luistorrerodri/EcoPlant-Platform/structure/concepto_visual.jpg

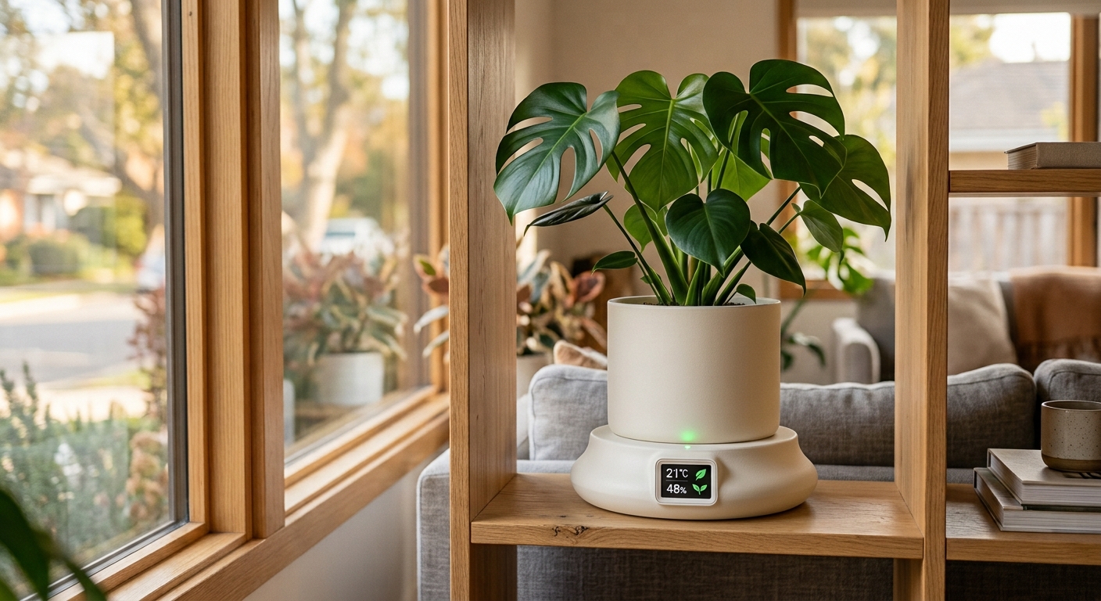
structure/concepto_visual.jpg
