luistorrerodri/EcoPlant-Platform/structure/preview/00_conjunto_dorso.png

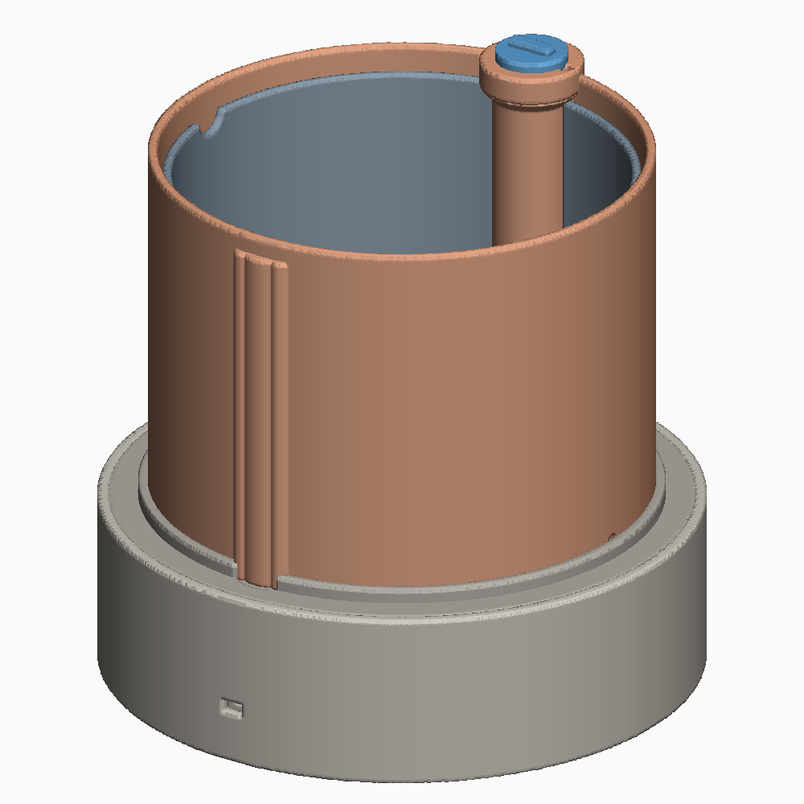
structure/preview/00_conjunto_dorso.png
