luistorrerodri/EcoPlant-Platform/README.md

# EcoPlant Platform 🌱

Plataforma IoT de riego inteligente para maceteros, construida de cero: desde el sensor hasta el dashboard, con la lógica de decisión centralizada en el servidor en lugar del microcontrolador.

Proyecto personal desarrollado como portfolio técnico durante un Máster en IoT, con el objetivo de cubrir el stack completo de un sistema IoT real: hardware, firmware, mensajería, persistencia de datos, visualización y control remoto.

## Qué hace

- Mide humedad de suelo y temperatura en tiempo real; el sensor de ambiente varía por dispositivo (presión atmosférica o humedad del aire, según el sensor que lleve cada uno — ver [`firmware/README.md`](firmware/README.md))
- Decide automáticamente cuándo regar según un umbral y una franja horaria configurables, **sin que la lógica viva en el microcontrolador**
- Verifica que cada orden de riego se ha ejecutado realmente, en lugar de asumirlo
- Detecta cuándo un dispositivo se desconecta de forma inesperada
- Comunicación cifrada con autenticación y autorización por dispositivo
- Permite riego manual bajo demanda desde la app móvil
- Guarda histórico de todas las lecturas para análisis posterior
- Pensado desde el diseño para escalar a múltiples dispositivos
- API multiusuario propia (registro, ubicaciones, dispositivos), consumida por una app móvil real (Android, misma base para iOS)
- Notificaciones push cuando un macetero se desconecta o termina de regar, a todos los móviles que comparten la cuenta, más un aviso semanal por macetero (domingo 11:00) con el último resumen de salud y un recordatorio de foto
- Estado conectado / sin conexión de cada macetero y historial de riegos (con etiqueta manual / automático) en la app
- Protección contra fuerza bruta en login y registro (bloqueo temporal por email e IP) y copia de seguridad cifrada de toda la plataforma hacia el PC
- Umbrales de riego y de estado personalizables por tipo de planta (catálogo de 43 tipos en 6 categorías: plantas, árboles, palmeras, hoja grande, colgantes y crasas), no un valor fijo para todas
- Consulta el pronóstico de lluvia antes de regar en exterior (Open-Meteo)
- Resumen periódico de salud de la planta (tiempo bajo el mínimo, saturación, ritmo de secado) a partir del histórico
- Calibración del sensor de humedad desde la app, sin reflashear el dispositivo
- Diagnóstico único de salud: combina el histórico de sensores con la última foto analizada por IA en un solo veredicto — si no hay foto, o la IA falla, cae automáticamente al diagnóstico por sensores sin perder nada
- Duración del riego también personalizable por tipo de planta, no solo los umbrales de humedad
- Pausa temporal del sensor (con lectura en vivo en la app) para poder moverlo o trasplantar la planta sin que un riego automático se dispare por error
- Ajuste automático (acotado y notificado) de la duración de riego de un dispositivo si el suelo sigue necesitando riego varios días seguidos pese al riego automático

## Arquitectura

```
     App móvil                              Grafana
(control, configuración,                  (histórico)
    diagnóstico)                               ▲
       │ HTTPS                                 │
       ▼                                   InfluxDB
Backend API (FastAPI + PostgreSQL)              ▲
       │          ▲                            │
       │ comando  │ config (polling 60s)        │
       ▼          │                            │
   Mosquitto (broker MQTT, mTLS) ────────► Node-RED
       ▲                              (decide riego automático,
       │ sensores / estado             formatea datos para InfluxDB)
       │
  ESP32 (sensores + bomba)
```

Todo corre sobre una Raspberry Pi en red local. El ESP32 **solo mide y ejecuta comandos** — nunca decide. La decisión de regar automático (umbral de humedad, franja horaria, tiempo desde el último riego) se evalúa en Node-RED a partir de la configuración que el backend le sirve (sondeada cada 60s desde Postgres), y publica un comando MQTT cuando corresponde; el riego manual y toda la configuración pasan por la app, no por Node-RED. Esta separación es la decisión de arquitectura central del proyecto: permite cambiar la lógica de riego, añadir machine learning más adelante, o gestionar decenas de dispositivos, sin volver a flashear ni un solo ESP32. Node-RED no tiene interfaz propia — es pura orquestación entre MQTT, InfluxDB y el backend (ver [`docs/architecture.md`](docs/architecture.md)).

Ver [`docs/architecture.md`](docs/architecture.md) para el detalle de cada decisión de diseño.

## Stack

| Capa | Tecnología |
|---|---|
| Sensores | sonda capacitiva de humedad de suelo + RTC DS1307 en todos los dispositivos; sensor de ambiente varía por dispositivo (BMP280 en `macetero01`, DHT22 en `macetero02` — ver [`firmware/README.md`](firmware/README.md)) |
| Microcontrolador | ESP32 DevKit (Arduino framework, PlatformIO) |
| Mensajería | MQTT (Mosquitto) |
| Orquestación / lógica | Node-RED |
| Persistencia | InfluxDB 2.x (series temporales) |
| Visualización | Grafana (histórico, escalable por dispositivo) |
| Servidor | Raspberry Pi (Debian Bookworm, ARM64) |
| Acceso remoto | Caddy (proxy, solo expone `/ui` y `/api/*`) + Cloudflare Tunnel |
| Backend API | Python + FastAPI, PostgreSQL |
| App móvil | React Native + Expo (TypeScript), notificaciones push vía Firebase/FCM |

## Estado actual

- [x] Hardware validado (sensores, RTC, OLED, bomba)
- [x] Firmware de producción: mide, publica por MQTT, obedece comandos
- [x] Pipeline completo de datos: ESP32 → MQTT → Node-RED → InfluxDB → Grafana
- [x] Control completo desde la app: riego manual, pausa de sensor, umbral y horario configurables en caliente (sin Node-RED Dashboard — retirado por redundante, ver `docs/architecture.md`)
- [x] Lógica de decisión de riego migrada completamente al servidor
- [x] Estructura de topics escalable para múltiples dispositivos (`device_id` dinámico)
- [x] Configuración persistente entre reinicios de la plataforma
- [x] Ciclo cerrado: el dispositivo confirma cada riego ejecutado
- [x] Detección de dispositivos desconectados (MQTT Last Will and Testament)
- [x] Firmware no bloqueante: el dispositivo sigue operativo durante el riego
- [x] Seguridad: autenticación por dispositivo, ACLs por topic y MQTT sobre TLS
- [x] Autenticación mutua (mTLS) con certificado por dispositivo
- [x] Acceso remoto seguro (reverse proxy con HTTPS): dashboard accesible desde fuera bajo demanda, sin abrir puertos en el router
- [x] Backend propio con modelo multi-usuario (usuario → ubicación → dispositivo)
- [x] App móvil: login, ubicaciones, dispositivos, histórico, riego manual y notificaciones push
- [x] Catálogo de tipos de planta: umbrales de riego y de estado relativos a cada tipo, no fijos
- [x] Integración meteorológica (Open-Meteo) para no regar en exterior si hay lluvia prevista
- [x] Resumen de salud de la planta (rules-based) y calibración del sensor de humedad desde la app
- [x] Diagnóstico visual con IA (foto + sensores), fusionado con el resumen por sensores en un único veredicto, con caída automática a sensores si no hay foto o la IA falla
- [x] Duración de riego y pausa temporal del sensor (con lectura en vivo), también personalizables por la app
- [x] Ajuste automático acotado de la duración de riego por dispositivo, a partir de su propio histórico de humedad, con notificación y tope configurable
- [x] Estado de conexión, historial de riegos manual/automático, varios móviles por cuenta y aviso semanal por macetero
- [x] Límite de intentos de login/registro y copia de seguridad cifrada (manual, hacia el PC)
- [ ] Ajuste de umbrales por tipo de planta a partir de histórico real agregado de todos los dispositivos (aprendizaje automático más amplio)

## Problemas reales resueltos

Una parte del valor de este proyecto está en los problemas de integración reales que surgieron y cómo se diagnosticaron — no solo en que "funcione". Detalle completo en [`docs/troubleshooting.md`](docs/troubleshooting.md), por ejemplo:

- **Sensor mal etiquetado**: un módulo vendido como BME280 resultó ser un BMP280 (sin sensor de humedad) tras leer su chip ID por I2C directamente — el fabricante había reutilizado la serigrafía.
- **Repositorio APT roto en Bookworm/ARM64**: fallo de verificación GPG persistente en el repositorio oficial de InfluxData para esa combinación de sistema, resuelto instalando desde el binario oficial con un servicio systemd propio en lugar de depender de `apt`.
- **Riegos en ráfaga**: al condicionar el riego a la confirmación del dispositivo, las órdenes se encolaron en el broker mientras el firmware bloqueaba. Resuelto con una ventana de guarda en la plataforma y, de raíz, con un firmware no bloqueante.
- **Dos implementaciones de TLS, dos criterios**: el mismo certificado era aceptado por un cliente y rechazado por el otro, primero por falta de SAN (Node.js ignora el Common Name) y después por el tipo de entrada del SAN (mbedTLS no evalúa las de tipo `iPAddress`). Resuelto con un certificado que satisface a ambas implementaciones.
- **Un ACL que deniega en silencio**: al añadir un topic MQTT nuevo, la configuración llegaba con éxito desde la app (`200 OK`) pero nunca al dispositivo — sin ningún error visible en ningún componente. Mosquitto descarta en silencio un publish/subscribe denegado por ACL; el fallo solo se confirmó leyendo el propio fichero de ACL en el servidor.
- **Un "nivel gratuito" que no lo era**: al integrar IA con visión para el diagnóstico de plantas, el proveedor elegido por tener plan gratuito devolvía `503` de forma sostenida — resultó ser el límite real de la cuenta disfrazado de aviso de capacidad, confirmado reproduciendo la misma petición fuera del código, directamente en la consola del proveedor.
- **Un patrón de años dejó de funcionar sin aviso**: subir una foto fallaba con `Unsupported FormDataPart implementation`, un error que no decía nada por sí solo. Causa real: un cambio de SDK sustituyó la implementación de `fetch` de la app, y la nueva ya no aceptaba el objeto `{uri, name, type}` que React Native lleva años usando para adjuntar ficheros — solo se detectó al ejecutar el código por primera vez en un dispositivo real, nunca falló en la compilación.
- **Un bug "arreglado" que seguía vivo en el extremo físico**: la duración de riego por tipo de planta se veía correcta en la app, la API y la base de datos — pero el ESP32 llevaba desde el primer despliegue regando siempre los mismos 9 segundos fijos, porque el firmware nunca llegó a leer ese valor del canal de configuración. Solo se descubrió cronometrando el riego real contra lo configurado, días después de dar el fix anterior por cerrado.
- **Un campo "relleno" que no se veía en pantalla**: en Android, un `TextInput` controlado a veces no pintaba el valor real tras cargarlo de forma asíncrona, aunque el estado de React ya lo tuviera — el dato estaba bien, la vista nativa simplemente no se actualizaba. Se resolvía solo al salir y volver a entrar (remontando el componente), lo que apuntó directamente a la solución: forzar ese remontaje con un `key` que cambia justo cuando los datos reales llegan.
- **Una hora que mentía sin avisar**: los riegos registrados salían con 1-2 h de adelanto. El RTC del ESP32 guarda la hora local de Madrid, pero `unixtime()` la presenta como si fuera UTC — un número "correcto" con la zona horaria equivocada, que nadie había visto porque ninguna pantalla mostraba esa hora hasta construir el historial. Corregido en el backend (sin reflashear) y con migración de los datos ya guardados.

## Estructura del repositorio

- [`firmware/`](firmware/) — código del ESP32 y guía de compilación/flasheo
- [`platform/`](platform/) — configuración de Node-RED, Grafana, y guía de instalación del stack en Raspberry Pi
- [`backend/`](backend/) — API multiusuario (FastAPI + PostgreSQL): usuarios, ubicaciones, dispositivos
- [`mobile/`](mobile/) — app móvil (React Native + Expo): consume la API del backend
- [`docs/`](docs/) — arquitectura, hardware, troubleshooting y roadmap detallados
- [`structure/`](structure/) — diseño CAD paramétrico del macetero físico (carcasa de impresión 3D), en Python/numpy; diseño verificado geométricamente pero aún sin imprimir

## Autor

Luis — Ingeniero de Telecomunicaciones, cursando Máster en IoT.

## Licencia

Repositorio publicado como portfolio técnico personal, con todos los derechos reservados — no es software de código abierto. Ver [`LICENSE`](LICENSE) para el detalle. Se puede consultar libremente con fines de evaluación (por ejemplo, procesos de selección), pero no reutilizar, copiar ni redistribuir sin autorización.
