luistorrerodri/EcoPlant-Platform/docs/architecture.md

# Arquitectura

## Principio de diseño central

**El ESP32 no decide nada.** Mide sensores, los publica por MQTT, y ejecuta un comando de riego cuando lo recibe — nada más. Toda la lógica (¿hay que regar ahora?, ¿qué umbral aplica?, ¿está dentro de la franja horaria permitida?) vive en el servidor, en Node-RED.

Esta decisión se tomó desde el inicio del proyecto, no como una refactorización posterior, y condiciona el resto de decisiones de arquitectura:

- **Escalabilidad**: añadir un macetero nuevo no requiere cambiar la lógica de decisión, solo dar de alta su configuración en el servidor.
- **Iteración rápida**: cambiar el umbral de riego, la franja horaria, o mañana un modelo de ML que decida en función del histórico, no requiere volver a flashear ningún dispositivo.
- **Mantenibilidad**: el firmware del ESP32 se mantiene simple y estable en el tiempo; la complejidad crece del lado del servidor, donde es más fácil de testear, versionar y depurar.

## Flujo de datos

1. El ESP32 lee sensores (humedad de suelo, temperatura, y un sensor de ambiente que varía por dispositivo — presión o humedad del aire, ver más abajo) cada 4 segundos y los publica como JSON en el topic MQTT `maceteros/{device_id}/sensores`.
2. Mosquitto (broker MQTT, corriendo en la Raspberry Pi) distribuye ese mensaje a quien esté suscrito.
3. Node-RED, suscrito a `maceteros/+/sensores` (comodín que captura cualquier dispositivo):
   - Reenvía los campos numéricos a InfluxDB para histórico.
   - Evalúa si toca regar, comparando la humedad recibida contra la configuración guardada (umbral, franja horaria, tiempo desde el último riego automático), configuración que el propio backend le sirve mediante un sondeo periódico (ver "Catálogo de tipos de planta..." en [`../platform/README.md`](../platform/README.md)).
4. Si la evaluación decide regar, Node-RED publica `REGAR` en `maceteros/{device_id}/comando`, construyendo el topic dinámicamente a partir del dispositivo que originó la lectura.
5. El ESP32, suscrito a ese topic, activa el relé de la bomba durante un tiempo fijo al recibir el comando — sin evaluar nada, solo ejecuta — y publica una confirmación en su topic de estado al terminar.
6. En paralelo, el riego manual desde la app publica exactamente ese mismo comando (`POST /api/devices/{id}/water` → backend → MQTT), reutilizando el mismo camino que el riego automático. Node-RED no tiene ningún control propio — ver la nota "Reparto final" más abajo.

## Por qué estas tecnologías

**MQTT sobre HTTP/REST**: bajo consumo, pensado para dispositivos con recursos limitados, y el patrón publicador/suscriptor encaja de forma natural con "muchos sensores publicando, un servidor escuchando" — especialmente de cara a escalar a múltiples dispositivos sin que cada uno necesite saber quién más existe.

**Node-RED como capa de orquestación**: permite iterar la lógica de negocio (reglas de riego, transformación de datos) de forma visual y rápida, sin recompilar nada, y tiene soporte de primera clase tanto para MQTT como para InfluxDB.

**InfluxDB (series temporales) en vez de una base de datos relacional para las lecturas**: los datos de sensores son fundamentalmente series temporales — una lectura, un timestamp, repetido miles de veces. InfluxDB está optimizado para ese patrón de escritura y consulta (agregaciones por ventana de tiempo, retención automática) de una forma en la que una base relacional genérica no lo está.

**Grafana para histórico, Node-RED Dashboard para control (decisión original, superada — ver nota 2026-10-02 más abajo)**: separación deliberada en las primeras semanas del proyecto, cuando el dashboard de Node-RED era el único control disponible, antes de que existiera la app. Grafana es una herramienta de solo lectura pensada para visualización de series temporales; forzarla a hacer control (botones, escritura) habría forzado su diseño. Node-RED, en cambio, ya tiene acceso directo a MQTT y al contexto de configuración, así que el control vivía ahí de forma natural en ese momento.

**Reparto final (2026-10-02): app = control, Grafana = histórico, Node-RED = orquestación pura.** El control real (riego manual, pausa de sensor, configuración por dispositivo) pasó a la app en cuanto existió, dejando el dashboard de Node-RED como una visualización redundante — un panel hardcodeado a `macetero01` que no escalaba a un segundo dispositivo sin duplicar paneles a mano. Se retiró por completo (gauges, gráfica, y un cluster de config muerto — un slider/desplegables que escribían una variable que el poller real sobreescribía cada 60s, detalle completo en `platform/README.md` § "Limpieza de Node-RED") en favor de Grafana, que con una variable de dispositivo (`${device}`, alimentada dinámicamente desde `v1.tagValues()`) sí escala a cualquier número de dispositivos sin tocar el dashboard. Node-RED se queda únicamente como lo que el título de esta sección ya decía que era: orquestación (MQTT ↔ InfluxDB ↔ backend), sin interfaz propia de usuario.

## Esquema de topics MQTT

```
maceteros/{device_id}/sensores    → publica el ESP32, escucha la plataforma
maceteros/{device_id}/comando     → publica la plataforma, escucha el ESP32
maceteros/{device_id}/estado      → publica el ESP32 (presencia y confirmaciones)
```

El `device_id` se define en el firmware con un único `#define`, a partir del cual se construyen los topics y el identificador de cliente MQTT. Desplegar el mismo firmware en un dispositivo nuevo requiere cambiar esa única línea.

La plataforma se suscribe con los comodines `maceteros/+/sensores` y `maceteros/+/estado`, de modo que recibe automáticamente los datos de cualquier dispositivo nuevo sin cambios de configuración. El `device_id` se extrae del propio payload (el firmware lo incluye) o, como respaldo, del segundo nivel del topic.

## Ciclo cerrado de riego

La orden de riego no se considera cumplida hasta que el dispositivo lo confirma:

1. La plataforma publica `REGAR` en el topic de comando del dispositivo.
2. El ESP32 acciona el relé y, al terminar, publica en su topic de estado un evento `riego_completado` con la duración real medida.
3. La plataforma registra ese evento como el último riego efectivo del dispositivo.
4. La condición de "han pasado 24 h desde el último riego" se evalúa contra la **confirmación**, no contra la orden.

La consecuencia práctica es que si un dispositivo está apagado o no responde, la plataforma no da el riego por hecho y lo reintentará cuando vuelva a estar disponible. Para evitar que ese reintento se convierta en una ráfaga de órdenes, existe además una ventana mínima de 60 segundos entre comandos consecutivos al mismo dispositivo, independiente de la confirmación.

### Detección de presencia (LWT)

Al conectarse, cada dispositivo registra en el broker un mensaje *Last Will and Testament*: si la conexión se pierde de forma abrupta (corte de alimentación, cuelgue, pérdida de WiFi), el propio broker publica `{"online": false}` en el topic de estado del dispositivo. Tras una conexión exitosa, el dispositivo publica `{"online": true}`.

Ambos mensajes se publican con el flag *retained*, de modo que cualquier suscriptor que se conecte después conoce inmediatamente el estado actual de cada dispositivo sin esperar al siguiente mensaje.

### Pausa temporal del sensor

Mover la planta o manipular físicamente la sonda de humedad produce lecturas falsas (p. ej. el sensor al aire marca "muy seco"), que sin ninguna protección dispararían un riego automático no deseado. `POST /api/devices/{id}/pause-sensor` fija `devices.sensor_pausado_hasta` a 10 minutos en el futuro (duración fija en servidor, no configurable por request); mientras ese instante no haya pasado, `GET /api/internal/device-configs` expone `sensorPausado: true` y el nodo "Decisión riego" de Node-RED se abstiene de evaluar riego para ese dispositivo — mismo patrón que ya usa `lluviaPrevista`, un booleano más que Node-RED lee sin saber nada de por qué.

Autoexpira por timestamp, sin necesitar ningún job en segundo plano: pasados los 10 minutos, la siguiente consulta a `device-configs` ya lo ve como `false` por sí sola. `POST /api/devices/{id}/resume-sensor` permite reanudar antes de tiempo. No hace falta tocar el firmware para nada de esto: el OLED del dispositivo ya muestra la humedad de suelo en vivo en su propia rotación de pantallas, pero esa rotación (~20s por pantalla) es demasiado lenta para seguir el valor mientras se reposiciona la sonda a mano — así que el feedback "en tiempo real" vive en la app, no en el OLED: mientras `sensorPausado` está activo, `DeviceDetailScreen.tsx` baja el `refetchInterval` de `GET /devices/{id}/latest-readings` de 15s a 3s (ver más abajo § "Calibración del sensor de humedad" — es el mismo endpoint sin agregar, no el histórico de `/readings`), lo bastante rápido para notar el cambio al mover la sonda sin tocar el firmware ni añadirle lógica nueva.

## Diseño del firmware

El `loop()` del ESP32 no bloquea en ningún punto de su operación normal. El riego se implementa como una pequeña máquina de estados basada en `millis()`:

- Al recibir un comando, se activa el relé y se registra el instante de inicio.
- En cada vuelta del `loop()` se comprueba si ha transcurrido la duración configurada; si es así, se apaga el relé y se publica la confirmación.
- Una orden que llegue mientras hay un riego en curso se descarta, en lugar de encolarse.

La consecuencia es que durante el riego el dispositivo sigue publicando lecturas, procesando mensajes MQTT y manteniendo su conexión. La implementación anterior, basada en `delay()`, dejaba al ESP32 insensible durante todo el pulso de riego, lo que provocó que las órdenes se acumularan en el broker y se ejecutaran en cadena (ver [`troubleshooting.md`](troubleshooting.md#9-riegos-en-ráfaga-al-introducir-la-confirmación-del-dispositivo)).

Adicionalmente existe un tope de seguridad por hardware lógico: la duración efectiva del riego se acota a un máximo absoluto, de modo que un valor de configuración erróneo no puede dejar la bomba encendida indefinidamente.

## Seguridad

La plataforma aplica tres capas independientes sobre la comunicación con los dispositivos.

### Autenticación

El broker no admite conexiones anónimas, y cada cliente demuestra su identidad con un **certificado propio** (autenticación mutua, mTLS) en lugar de usuario y contraseña: la plataforma tiene el suyo y **cada dispositivo el suyo**, todos firmados por la misma CA. El CN del certificado (`nodered`, `macetero01`...) es lo que el broker usa como identidad para las ACLs. Esta separación permite revocar el acceso de un macetero concreto —por ejemplo, si se pierde o se ve comprometido— sin afectar al resto del sistema, y elimina de paso el riesgo de una contraseña filtrada: no hay contraseña que filtrar.

### Autorización

La autenticación por sí sola no basta: un dispositivo legítimo no debe poder leer los datos de otros ni emitir órdenes. Las ACLs del broker restringen cada identidad a su ámbito:

```
user nodered
topic readwrite maceteros/#

user macetero01
topic write maceteros/macetero01/sensores
topic write maceteros/macetero01/estado
topic read  maceteros/macetero01/comando
topic read  maceteros/macetero01/config
```

La asimetría es deliberada: el dispositivo **publica** sus lecturas y su estado, pero solo **lee** comandos. Emitir órdenes de riego es privilegio exclusivo de la plataforma, incluso sobre el propio dispositivo.

### Cifrado en tránsito

Toda la comunicación MQTT viaja sobre TLS 1.2 en el puerto 8883. El puerto 1883 (sin cifrar) está cerrado.

Se emplea una **autoridad certificadora propia**: la CA firma el certificado del broker, y cada dispositivo lleva embebido el certificado de la CA para verificar que se conecta al broker legítimo y no a un suplantador. Es el mismo modelo de confianza de HTTPS, con la organización actuando como autoridad en lugar de una CA pública.

La clave privada de la CA vive en la propia Raspberry Pi (`~/certs/ca.key`), cifrada con una contraseña que solo conoce el operador — no está en texto plano ni la usa ningún servicio en su día a día, solo se necesita para firmar certificados nuevos. Es una mitigación razonable (un archivo robado no sirve de nada sin la contraseña) pero no equivale a mantenerla en una máquina separada del servidor: si la Pi se viera comprometida durante un tiempo prolongado, la contraseña podría capturarse la próxima vez que se usara. Moverla a una máquina offline queda como mejora pendiente.

La verificación es **mutua**: el dispositivo comprueba la identidad del broker (con `CA_CERT`) y el broker comprueba la identidad del dispositivo (con su certificado de cliente, `CLIENT_CERT`/`CLIENT_KEY`, firmado por la misma CA). El broker exige ese certificado antes de completar el handshake (`require_certificate`) y deriva la identidad de su CN en lugar de un usuario/contraseña (`use_identity_as_username`) — es el estándar en despliegues IoT de producción. Detalle de la generación de certificados de cliente en [`../platform/README.md`](../platform/README.md#certificados-de-cliente-mtls).

**Limitación conocida**: no hay lista de revocación (CRL). Revocar un dispositivo hoy es quitar su bloque de la ACL — el certificado seguiría siendo válido para TLS, pero sin ACL no podría hacer nada. Si una clave privada se comprometiera de verdad, la única garantía completa es regenerar la CA.

### Validez temporal

TLS valida el periodo de vigencia de los certificados, lo que exige que el dispositivo conozca la fecha real. El ESP32 sincroniza por NTP al arrancar, con la zona horaria peninsular y sus reglas de cambio estacional, y actualiza el RTC con esa referencia. El RTC queda como respaldo para operar sin red.

Esto resolvió además un problema anterior: la franja horaria de riego dependía de la hora del RTC, que podía quedar desajustada tras un reinicio.

### Acceso a los servicios

`adminAuth` protege el editor de flujos de Node-RED — solo el operador (Luis) tiene acceso, nunca el usuario final. Desde que el dashboard de Node-RED se retiró por completo (2026-10-02, ver "Reparto final" más arriba), `httpNodeAuth` ya no protege ninguna página de cara al usuario — el usuario final consulta su planta y riega exclusivamente por la app, que tiene su propia autenticación (JWT) completamente separada de Node-RED.

### Acceso remoto

El dashboard puede mostrarse desde fuera de la red local bajo demanda, sin exponer nada de forma permanente. Dos decisiones deliberadas:

- **Cloudflare Tunnel en vez de abrir un puerto en el router**: la Pi inicia una conexión saliente hacia Cloudflare; no hay ningún puerto escuchando conexiones entrantes desde internet en el router. Elimina de raíz la superficie de ataque típica de un port-forwarding casero (escaneos automatizados de puertos abiertos), a cambio de depender de un tercero para la ruta de acceso.
- **Un proxy local (Caddy) delante de Node-RED, no el túnel apuntando directamente a él**: Node-RED sirve el editor, la API de administración y el dashboard bajo la misma raíz, sin una separación de rutas pensada para exponer solo una parte. Caddy filtra por ruta y solo reenvía `/ui`, devolviendo 404 a cualquier otra cosa — así, aunque alguien obtenga la URL pública, lo único alcanzable es el dashboard, nunca el editor de flujos.

El túnel de `/ui` (Quick Tunnel) se levanta manualmente para cada demo — mientras no está corriendo, no hay nada expuesto a internet por ahí. **Nota 2026-10-02**: desde que se retiró por completo el dashboard de Node-RED (ver "Reparto final" más arriba), `/ui` ya no tiene ningún contenido que mostrar — la infraestructura (Caddy, el Quick Tunnel) se ha dejado tal cual, sin desmontar, pero hoy es una demo de una página vacía. Pendiente de decidir: desmontarla del todo, o reutilizar esa ruta para otra cosa. Con la app móvil llegó un segundo túnel, este sí permanente: dominio propio (`ecoplantplatform.com`) + túnel de Cloudflare con nombre, exponiendo solo `api.ecoplantplatform.com` → Caddy → backend. Tiene sentido que este segundo sí esté siempre activo, porque ahora hay una app de uso real detrás, no solo demos puntuales — ver [`../platform/README.md`](../platform/README.md#5-acceso-remoto-demo-pública-bajo-demanda) para ambos.

Grafana e InfluxDB emplean su propia autenticación, con el registro de usuarios deshabilitado y sin acceso anónimo.

### Protección contra fuerza bruta en login y registro (2026-10-26)

Con `api.ecoplantplatform.com` accesible 24/7, `POST /api/auth/login` y `/register` llevan límites propios (`backend/app/services/rate_limit.py`, en memoria del proceso — el backend es un único proceso `uvicorn`, así que no hace falta Redis):

- **5 fallos de login por email → ese email queda bloqueado 15 minutos**, incluso con la contraseña correcta mientras dura el bloqueo (si no, el bloqueo no frenaría nada). 5 y no 3: con 3, un despiste al teclear dejaría fuera a cualquiera de la familia, y un bloqueo corto basta para pasar de miles de intentos por hora a unos 20.
- **~20 fallos por IP en 15 minutos → esa IP bloqueada 15 minutos** (más holgado porque varias personas pueden compartir conexión).
- **Registro: máximo 5 por hora y por IP.**
- Respuesta `429` con `Retry-After` y mensaje en español ("Demasiados intentos. Vuelve a probar en N min."), que la app muestra tal cual. Un login con un email que no existe tarda lo mismo que uno con contraseña errónea (se verifica contra un hash falso), para no revelar qué emails están registrados; un login correcto solo resetea el contador de ese email, nunca el de la IP.
- **IP real detrás de Cloudflare**: el backend solo ve a `127.0.0.1` (Caddy/cloudflared). La IP del cliente se lee de `CF-Connecting-IP`, y esa cabecera **solo se acepta cuando el par directo es loopback** — desde la LAN, donde la app puede hablar directamente con la API, alguien podría falsificarla para evadir el límite por IP, pero el límite por email sigue valiendo igual. Los contadores se vacían al reiniciar el backend, y las claves recordadas están acotadas (10 000) para que probar millones de emails distintos no pueda llenar la memoria.

Las credenciales de los nodos de Node-RED se cifran con una clave propia (`credentialSecret`) en lugar de una autogenerada, de modo que una copia de seguridad de los flujos es restaurable en otra máquina.

## Modelo de datos en InfluxDB

- **Measurement**: `sensores`
- **Tag**: `device_id`
- **Fields**: `humedad_suelo`, `humedad_suelo_raw`, `temp_aire`, `presion`, `temp_suelo`, `estado`, `humedad_ambiente`

**No todos los dispositivos publican todos los campos de ambiente, a propósito.** `macetero01` lleva un BMP280 (`temp_aire`, `presion`, sin humedad); `macetero02` lleva un DHT22 (`temp_aire`, `humedad_ambiente`, sin presión) — ver [`../firmware/README.md`](../firmware/README.md) para qué sensor lleva cada dispositivo. Un campo que un dispositivo no mide nunca se publica con un valor falso (ni `0` ni `null` fabricado) — simplemente no aparece en su JSON, y como InfluxDB no exige un esquema fijo por punto, esa ausencia no genera ningún error en ningún punto de la cadena (Node-RED → InfluxDB → `NUMERIC_FIELDS` del backend → la app, que oculta el dato en vez de enseñar un "—" permanente o un cero). Es la misma lógica que ya aplicaba a `temp_suelo` cuando el DS18B20 está desconectado, extendida ahora a "distintos dispositivos pueden tener distintos sensores", no solo "un sensor puede fallar".

`humedad_suelo_raw` es la lectura cruda del ADC (sin convertir a porcentaje) — no se expone en el histórico ni en las gráficas de la app (no está en la lista blanca `NUMERIC_FIELDS` del backend), solo la usa internamente el endpoint de calibración del sensor (`POST /api/devices/{id}/calibrate`, ver "Calibración del sensor de humedad" más abajo) para capturar el punto seco/húmedo en el momento.

La distinción entre tag y field es deliberada. En una base de datos de series temporales, cada combinación única de tags genera una serie independiente: los tags están pensados para metadatos estables por los que se filtra y agrupa, no para valores que cambian con cada lectura.

Inicialmente `estado` (SECO / HUMEDO / OK…) se modeló como tag, lo que fragmentaba la serie de humedad en tantas series como estados posibles, cortando las gráficas cada vez que la planta cambiaba de estado. Se corrigió moviéndolo a field: además de resolver la fragmentación, es coherente con el hecho de que `estado` es un valor **derivado** de `humedad_suelo` mediante umbrales, no un dato independiente.

## Configuración persistente y editable

Los parámetros de cada macetero (umbral de humedad, franja horaria de riego permitido, duración del pulso de riego, tipo de planta) viven en PostgreSQL, como columnas de `devices` — editables desde la app vía `PATCH /api/devices/{id}`. Node-RED sigue siendo quien decide si riega (`Decisión riego`, sección "Ciclo cerrado de riego"), pero ya no es la fuente de verdad de la configuración: cada 60 segundos sondea `GET /api/internal/device-configs` (backend, `127.0.0.1:8000`, nunca sale de loopback) y vuelca la respuesta en su *global context* (`config_maceteros`), con exactamente la misma forma que tenía antes de esta migración:

```javascript
{
  "macetero01": {
    "humedadMin": 36,
    "horaInicio": 8,
    "horaFin": 21,
    "duracionRiegoMs": 9000
  }
}
```

Esta estructura, indexada por dispositivo desde el primer momento aunque hoy solo exista un macetero, es la que permite que escalar a múltiples dispositivos sea añadir una entrada al objeto, no rediseñar el sistema.

**Por qué un sondeo HTTP y no un nodo de Postgres en Node-RED ni una API nueva expuesta por Node-RED**: mover la configuración a Postgres exigía elegir quién habla con quién. Añadir un nodo de Postgres a Node-RED habría metido credenciales de base de datos en un sitio que hoy no las tiene, y construir una API nueva *dentro* de Node-RED habría ido contra el reparto de responsabilidades ya establecido (Node-RED es lógica de decisión + dashboard; FastAPI es la única superficie de API). Con un sondeo HTTP del lado de Node-RED hacia un endpoint del backend, el nodo **"Decisión riego"** — la automatización real, controlando una bomba física — no se toca en absoluto: solo cambia de dónde se rellena la variable que ya leía.

**`GET /api/internal/device-configs`** no usa el JWT de usuario del resto de la API — Node-RED no inicia sesión como nadie — sino un token estático compartido (cabecera `X-Internal-Token`, comparado con `secrets.compare_digest`), primer mecanismo de credencial de servicio a nivel HTTP en el backend. Es análogo a la identidad `backend-api` que ya existía en mTLS/MQTT (un servicio con su propia identidad, distinta de usuarios y dispositivos), solo que a nivel HTTP en vez de certificados. El riesgo real es bajo porque el tráfico nunca sale de `127.0.0.1` (Node-RED y el backend están en la misma Pi) — no pasa por Caddy, Cloudflare, ni el dominio público — pero el token evita que sea un endpoint abierto sin más dentro de esa confianza.

Elegir un tipo de planta desde la app (catálogo en `plant_types`, ver más abajo) solo rellena estos mismos campos con valores por defecto — se pueden seguir editando a mano después, y el ciclo de riego nunca lee el catálogo directamente, solo los valores ya copiados a `devices`.

## Calibración del sensor de humedad

Igual que los umbrales de riego, la calibración del sensor capacitivo de humedad de suelo (dos valores de referencia: lectura ADC en seco y en húmedo) dejó de estar fija en firmware para pasar a ser configuración editable — mismo principio de "el servidor decide y guarda, el ESP32 solo aplica" que el resto de la configuración persistente.

Columnas `devices.soil_dry_raw`/`soil_wet_raw` en Postgres, con los mismos valores que ya llevaba el firmware a mano como `server_default` (así añadir las columnas no cambia nada hasta que alguien recalibra de verdad). Se capturan desde la app (`POST /api/devices/{id}/calibrate`, body `{"punto": "seco" | "humedo"}`): el endpoint lee el valor crudo más reciente publicado por el dispositivo (`humedad_suelo_raw`, ver el modelo de datos de InfluxDB más abajo) con una consulta puntual sin agregar — `aggregateWindow()` sirve para gráficas e histórico, no para "qué marca el sensor ahora mismo" — lo guarda, y empuja la nueva calibración al dispositivo por el mismo topic MQTT retained que ya llevaba `humedadMin`/`humedadMax` (`maceteros/{id}/config`). El ESP32 la aplica en `soilMoisturePercent()` sin decidir nada por su cuenta.

Consecuencia práctica: recalibrar el sensor (cambio de sonda, de sustrato, desgaste) ya no exige recompilar ni reflashear — solo sacar el sensor a secar al aire y sumergirlo en agua, pulsando un botón en cada paso desde la pantalla "Calibrar sensor" de la app.

El mismo principio ("consulta puntual sin agregar para *lo que marca el sensor ahora mismo*, no la misma función que alimenta las gráficas") se reutilizó para `GET /devices/{id}/latest-readings`: la fila-resumen de la app y el banner de pausa del sensor necesitan el valor real en vivo, no el último punto de una serie agregada a 10 minutos como la que usa `GET /readings` para pintar un histórico — ver troubleshooting #34.

## Diagnóstico visual de la planta con IA

Complementario al resumen de salud estadístico (no un reemplazo): hay síntomas que ningún sensor de suelo puede ver — hojas amarillas, plaga, marchitez. El usuario sube una foto desde la app; el backend la junta con un resumen de los últimos 5 días de sensores (humedad, temperaturas, riegos — mismo criterio de no mandar la serie en crudo que `aggregateWindow()` en `get_readings`) y se la manda a un modelo de IA con visión para una valoración cualitativa en texto, con su propio veredicto de tres niveles (`bien`/`revisar`/`preocupante`) — deliberadamente distinto del `HealthVerdict` del resumen estadístico, porque un síntoma visual como una plaga no encaja en categorías pensadas para umbrales de humedad.

**La app muestra un único diagnóstico, no dos tarjetas separadas** (cambio de 2026-10-01, puramente de presentación — ningún endpoint ni esquema cambió). El prompt ya le pide al modelo que mezcle foto y sensores en un solo mensaje y marque contradicciones entre ambos, así que cuando hay una foto analizada con éxito, su mensaje ya es el diagnóstico completo — la app simplemente lo muestra como la tarjeta principal. Solo cuando no existe ninguna foto analizada con éxito todavía (dispositivo nuevo, o la única foto que hubo nunca falló al analizarse) la app cae al resumen estadístico (`health_summaries`) como diagnóstico. Los dos veredictos (`PhotoVerdict`/`HealthVerdict`) siguen siendo tipos distintos en el backend a propósito (ver el porqué un párrafo más abajo) — la app elige cuál mostrar, no los funde en uno. Un intento fallido de analizar una foto *nueva* no degrada nada: como no se sobreescribe `plant_photo_diagnoses` hasta tener una respuesta válida (ver más abajo), la última foto analizada con éxito sigue siendo la que se muestra hasta que una foto nueva se analice bien del todo.

**Proveedor y modelo, en concreto**: [Groq](https://groq.com/) (`app/services/plant_vision.py`), un proveedor de inferencia que aloja modelos abiertos de terceros (no entrena sus propios modelos, sino que los sirve muy rápido sobre hardware propio, LPUs en vez de GPUs). El modelo usado es `qwen/qwen3.8-27b` — Qwen es la familia de modelos abiertos de Alibaba Cloud; esta es su variante de 27B de parámetros con soporte de visión (recibe imagen + texto), la única con visión que Groq ofrece en este momento. Plan gratuito real de Groq para este modelo (documentado, no un trial que caduca, sin tarjeta): **30 peticiones/minuto, 1.000 peticiones/día, 8.000 tokens/minuto, 200.000 tokens/día** — de sobra para un uso a demanda de una persona (unas pocas fotos por semana), muy por debajo del límite incluso en pruebas intensivas.

**Solo se guarda la última foto** (`plant_photo_diagnoses`, una fila por dispositivo, se sobreescribe) — pero antes de sobreescribirla se usa: si ya había una foto anterior, se le manda al modelo junto con la nueva para que compare evolución (mejor/igual/peor), no solo el estado puntual. La foto vive como `bytea` en Postgres, no en el filesystem de la Pi — es el primer y único blob binario del proyecto, y no justificaba inventar una convención de almacenamiento en disco nueva para un solo fichero pequeño que además se sobreescribe.

Es el primer punto del proyecto donde contenido real (la foto) sale hacia un servicio de IA de terceros — misma clase de decisión que Open-Meteo (API externa aceptada cuando aporta algo que no se puede hacer local).

**Historial real de proveedor, tres intentos antes de asentarse**: primero Claude (API de pago de Anthropic) — funcionaba bien, pero implicaba un gasto (céntimos al mes) que Luis prefería evitar para este uso a demanda. Se cambió a Gemini buscando coste cero, pero su nivel "gratuito" resultó estar topado de verdad para la cuenta usada (Google AI Studio mostró un aviso de "Upgrade to unlock more" tras varias pruebas — no era un pico de demanda puntual como parecía al principio con los primeros 503). La solución final es Groq: tiene un plan gratuito real y publicado (límites por día/minuto documentados, no un trial que caduca), sin tarjeta, en una cuenta distinta de Google que no arrastra el uso previo del intento anterior. Lección para cualquier integración futura con un "nivel gratuito" de terceros: confirmarlo probándolo de verdad con la cuenta real que se va a usar, no fiarse solo de lo que dice la documentación — el mismo "gratis" significa cosas distintas según el proveedor y según el historial de la cuenta concreta.

**Deliberadamente no autoajusta nada.** Se consideró ir más lejos y que el propio sistema ajustara `humedad_min`/`humedad_max`/duración de riego a partir del veredicto — descartado por dos motivos: con una sola planta y fotos a demanda, no hay ni de lejos histórico suficiente para que un ajuste automático tenga base real (mismo criterio que el punto 4 del roadmap, más abajo), y automatizar un cambio sobre un actuador físico (la bomba) sin que una persona lo confirme es el único punto del proyecto que, si se equivoca, hace daño real a la planta sin que nadie se entere a tiempo. Si en el futuro se construye, sería como sugerencia que el usuario aprueba, nunca aplicada sola.

## Backend multiusuario

Node-RED resuelve bien la orquestación (sensores, lógica de riego), pero no tiene ni tenía previsto tener un modelo de usuarios — en su momento, cuando todavía tenía un dashboard propio, cualquiera con la contraseña del `httpNodeAuth` veía y controlaba todos los dispositivos por igual, sin ningún concepto de "esta planta es mía". El backend nuevo (FastAPI + PostgreSQL, en `backend/`) añade esa capa por delante, sin sustituir nada de Node-RED — es una pieza aditiva, un peer de Node-RED, no un reemplazo (y acabó, con el tiempo, asumiendo también todo el control de cara al usuario que antes vivía en el dashboard de Node-RED, hoy retirado — ver "Reparto final" más arriba).

**Por qué una base de datos relacional aparte, y no extender el *context store* de Node-RED**: el modelo `usuario → ubicación → dispositivo` es fundamentalmente relacional (claves foráneas, restricciones de unicidad, permisos por propietario) — forzar eso sobre un almacén de pares clave-valor pensado para configuración de dispositivos habría sido más frágil que levantar una base de datos que ya está diseñada para este problema. PostgreSQL en concreto, y no SQLite, porque el resto de la plataforma ya trata "instalar el servidor de base de datos real como servicio systemd" como la norma (InfluxDB es el precedente directo), y porque SQLite con varios workers de `uvicorn` tiene un problema real de bloqueo de escritura de un solo archivo.

**Autenticación con tokens revocables, no solo un JWT de larga duración**: el token de acceso es un JWT de corta duración (30 min por defecto); el de refresco es un secreto aleatorio cuyo *hash* se guarda en una tabla (`refresh_tokens`), no el valor en sí — igual que una contraseña. Esto es lo que hace posible un logout real y que cambiar la contraseña invalide las sesiones activas: con un JWT de refresco puro (sin estado en el servidor), no hay forma de revocar nada antes de que expire por sí solo.

**El código de reclamación de dispositivos**: cada macetero es un objeto físico, preflasheado con un `DEVICE_ID` fijo — no hay forma de que se autoprovisione ni de que "sepa" a qué usuario pertenece. Para asociarlo a una cuenta hace falta un secreto compartido fuera de banda, igual que un certificado de cliente se entrega físicamente a un dispositivo: el operador siembra el dispositivo (`POST /api/admin/devices/seed`) y obtiene un código de un solo uso, que se hashea igual que una contraseña y se entrega por otro canal (una pegatina en el macetero, un mensaje al usuario). El propio usuario lo introduce junto al `device_id` para reclamarlo. Sin CRL ni revocación de certificados de por medio, es el mecanismo más simple que sigue exigiendo prueba de posesión física del dispositivo.

Sin envío de emails: el registro activa la cuenta al momento, sin verificación por correo ni recuperación de contraseña por email (hay un `change-password` para quien ya tiene sesión). Detalle completo del modelo de datos, endpoints y despliegue en [`../platform/README.md`](../platform/README.md#6-backend-api) y [`../backend/README.md`](../backend/README.md).

## App móvil

React Native + Expo (TypeScript), en `mobile/`. Consume la API del backend por HTTP igual que cualquier otro cliente futuro (un portal web usaría exactamente los mismos endpoints) — construir primero la API y después la app fue deliberado, no hay nada que rehacer al pasar de una a otra.

**React Native + Expo, no nativo por plataforma**: mismo código para Android e iOS. Con Expo además se puede compilar la build de iOS en la nube (EAS Build) sin poseer un Mac — relevante aquí, porque el desarrollo se hace desde Windows.

**JWT en `SecureStore`, nunca en `AsyncStorage`**: los tokens de acceso y refresco se guardan cifrados con el keychain/keystore del sistema operativo, coherente con cómo el propio backend trata esos mismos tokens (nunca en claro). Un interceptor en el cliente HTTP reintenta la petición una vez tras un `401`, refrescando el token en segundo plano — verificado de verdad bajando temporalmente `ACCESS_TOKEN_EXPIRE_MINUTES` en el backend en vez de asumir que el código estaba bien.

**URL del servidor configurable en tiempo de ejecución, no fija en el código**: se guarda en `SecureStore` y se edita desde la app. Por defecto apunta al dominio fijo (`api.ecoplantplatform.com`, dominio propio + túnel de Cloudflare con nombre, ambos permanentes) — funciona igual en casa o fuera sin tocar nada; la IP de la LAN sigue disponible como alternativa manual. Esta pieza fue la que evitó tener que duplicar trabajo entre "desarrollar en casa" y "usar la app fuera": se construyó una vez, y solo cambió el valor por defecto cuando el dominio estuvo listo.

**Notificaciones push (Firebase Cloud Messaging)**: el backend pasa de solo publicar en MQTT a también **suscribirse** a `maceteros/+/estado` (el ACL de `backend-api` ya lo permitía, pensado para esto desde que se creó el certificado). Al detectar una desconexión inesperada o un riego completado, resuelve el propietario del dispositivo (`Device.location.owner`) y le envía una notificación (a todos los móviles de su cuenta, ver "Estado, historial y notificación semanal") a través de la API pública de push de Expo, que a su vez usa Firebase Cloud Messaging por debajo. Requirió una build de desarrollo propia compilada con EAS: Expo retiró el soporte de notificaciones push en Android dentro de Expo Go a partir del SDK 53, y además Google exige credenciales FCM V1 propias (no vale la infraestructura compartida antigua) — la clave de administrador de Firebase para esto vive cifrada en EAS, nunca en el repositorio; solo `google-services.json` (contenido público, identifica la app pero no autoriza nada) está versionado.

**Acceso por LAN, además del túnel**: Caddy pasa a escuchar también en la IP de la Pi en la red local, no solo en `127.0.0.1` — mismo nivel de confianza que ya tenían Node-RED/Grafana/InfluxDB (nada expuesto a internet, sin *port-forwarding* en el router). Permite desarrollar y usar la app en casa sin depender de tener el túnel de Cloudflare levantado.

## Próxima iteración: personalización por planta, exterior y meteorología

Con el dominio fijo y el backend multiusuario ya en producción, el siguiente bloque de trabajo apunta a que la app sea más útil planta a planta, no solo dispositivo a dispositivo. Son cuatro piezas relacionadas pero independientes; se documentan juntas aquí porque comparten el mismo modelo de datos de partida (`Device`/`Location`), pero se construyen y se despliegan en fases separadas.

**1. Catálogo de tipos de planta con valores por defecto — construido.** Al editar un dispositivo, el usuario elige un tipo de planta (tabla `plant_types`, 43 entradas: el catálogo inicial de doce plantas comunes de huerto/interior más un "personalizado" que replica los valores por defecto que ya tenía `macetero01`, ampliado después con 27 plantas y árboles de interior habituales en casa — incluida la curiosidad de que "planta del dinero" nombra popularmente a dos especies distintas, *Pachira aquatica* y *Plectranthus verticillatus*, catalogadas por separado para no confundirlas) que rellena los umbrales de cuidado (`Configuración persistente y editable`, más arriba) — incluida la duración del riego, `default_duracion_riego_ms` — como punto de partida editable, no como un valor fijo. `plant_types.category` agrupa el selector de la app en 6 categorías (plantas, árboles, palmeras, hoja grande, colgantes/trepadoras, crasas) en vez de una lista plana — necesario una vez el catálogo creció más allá de una docena de opciones. Los nombres son deliberadamente los comunes ("de la calle"), sin binomio científico — un nombre en latín no aporta nada a un usuario que no sea botánico, y los valores del catálogo son ilustrativos — específicos del calibrado de este sensor capacitivo, no un dato agronómico validado — pensados para refinarse con el uso real y, más adelante, con el punto 4. Esta pieza es también la que forzó a migrar la configuración de riego de Node-RED a Postgres (ver más arriba), porque sin eso no había dónde aplicar los valores por defecto ni forma de editarlos desde la app.

**2. Interior / exterior como atributo del dispositivo — construido.** Columna `environment` en `devices` (`"interior"` / `"exterior"` / sin especificar), editable desde la misma pantalla de configuración que el tipo de planta. Deliberadamente no toca el ciclo de riego ni Node-RED en esta pieza — es solo la bandera que el punto 3 (meteorología) todavía no consulta. Las plantas de interior no la necesitan y no deberían pagar ese coste (una llamada a una API externa) en cada ciclo de decisión, así que el valor por defecto es "sin especificar", no "exterior".

**3. Integración con una API meteorológica para exteriores — construido.** [Open-Meteo](https://open-meteo.com/), sin clave de API ni tarjeta (`backend/app/services/weather_client.py`). Reutiliza el mismo mecanismo de sondeo del punto 1: el backend calcula `lluviaPrevista` por dispositivo (`true` solo si `environment == "exterior"` y su `Location` tiene coordenadas, con un umbral de 50% de probabilidad en las próximas 6 horas y una caché en memoria de 45 minutos para no golpear el API en cada sondeo de 60s de Node-RED) y lo añade al mismo objeto que ya viaja por `GET /api/internal/device-configs`. **"Decisión riego" no sabe nada de `environment` ni de coordenadas** — solo gana una condición más (`&& sinLluviaPrevista`) sobre un booleano que ya le llega hecho. Diseñado a prueba de fallos: cualquier error consultando Open-Meteo (timeout, red caída, respuesta inesperada) se trata exactamente igual que "sin lluvia prevista" — el sistema nunca deja de regar por humedad baja a causa de un fallo ajeno de una API externa. Las coordenadas se guardan en `Location.latitude`/`longitude` (nuevas columnas opcionales), editables desde la app en la pantalla de cada ubicación.

**4. Aprendizaje automático por tipo de planta.** Dos primeros pasos relacionados, pero distintos de la pieza ambiciosa descrita aquí, ya están construidos: el ajuste automático de la duración de riego *por dispositivo* (2026-10-24, ver más abajo) y el resumen periódico de "salud de la planta" (`backend/app/services/health_analysis.py`) calcula un ritmo de secado real (%/hora) y lo compara contra un valor esperado por tipo de planta — pero ese valor esperado se derivó investigando guías de cuidado de plantas reales, no ajustando sobre histórico propio, así que es un punto de partida razonado, no la pieza de ML en sí. La pieza más ambiciosa y la que más depende de las otras tres: ajustar con el tiempo los umbrales del catálogo del punto 1 a partir de los datos históricos reales de InfluxDB (humedad, temperatura, riegos ejecutados) agrupados por tipo de planta, en vez de dejarlos fijos para siempre. Deliberadamente la última en construirse, por dos motivos: necesita que ya exista el campo "tipo de planta" del punto 1 para poder agrupar datos por planta, y necesita semanas o meses de histórico acumulado por tipo antes de que cualquier ajuste automático tenga sentido estadístico — construirla antes de tener datos suficientes sería optimizar sobre ruido. La primera versión razonable no es necesariamente un modelo entrenado: empezar por un ajuste estadístico simple (medias/percentiles observados por tipo de planta) y solo subir a un modelo más sofisticado si ese primer paso se queda corto, es el mismo criterio de "la solución más simple que resuelve el problema real" que ya ha guiado el resto del proyecto (ver por ejemplo la elección de PostgreSQL frente a alternativas más complejas, arriba).

**Orden de construcción recomendado**: 1 → 2 → 3, con 4 empezando en paralelo a 3 solo para *recopilar* datos etiquetados por tipo de planta (sin ajustar nada todavía), y su primera versión funcional (el ajuste estadístico simple) llegando después de acumular histórico real. Construir 3 o 4 antes que 1 obligaría a rehacerlos en cuanto exista el catálogo.

**Humedad ambiente en el resumen de salud (2026-10-02)**: con `macetero02` (DHT22) llegó el primer dispositivo que mide humedad relativa del aire, y `health_analysis.py` pasó a usarla, no solo a guardarla. Fundamento real, no un umbral inventado: la velocidad de evaporación del sustrato la rige el déficit de presión de vapor del aire (la base de ET0/Penman-Monteith, el estándar agronómico para programar riego) — a más humedad relativa, menos déficit, evaporación más lenta; el mismo nivel de saturación del sustrato es por tanto un riesgo de pudrición mayor en aire húmedo (el agua tarda más en irse sola) que en aire seco. Aplicado de forma deliberadamente conservadora y unidireccional: un ambiente húmedo (`>70%` de media en la ventana) puede adelantar el veredicto `revisar_drenaje` a un nivel de saturación más bajo del que ya lo dispara por sí solo (`30%` del tiempo en vez del `50%` normal) — nunca al revés, un ambiente seco no silencia ni suaviza ninguna alarma existente, para no arriesgarse a ocultar un problema real de riego por una variable secundaria. Un ambiente seco (`<40%`) sí se usa, pero solo como texto explicativo (nunca cambia el veredicto): aclara que parte de una sequedad de suelo detectada, o un secado más rápido de lo esperado para el tipo de planta, puede deberse al aire seco del entorno y no a un fallo del riego automático. Dispositivos sin sensor de humedad ambiente (`macetero01`, BMP280 sin higrómetro) tienen este valor a `None` en todo momento — cero cambio de comportamiento para ellos, mismo patrón de campo opcional por dispositivo que el resto de la plataforma.

**Ajuste automático de la duración de riego (2026-10-24) — primera pieza real del punto 4 del roadmap, mucho más acotada que la idea original.** Tras varios días de uso real, Luis notó que algunos dispositivos necesitaban riego varios días seguidos — señal de que la duración configurada se quedaba corta para ese sustrato/maceta concreto. En vez de la pieza ambiciosa descrita en el punto 4 (ajustar umbrales de *todo el catálogo* a partir de histórico agregado por tipo de planta, todavía sin construir), esto es una pieza mucho más pequeña y ya en producción: ajustar la duración de riego *de un dispositivo concreto* cuando su propio histórico reciente lo pide.

- **Señal de entrada deliberadamente ajena al origen del riego**: se basa en que el veredicto `revisar_riego` (calculado solo a partir de `pct_tiempo_bajo_minimo`, una lectura real de humedad de suelo) salga dos veces seguidas en el resumen periódico — nunca en contar eventos de riego. `watering_events` solo distingue un riego manual de uno automático de forma aproximada (ver "Estado, historial y notificación semanal" y "Limitaciones conocidas"), así que cualquier diseño que contara riegos se habría visto falseado por un riego manual de prueba; el veredicto por humedad no tiene ese problema porque no le importa qué disparó el riego, solo si el suelo se recupera o no.
- **Dispara una vez por racha nueva, no en cada resumen mientras el problema persiste**: `health_scheduler._maybe_auto_tune_duration()` solo actúa cuando el resumen anterior YA era `revisar_riego` pero el de antes de ese no lo era — es decir, en la transición a una racha de 2, no en la 3ª, 4ª... vez consecutiva. Si el problema no se resuelve con el `+1s`, hace falta que pase (o vuelva a pasar) para que se ajuste de nuevo, hasta el tope.
- **Tope relativo a la última duración puesta por una persona, no un valor fijo para siempre**: `devices.duracion_riego_base_ms` guarda ese punto de referencia (igual a `duracion_riego_ms` en el momento de un `PATCH` humano, ya sea editado a mano o copiado de un tipo de planta) y el ajuste automático nunca deja que `duracion_riego_ms` supere `duracion_riego_base_ms + 4000` (confirmado con Luis: 1s por ajuste, 4s de margen total). Si una persona vuelve a tocar la duración más adelante, la base se resetea sola y el margen de 4s empieza de cero — el sistema nunca "pelea" en silencio contra un valor que alguien acaba de fijar a propósito.
- **Notificación siempre, nunca en silencio** (esta sí se envía en el momento, no se agrupa con el aviso semanal): cada ajuste manda un push ("Riego ajustado automáticamente...") — la misma razón que ya llevó a no autoajustar nada a partir del veredicto de la IA visual (ver más arriba): tocar un actuador físico sin que la persona se entere es el único punto del proyecto que, si se equivoca, puede hacer daño real sin que nadie lo note a tiempo. Aquí sí se permite el ajuste en sí (a diferencia de la IA visual) porque el rango está muy acotado (máximo 4s sobre un valor ya razonado) y la señal de entrada es una lectura de sensor repetida, no una interpretación de una sola imagen.

## Estado, historial y notificación semanal (2026-10-26)

Tras varios días de uso real (con una segunda persona compartiendo cuenta y los padres de Luis a punto de sumarse con otra), se añadió un bloque de mejoras de uso diario. Ninguna toca el firmware ni el principio de diseño central (el ESP32 sigue sin decidir nada).

**Conectado / sin conexión (`GET /api/devices/status`).** El estado se deduce del **último punto `humedad_suelo` en InfluxDB** (ventana de 7 días, caché de 10 s): ≤ 60 s de antigüedad → conectado, si no, "sin conexión · visto hace X". Se descartó suscribir el backend a más topics MQTT (LWT/`estado`) por dos motivos: ya existe el dato en InfluxDB sin tocar ACLs del broker, y un dispositivo puede estar "online" para MQTT pero con el sensor mudo — lo que le importa a la persona es que lleguen lecturas. La ruta `/status` está declarada antes que `/{device_id}` (si no, FastAPI la interpretaría como un id).

**Historial de riegos con origen manual/automático.** `GET /api/devices/{id}/watering-events` + pantalla "Historial de riegos" (botón en "Más información"). La columna nueva `watering_events.origen` se rellena así: el riego **automático** lo ordena Node-RED directamente por MQTT (el backend nunca ve la orden), mientras que el **manual** pasa por `POST /api/devices/{id}/water`, que deja un marcador en memoria (`watering_origin.py`); cuando llega la confirmación `riego_completado`, si hay marcador de ese dispositivo con menos de 90 s se etiqueta `manual` (y se consume), si no, `automatico`. Casos en los que se equivoca, asumidos: reinicio del backend a mitad de un riego manual (marcador perdido → sale automático) y orden manual que el firmware descarta porque la bomba ya estaba en marcha (el marcador se consume con el riego en curso). Los riegos anteriores al cambio quedan con `origen = NULL` y la app los muestra sin etiqueta. La opción exacta (etiquetar la orden y que el ESP32 la devuelva en la confirmación) exige reflashear y se deja para la próxima vez que se toque el firmware.

**Las horas de los riegos estaban desfasadas 1-2 h.** El RTC del ESP32 guarda la hora **local** de Madrid (se sincroniza por NTP con la zona horaria peninsular), pero `rtc.now().unixtime()` la presenta como si fuera UTC, así que el `timestamp` de cada `riego_completado` llegaba 1 h (invierno) o 2 h (verano) adelantado. Corrección en el backend, sin reflashear: `time_utils.device_unix_to_utc()` reinterpreta ese número como hora de Madrid y lo pasa a UTC (respetando el cambio de hora), y una migración de datos (`a8f2d6b41c93`) arregla los riegos ya guardados. Detalle en `docs/troubleshooting.md` #39. Las lecturas de sensores no se ven afectadas (las timestampa Node-RED al recibirlas).

**Varias instalaciones por cuenta (`push_tokens`).** Una persona o una familia comparten **una** cuenta en varios móviles (no se comparten dispositivos entre cuentas distintas). La columna `users.push_token` se sustituyó por la tabla `push_tokens` (token único, varios por usuario): cada notificación va a todos los móviles de la cuenta. Un token se reasigna si otra cuenta inicia sesión en ese móvil, se borra al cerrar sesión (`POST /api/auth/push-token/unregister`, con 5 s de tope en la app para no bloquear el logout sin red) y se purga solo cuando Expo responde `DeviceNotRegistered`. `POST /api/auth/push-token` conserva el mismo cuerpo, así que las apps ya instaladas siguen funcionando.

**Una notificación semanal por macetero, en vez de avisos de salud sueltos.** El resumen de salud se sigue **calculando cada 4 días** (el ajuste automático de riego necesita dos `revisar_riego` consecutivos para actuar, así que ese ritmo no se toca), pero ya no envía push. En su lugar, un job propio (`CronTrigger`, domingo 11:00 `Europe/Madrid`, con su zona horaria para sobrevivir a los cambios de hora) manda **una notificación por macetero** con el último resumen disponible y, si la última foto analizada tiene más de 7 días (o no hay ninguna), el recordatorio de subir una (`weekly_message.py`). Si el macetero aún no tiene datos suficientes se omite ese aviso. Esto unifica lo que antes eran dos mensajes distintos (resumen de sensores y recordatorio de foto cada 10 días). El job diario de cálculo pasó de las 09:00 a las 06:00 UTC: en verano las 09:00 UTC son las 11:00 de Madrid y habría coincidido al minuto con el aviso semanal.

**Copias de seguridad.** Manuales, hacia el PC, cifradas — ver [`../platform/README.md`](../platform/README.md#copia-de-seguridad). Se eligió "el PC tira de la Pi" y no un cron en la Pi porque lo que se quiere evitar es perder los datos si falla la tarjeta SD, y una copia dentro de la propia Pi no protege de eso.

**Cerrado: el pico de humedad al regar.** La sospecha era que la posición de la salida de agua respecto al sensor capacitivo provocaba un pico falso justo tras regar. Confirmado como resuelto reposicionando la salida; el ajuste es distinto en cada maceta, así que se hace a mano en cada una y no hay cambio de software asociado.

## Limitaciones conocidas y trabajo pendiente

- El *rate limiting* de login/registro (ver "Protección contra fuerza bruta") vive en memoria: se reinicia con el backend y asume un único proceso. Desde la LAN, la cabecera `CF-Connecting-IP` es falsificable, así que el límite por IP puede esquivarse desde dentro de casa (el de por email no). Tampoco hay CAPTCHA ni alertas de intentos fallidos.
- Un dispositivo desenganchado no se puede volver a reclamar sin que un administrador rote un código nuevo (el código es de un solo uso y no se restaura solo). Asumible con un único operador; habría que revisarlo si algún día hay varios administradores.
- Sin verificación de email ni recuperación de contraseña por correo — vive como mejora futura, no como parte de esta iteración.
- No hay lista de revocación (CRL): revocar un dispositivo comprometido de forma robusta exige hoy regenerar la CA, no solo quitarlo de la ACL.
- Los dispositivos no se pueden compartir entre cuentas distintas (cada macetero pertenece a una ubicación de un único usuario); varias personas lo comparten usando **la misma cuenta**, en varios móviles (ver "Estado, historial y notificación semanal"). Un token de notificaciones se asigna a una sola cuenta: si un móvil inicia sesión con otra, pasa a ser de esa.
- El acceso a Node-RED, Grafana e InfluxDB dentro de la red local es por HTTP sin cifrar — asumible por ser una red aislada. Solo el dashboard (`/ui`) sale al exterior, y lo hace vía Cloudflare Tunnel (HTTPS gestionado por Cloudflare) más un proxy local que bloquea todo lo demás; Grafana e InfluxDB nunca se exponen a internet.
- Un riego manual también bloquea el automático durante 24 horas (la confirmación de riego es la misma para ambos). Es el comportamiento deseado hoy. Desde 2026-10-26 el backend sí etiqueta cada riego como manual/automático, pero con una heurística aproximada (ver "Estado, historial y notificación semanal"); el ajuste automático de duración sigue basándose en el veredicto de humedad del sensor y no en contar riegos.
- La etiqueta manual/automático del historial es una inferencia del backend, no un dato del firmware: se equivoca si el backend se reinicia a mitad de un riego, o si el firmware descarta una orden manual porque la bomba ya estaba en marcha. Hacerla exacta exige etiquetar la orden y que el ESP32 la devuelva en la confirmación (reflashear): pendiente para la próxima vez que se toque el firmware. Los riegos anteriores al 2026-10-26 no tienen etiqueta.
- La copia de seguridad es manual (`platform/backup/backup-from-pi.ps1` desde el PC): no hay copia automática, así que los datos posteriores a la última copia se perderían si falla la tarjeta SD.
- No hay sensor de nivel de depósito, por lo que la plataforma no puede saber si hay agua disponible antes de ordenar un riego. Es la principal carencia funcional: la bomba puede llegar a trabajar en seco.
- El riego se dosifica por **tiempo**, no por volumen. Un caudalímetro permitiría dosificación volumétrica real y detectar la degradación de la bomba (menos caudal para el mismo tiempo de funcionamiento) — en estudio de compatibilidad con la bomba actual, no construido todavía.
- No hay actualización de firmware por red (OTA). Con el 73 % de la flash ocupada tras incorporar TLS, habilitarla requerirá ajustar el esquema de particiones.
