luistorrerodri/EcoPlant-Platform/mobile/README.md

# App móvil

App React Native (Expo, TypeScript) para EcoPlant Platform: login/registro, ubicaciones, reclamación y control de dispositivos, histórico con gráficos, historial de riegos (manual/automático), estado de conexión, riego manual y notificaciones push. Consume la misma API que cualquier otro cliente futuro (portal web incluido) — ver [`../backend/README.md`](../backend/README.md) para el contrato de la API, y [`../docs/architecture.md`](../docs/architecture.md#app-móvil) para el porqué de las decisiones de diseño.

## Requisitos

- Node.js 20+
- La app **Expo Go** ya no sirve para probar esto de verdad: las notificaciones push necesitan una build de desarrollo propia (ver más abajo)
- Backend en marcha y alcanzable desde el móvil — por el dominio fijo (`https://api.ecoplantplatform.com`, funciona en cualquier red con internet) o por LAN (`http://192.168.1.140:8080`)

## Arrancar en desarrollo

```bash
npm install
npx expo start --dev-client
```

Escanea el QR **desde la app EcoPlant instalada en el móvil** (no desde la cámara ni desde Expo Go). El código JavaScript recarga en caliente igual que con Expo Go — solo hace falta una build nueva cuando cambia algo nativo (nuevas librerías con módulos nativos, `app.json`, `google-services.json`).

## Build de desarrollo (EAS)

Necesaria para poder probar notificaciones push en Android (Expo las quitó de Expo Go desde el SDK 53).

```bash
npm install -g eas-cli
eas login
eas build --platform android --profile development
```

Descarga e instala el APK resultante en el móvil (enlace o QR al terminar la build, ~10-15 min). El perfil `development` está definido en `eas.json`.

**`development` no sirve para uso normal**: esa build no lleva el JS metido dentro, necesita `npx expo start --dev-client` corriendo y el móvil en la misma red — pensada para iterar rápido sin gastar build nueva en cada cambio (edición en caliente, igual que Expo Go). Para una build que funcione sola, fuera de casa, sin nada corriendo en ningún ordenador — para uso real o para enseñarla — usar el perfil `preview` (`eas build --platform android --profile preview`): el JS va embebido en el APK, como una app normal instalada. A partir de ahí, cualquier cambio de código vuelve a necesitar una build nueva.

## Notificaciones push (Firebase/FCM)

Requiere un proyecto de Firebase vinculado (uno ya creado para este proyecto, `ecoplant-51a78`):

1. `google-services.json` en la raíz de `mobile/`, referenciado en `app.json` (`android.googleServicesFile`) — es contenido público, seguro de subir al repositorio.
2. Una clave de cuenta de servicio de Firebase (Firebase Console → Configuración del proyecto → Cuentas de servicio → Generar nueva clave privada) subida a EAS con `eas credentials` → Android → Google Service Account → *Push Notifications (FCM V1)*. **Esta clave nunca se sube al repositorio** — vive cifrada en EAS.

Si se regenera el proyecto de Firebase o se pierde la clave, hay que repetir el paso 2.

## Diagnóstico visual con IA

`expo-image-picker` (cámara y galería) para la pantalla "Salud de la planta" — configurado como config plugin en `app.json` con los textos de permiso en español (`cameraPermission`/`photosPermission`). Sube la foto con `FormData`; `src/api/client.ts` detecta un cuerpo `FormData` y no le fija `Content-Type` a mano, para que `fetch` añada el boundary multipart correcto solo.

**Ojo con el formato del fichero en el `FormData`**: el patrón "clásico" de React Native (`formData.append("photo", {uri, name, type})`) dejó de funcionar en Expo SDK 57 — su `fetch` global (`expo/fetch`) solo acepta un `string`, un `Blob` real, o un objeto con `bytes()`. `submitPhotoDiagnosis()` (`src/api/devices.ts`) convierte el fichero local a un `Blob` real con `fetch(uri).then(r => r.blob())` antes de adjuntarlo — ver `docs/troubleshooting.md` #32 si esto vuelve a fallar tras actualizar el SDK.

La pantalla de salud (`DeviceHealthScreen.tsx`) fusiona este diagnóstico con el resumen por sensores en una única tarjeta: muestra el de la última foto analizada con éxito si existe (ya mezcla foto y sensores en su propio mensaje), y si no, cae al de sensores — ver `docs/architecture.md` § "Diagnóstico visual de la planta con IA".

## URL del servidor

No está fija en el código: se guarda en `SecureStore` y se edita desde la pestaña **Perfil** de la propia app (`src/config.ts`). Por defecto apunta al dominio fijo (`https://api.ecoplantplatform.com`, un túnel de Cloudflare con nombre — funciona igual en casa o fuera), pero se puede cambiar a la IP de la LAN (`http://192.168.1.140:8080`) si se prefiere ese camino durante el desarrollo.

## Estructura del proyecto

```
mobile/
├── app.json / eas.json       # configuración de Expo / EAS Build
├── google-services.json      # Firebase (contenido público)
├── App.tsx                   # providers (React Query, Auth) + navegación
├── src/
│   ├── config.ts              # URL de API por defecto, claves de SecureStore
│   ├── notifications.ts       # permiso, token de push, registro en el backend
│   ├── types/api.ts           # tipos TS que reflejan los schemas Pydantic del backend
│   ├── api/                   # un archivo por recurso: auth, locations, devices, plantTypes, notifications
│   │   └── client.ts           # fetch wrapper con reintento automático tras 401 (refresh token)
│   ├── auth/
│   │   ├── secureStorage.ts    # tokens y URL del servidor en Expo SecureStore
│   │   └── AuthContext.tsx     # sesión actual, login()/register()/logout()
│   ├── navigation/             # AuthStack (login/registro) vs AppTabs (ubicaciones/perfil)
│   ├── screens/
│   └── components/
```

## Autenticación

Mismo modelo que el backend (`docs/architecture.md` § Backend multiusuario): `access_token` corto (30 min) + `refresh_token` revocable. `src/api/client.ts` adjunta el token en cada petición y, si recibe `401`, intenta refrescar una vez antes de forzar el logout — probado de verdad bajando temporalmente `ACCESS_TOKEN_EXPIRE_MINUTES` en el backend.

## Verificación

Con el móvil en la misma red que el backend: registro/login, crear una ubicación, reclamar un dispositivo (`POST /api/admin/devices/seed` desde el Swagger del backend da el `device_id`+`claim_code`), ver su histórico, regarlo y comprobar que la bomba se activa de verdad. Apagar el dispositivo confirma que llega la notificación push de desconexión.
