luistorrerodri/EcoPlant-Platform/platform/README.md

# Plataforma

Instalación y configuración del stack del servidor sobre Raspberry Pi (Debian Bookworm, ARM64).

Componentes: **Mosquitto** (broker MQTT) · **Node-RED** (lógica y dashboard) · **InfluxDB 2.x** (series temporales) · **Grafana** (visualización) · **PostgreSQL** + **Backend API** (usuarios, ubicaciones, dispositivos).

---

## 1. Mosquitto

```bash
sudo apt install -y mosquitto mosquitto-clients
```

### ACLs

En `/etc/mosquitto/acl`:

```
# Plataforma: acceso completo al árbol de maceteros
user nodered
topic readwrite maceteros/#

# Dispositivo: solo sus propios topics
user macetero01
topic write maceteros/macetero01/sensores
topic write maceteros/macetero01/estado
topic read  maceteros/macetero01/comando
topic read  maceteros/macetero01/config
```

Cada dispositivo nuevo requiere su bloque de ACL correspondiente. El `user` de cada bloque ya no es una cuenta con contraseña propia (ver "Certificados de cliente (mTLS)" más abajo): con `use_identity_as_username` activado, Mosquitto toma este nombre directamente del **CN del certificado de cliente** presentado en el handshake TLS. Por eso el CN de cada certificado debe coincidir exactamente con el `user` de su bloque de ACL.

### Certificados TLS

Se crea una CA propia que firma el certificado del broker:

```bash
mkdir -p ~/certs && cd ~/certs

# CA (la clave se protege con contraseña y NO se copia al servidor)
openssl genrsa -des3 -out ca.key 2048
openssl req -new -x509 -days 3650 -key ca.key -out ca.crt

# Clave y petición de firma del servidor
openssl genrsa -out server.key 2048
openssl req -new -key server.key -out server.csr \
  -subj "/C=ES/ST=Alicante/L=Aspe/O=EcoPlant/CN=192.168.1.140"
```

**El archivo de extensiones es imprescindible.** Sin SAN, Node.js rechaza el certificado; con SAN únicamente de tipo `IP`, lo rechaza mbedTLS en el ESP32. La dirección debe figurar en ambas formas:

```bash
cat > server.ext << 'EOF'
subjectAltName = IP:192.168.1.140, DNS:192.168.1.140, DNS:raspberrypi, DNS:localhost
EOF

openssl x509 -req -in server.csr -CA ca.crt -CAkey ca.key -CAcreateserial \
  -out server.crt -days 730 -extfile server.ext
```

Verificación antes de instalar:

```bash
openssl verify -CAfile ca.crt server.crt
openssl x509 -in server.crt -noout -text | grep -A1 "Subject Alternative Name"
```

Instalación:

```bash
sudo cp ca.crt server.crt server.key /etc/mosquitto/certs/
sudo chown root:mosquitto /etc/mosquitto/certs/*
sudo chmod 640 /etc/mosquitto/certs/*

# Copia legible por Node-RED (es un certificado público, no una clave)
sudo mkdir -p /etc/mosquitto/ca_certificates
sudo cp ca.crt /etc/mosquitto/ca_certificates/
sudo chmod 644 /etc/mosquitto/ca_certificates/ca.crt
```

### Certificados de cliente (mTLS)

Hasta aquí el broker demuestra su identidad al cliente (TLS del lado servidor). Falta el sentido contrario: que cada cliente demuestre la suya al broker, con un certificado propio firmado por la misma CA. Esto sustituye por completo al usuario/contraseña como mecanismo de autenticación — la identidad pasa a ser el **CN del certificado**, no una contraseña que se pueda filtrar.

**Estos certificados se pueden generar en la propia Raspberry Pi**, donde ya vive `ca.key` (cifrada con contraseña — ver "Copia de seguridad" al final de este documento). No hay ninguna máquina separada dedicada a la CA; es una mitigación más débil que el aislamiento físico, documentada como mejora de seguridad pendiente en [`../docs/architecture.md`](../docs/architecture.md#cifrado-en-tránsito).

```bash
mkdir -p ~/certs/clients && cd ~/certs/clients

# Un certificado de cliente por identidad: uno por cada dispositivo
# (CN = su DEVICE_ID) y uno para la propia plataforma (CN = nodered).
for cn in macetero01 nodered; do
  openssl genrsa -out "$cn.key" 2048
  openssl req -new -key "$cn.key" -out "$cn.csr" \
    -subj "/C=ES/ST=Alicante/L=Aspe/O=EcoPlant/CN=$cn"
  openssl x509 -req -in "$cn.csr" -CA ../ca.crt -CAkey ../ca.key -CAcreateserial \
    -out "$cn.crt" -days 730
  openssl verify -CAfile ../ca.crt "$cn.crt"
done
```

El CN debe coincidir exactamente con el `user` del bloque de ACL correspondiente (ver arriba). `macetero01.crt`/`macetero01.key` se embeben en el firmware de ese dispositivo como `CLIENT_CERT`/`CLIENT_KEY` (ver [`../firmware/README.md`](../firmware/README.md)) — no se copian a la Raspberry Pi, viajan directamente al ESP32. `nodered.crt`/`nodered.key` sí van al servidor, para que el propio Node-RED se autentique como cliente:

```bash
scp nodered.crt nodered.key piluis@192.168.1.140:~/certs/
ssh piluis@192.168.1.140 'chmod 600 ~/certs/nodered.key'
```

**Revocación**: sin una CRL (lista de revocación), "revocar" un dispositivo hoy significa quitar su bloque de `/etc/mosquitto/acl` — el certificado seguiría siendo válido para el TLS, pero sin ACL no podría publicar ni leer nada. Si la clave privada de un dispositivo se viera comprometida de verdad, la única garantía real es regenerar la CA. Añadir una CRL queda como mejora futura.

### Dar de alta un dispositivo nuevo (p. ej. `macetero02`)

Tres pasos, por este orden — los dos primeros son en la Pi, el tercero desde Swagger:

**1. Certificado de cliente**, mismo procedimiento que arriba, solo que con el `cn` del dispositivo nuevo:

```bash
cd ~/certs/clients
cn=macetero02
openssl genrsa -out "$cn.key" 2048
openssl req -new -key "$cn.key" -out "$cn.csr" \
  -subj "/C=ES/ST=Alicante/L=Aspe/O=EcoPlant/CN=$cn"
openssl x509 -req -in "$cn.csr" -CA ../ca.crt -CAkey ../ca.key -CAcreateserial \
  -out "$cn.crt" -days 730
openssl verify -CAfile ../ca.crt "$cn.crt"
```

`macetero02.crt`/`macetero02.key` van directos al firmware de ese dispositivo (`secrets.h`, `CLIENT_CERT`/`CLIENT_KEY`) — no se quedan en la Pi, igual que con `macetero01`.

**2. Bloque de ACL**, en `/etc/mosquitto/acl` (el `user` debe coincidir exactamente con el `CN` de arriba):

```
user macetero02
topic write maceteros/macetero02/sensores
topic write maceteros/macetero02/estado
topic read  maceteros/macetero02/comando
topic read  maceteros/macetero02/config
```

```bash
sudo systemctl restart mosquitto
```

**3. Alta en el backend**, por Swagger (`/api/docs`), como usuario admin: `POST /api/admin/devices/seed` con `{"device_id": "macetero02", "name": "..."}` → guarda el `claim_code` (solo se muestra una vez). Luego, desde la app, "+ Añadir dispositivo" con ese `device_id` + `claim_code`, igual que con `macetero01`.

Hasta que no se complete el paso 3, el dispositivo puede conectar y publicar por MQTT sin problema (pasos 1-2 ya se lo permiten), pero Node-RED lo ignora con un aviso en el log (`Sin configuración para macetero02, no se evalúa riego`) — no es un error, es que todavía no tiene dueño ni configuración de riego.

### Configuración final

En `/etc/mosquitto/conf.d/iot.conf`:

```
listener 8883
cafile /etc/mosquitto/certs/ca.crt
certfile /etc/mosquitto/certs/server.crt
keyfile /etc/mosquitto/certs/server.key
tls_version tlsv1.2

require_certificate true
use_identity_as_username true

allow_anonymous false
acl_file /etc/mosquitto/acl
```

`require_certificate true` obliga a todo cliente a presentar un certificado firmado por la CA configurada en `cafile` — sin él, el handshake TLS ni siquiera se completa. `use_identity_as_username true` hace que Mosquitto ignore cualquier usuario/contraseña que el cliente envíe y use en su lugar el CN del certificado como identidad para las ACLs. `password_file` ya no hace falta: la identidad la garantiza el certificado, no una contraseña.

```bash
sudo systemctl restart mosquitto
```

### Verificación

```bash
# Con certificado de cliente válido: debe funcionar (sin -u/-P, ya no se usan)
mosquitto_sub -h 192.168.1.140 -p 8883 --cafile ~/certs/ca.crt \
  --cert ~/certs/clients/nodered.crt --key ~/certs/clients/nodered.key \
  -t "maceteros/#" -v

# Sin certificado de cliente: debe fallar, el handshake TLS ni se completa
mosquitto_sub -h 192.168.1.140 -p 8883 --cafile ~/certs/ca.crt -t "maceteros/#" -v

# Sin cifrar: debe fallar (no hay listener en 1883)
mosquitto_sub -h 192.168.1.140 -p 1883 -t "maceteros/#" -v

# Certificado de un dispositivo leyendo topics ajenos: conecta (CN válido),
# pero la ACL no entrega nada fuera de maceteros/macetero01/*
mosquitto_sub -h 192.168.1.140 -p 8883 --cafile ~/certs/ca.crt \
  --cert ~/certs/clients/macetero01.crt --key ~/certs/clients/macetero01.key \
  -t "maceteros/#" -v
```

> Al conectar hay que usar la **misma dirección** que figura en el certificado del servidor. Con `localhost` la validación del nombre falla aunque el broker responda.

### Arranque tras un reinicio

El `.service` de fábrica de `apt` usa `network.target` (arranca en cuanto existe el subsistema de red, no cuando ya está configurada de verdad) en vez de `network-online.target` — la misma imprecisión que causó el fallo real de Caddy tras un apagón (troubleshooting #19). Aquí el riesgo es bajo porque el `listener` no fija una IP concreta (escucha en todas las interfaces), pero se corrige igualmente por consistencia con el resto de la pila, sin coste:

```bash
sudo mkdir -p /etc/systemd/system/mosquitto.service.d
sudo tee /etc/systemd/system/mosquitto.service.d/override.conf > /dev/null << 'EOF'
[Unit]
After=network-online.target
Wants=network-online.target
EOF
sudo systemctl daemon-reload
sudo systemctl restart mosquitto
```

---

## 2. Node-RED

```bash
bash <(curl -sL https://raw.githubusercontent.com/node-red/linux-installers/master/deb/update-nodejs-and-nodered)
sudo systemctl enable --now nodered
```

Accesible en `http://<ip-raspberry>:1880` (editor) y `http://<ip-raspberry>:1880/ui` (dashboard).

### Paletas necesarias

Menú → *Manage palette* → *Install*:

- `node-red-dashboard`
- `node-red-contrib-influxdb`

### Autenticación

Node-RED distingue el acceso al editor del acceso al dashboard. Genera un hash por usuario:

```bash
node -e "console.log(require('/usr/lib/node_modules/node-red/node_modules/bcryptjs').hashSync(process.argv[1], 8));" '<password>'
```

En `~/.node-red/settings.js`:

```javascript
adminAuth: {
    type: "credentials",
    users: [{
        username: "admin",
        password: "<hash del admin>",
        permissions: "*"
    }]
},

httpNodeAuth: {
    user: "usuario",
    pass: "<hash del usuario de dashboard>"
},

credentialSecret: "<cadena larga y aleatoria>",
```

`credentialSecret` cifra las credenciales de los nodos (tokens, contraseñas) con una clave propia en lugar de una autogenerada por la instalación. Sin ella, un backup de los flujos no es restaurable en otra máquina. **Si se pierde, las credenciales guardadas hay que reintroducirlas a mano.** Se aplica en el siguiente Deploy.

### Persistencia del contexto

Los parámetros de riego se guardan en el *global context*. Sin esta configuración se pierden en cada reinicio:

```javascript
contextStorage: {
    default: {
        module: "localfilesystem"
    },
},
```

```bash
sudo systemctl restart nodered
```

### Conexión TLS al broker

En el nodo de configuración del broker MQTT:

| Campo | Valor |
|---|---|
| Servidor | `192.168.1.140` (no `localhost`: debe coincidir con el certificado) |
| Puerto | `8883` |
| Utilizar TLS | activado |

En la configuración TLS, con **"Utilizar claves y certificados de archivos locales"** marcado:

| Campo | Valor |
|---|---|
| Certificado CA | `/etc/mosquitto/ca_certificates/ca.crt` |
| Certificado | `/home/piluis/certs/nodered.crt` |
| Clave privada | `/home/piluis/certs/nodered.key` |
| Verificar certificado del servidor | activado |

Con mTLS, la pestaña *Seguridad* del broker (usuario/contraseña) queda vacía: la identidad de Node-RED ante el broker la demuestra el certificado de cliente, no una credencial. Rutas locales — nada de esto se sube al repositorio; `flows.json` solo guarda las rutas de archivo, no el contenido de la clave.

### Importar los flujos

Menú → *Import* → pegar el contenido de [`nodered/flows.json`](nodered/flows.json).

Tras importar hay que revisar: la configuración del broker MQTT (dirección, puerto TLS, ruta del certificado y credenciales), el token, organización y bucket del nodo de InfluxDB, y la cabecera `X-Internal-Token` del nodo `http request` que sondea `/api/internal/device-configs` (el valor real vive solo en `backend/.env` de la Pi — nunca se versiona, ver § "Catálogo de plantas y configuración de riego en Postgres").

### Arranque tras un reinicio

El `.service` de `nodered` (instalado por su script oficial) no tenía ninguna dependencia explícita de red — ni siquiera `network.target`. El riesgo real es bajo porque `uiHost` no está fijado a una IP concreta (escucha en todas las interfaces), pero se corrige por consistencia con el resto de la pila:

```bash
sudo mkdir -p /etc/systemd/system/nodered.service.d
sudo tee /etc/systemd/system/nodered.service.d/override.conf > /dev/null << 'EOF'
[Unit]
After=network-online.target
Wants=network-online.target
EOF
sudo systemctl daemon-reload
sudo systemctl restart nodered
```

---

## 3. InfluxDB 2.x

> El repositorio APT oficial de InfluxData falla la verificación GPG en Bookworm/ARM64 (`NO_PUBKEY DA61C26A0585BD3B`). La instalación desde el binario oficial es la vía fiable. Detalle en [`../docs/troubleshooting.md`](../docs/troubleshooting.md).

```bash
cd ~
curl -L -O https://download.influxdata.com/influxdb/releases/influxdb2-2.9.1_linux_arm64.tar.gz
tar xvzf influxdb2-2.9.1_linux_arm64.tar.gz
sudo cp influxdb2-2.9.1/influxd /usr/local/bin/
influxd version
```

Usuario de sistema y directorio de datos:

```bash
sudo useradd -rs /bin/false influxdb
sudo mkdir -p /var/lib/influxdb
sudo chown influxdb:influxdb /var/lib/influxdb
```

Servicio en `/etc/systemd/system/influxdb.service`:

```ini
[Unit]
Description=InfluxDB OSS 2.x
After=network-online.target
Wants=network-online.target

[Service]
User=influxdb
Group=influxdb
LimitNOFILE=65536
ExecStart=/usr/local/bin/influxd --bolt-path=/var/lib/influxdb/influxd.bolt --engine-path=/var/lib/influxdb/engine
KillMode=control-group
Restart=on-failure

[Install]
WantedBy=multi-user.target
```

```bash
sudo systemctl daemon-reload
sudo systemctl enable --now influxdb
```

### Configuración inicial

En `http://<ip-raspberry>:8086`, completar el asistente (opción *Configure Later* en el último paso; Telegraf no se utiliza) y crear:

- **Organización**: el nombre exacto debe coincidir con el configurado en Node-RED y Grafana, respetando mayúsculas y espacios.
- **Bucket**: `macetero_iot`

Después, en *Load Data → API Tokens*, generar un token con permisos de lectura y escritura sobre ese bucket. Se usa tanto en Node-RED (escritura) como en Grafana (lectura).

---

## 4. Grafana

El repositorio APT de Grafana sí funciona correctamente en este sistema:

```bash
sudo apt install -y apt-transport-https software-properties-common wget gnupg
sudo mkdir -p /etc/apt/keyrings/
wget -q -O - https://apt.grafana.com/gpg.key | gpg --dearmor | sudo tee /etc/apt/keyrings/grafana.gpg > /dev/null
echo "deb [signed-by=/etc/apt/keyrings/grafana.gpg] https://apt.grafana.com stable main" | sudo tee /etc/apt/sources.list.d/grafana.list
sudo apt update
sudo apt install -y grafana
sudo systemctl enable --now grafana-server
```

Accesible en `http://<ip-raspberry>:3000` (credenciales iniciales `admin` / `admin`, que Grafana obliga a cambiar en el primer acceso).

### Endurecimiento

En `/etc/grafana/grafana.ini`:

```ini
[users]
allow_sign_up = false

[auth.anonymous]
enabled = false
```

```bash
sudo systemctl restart grafana-server
```

### Fuente de datos

*Connections → Data sources → Add data source → InfluxDB*:

| Campo | Valor |
|---|---|
| Query Language | **Flux** (no InfluxQL; InfluxDB 2.x lo requiere) |
| URL | `http://localhost:8086` |
| Organization | el nombre exacto de la organización |
| Token | el token generado en InfluxDB |
| Default Bucket | `macetero_iot` |

*Save & test* debe confirmar la conexión y el número de buckets encontrados.

### Dashboard

*Dashboards → New → Import* → pegar [`grafana/dashboard.json`](grafana/dashboard.json).

> El campo `estado` es de tipo texto. Incluirlo en una consulta con función de agregación `mean` produce el error `unsupported input type for mean aggregate: string`. Para consultarlo hay que usar `last` y hacerlo en una query separada de los campos numéricos.

**Escalable por variable de dispositivo (2026-10-02)**, en vez de un `device_id` fijo en cada panel. Imprescindible desde que hay más de un dispositivo — añadir `macetero02` reveló que el dashboard original tenía `"macetero01"` escrito a mano en las 3 queries, así que no mostraba nada de ningún dispositivo nuevo sin tocar el JSON a mano.

- **Variable `device`** (Dashboard settings → Variables → Add variable, tipo Query, datasource InfluxDB):
  ```flux
  import "influxdata/influxdb/v1"
  v1.tagValues(bucket: "macetero_iot", tag: "device_id")
  ```
  Se autoalimenta de los `device_id` que de verdad han escrito algo en el bucket — un dispositivo nuevo aparece solo en la lista en cuanto publica su primer punto, sin editar el dashboard.
- Cada panel usa `r.device_id == "${device}"` en su filtro Flux, no un valor fijo.
- **5 paneles** en total: Humedad Suelo, Temperatura Aire, Presión (los 3 originales) más **Temperatura de suelo** y **Humedad ambiente** (añadidos hoy, clonados de un panel existente cambiando `_field`). Con un dispositivo que no mide un campo concreto (p. ej. `presion` en `macetero02`, o `humedad_ambiente` en `macetero01`), ese panel sale "No data" — comportamiento esperado, no un fallo, mismo criterio de campo opcional por dispositivo que el resto de la plataforma.

Consulta Flux de ejemplo (ya con la variable):

```flux
from(bucket: "macetero_iot")
  |> range(start: v.timeRangeStart, stop: v.timeRangeStop)
  |> filter(fn: (r) => r._measurement == "sensores")
  |> filter(fn: (r) => r._field == "humedad_suelo")
  |> filter(fn: (r) => r.device_id == "${device}")
```

> `grafana/dashboard.json` resincronizado (2026-10-02) con la variable `${device}` y los 5 paneles — mismo patrón que `nodered/flows.json`: referencia, no fuente de verdad, se reexporta cada vez que el dashboard en vivo cambia de forma relevante.

---

## 5. Acceso remoto (demo pública bajo demanda)

> **Nota 2026-10-02**: el objetivo original de esta sección era enseñar el dashboard de Node-RED desde cualquier sitio — ese dashboard se retiró por completo (ver § "Limpieza de Node-RED" más abajo), así que `/ui` hoy no tiene ningún contenido detrás. La infraestructura (Caddy, el Quick Tunnel) sigue intacta y sigue funcionando tal cual se describe aquí, solo que proxyea a una página vacía. Pendiente de decidir: desmontarla, o reutilizar la ruta para otra cosa.

El objetivo es poder enseñar el dashboard desde cualquier sitio sin exponer nada permanentemente: nada de abrir puertos en el router, nada corriendo salvo cuando se decide hacer una demo. La solución combina dos piezas:

- **Caddy**, como proxy local que solo deja pasar `/ui` (el dashboard de Node-RED) y bloquea todo lo demás — el editor, la API de administración, InfluxDB, Grafana.
- **Cloudflare Tunnel** (`cloudflared`, modo *Quick Tunnel*), que da una URL pública HTTPS sin necesidad de dominio propio ni de tocar el router: la Pi abre una conexión saliente hacia Cloudflare, nunca al revés.

### Caddy

```bash
sudo apt install -y debian-keyring debian-archive-keyring apt-transport-https curl
curl -1sLf 'https://dl.cloudsmith.io/public/caddy/stable/gpg.key' | sudo gpg --dearmor -o /usr/share/keyrings/caddy-stable-archive-keyring.gpg
curl -1sLf 'https://dl.cloudsmith.io/public/caddy/stable/debian.deb.txt' | sudo tee /etc/apt/sources.list.d/caddy-stable.list
sudo apt update
sudo apt install caddy
```

En `/etc/caddy/Caddyfile`:

```
:8080 {
	bind 127.0.0.1 192.168.1.140

	@dashboard path /ui /ui/*
	handle @dashboard {
		reverse_proxy localhost:1880
	}
	handle {
		respond 404
	}
}
```

```bash
sudo caddy reload --config /etc/caddy/Caddyfile
```

Dos detalles que costó descubrir (ver [`../docs/troubleshooting.md`](../docs/troubleshooting.md#14-caddy-sirviendo-en-tls-y-bloqueando-todo-por-el-filtro-de-host)):

- Sin el prefijo `:8080` a secas (sin IP delante), Caddy asume HTTPS con su propia CA interna por defecto — de ahí que se use `bind 127.0.0.1` en vez de escribir `127.0.0.1:8080`, que además de fijar la interfaz de escucha, Caddy lo interpreta también como un filtro sobre la cabecera `Host`.
- `httpNodeAuth` (usuario/contraseña del dashboard, ya configurado en Node-RED) se mantiene detrás de Caddy sin cambios — sigue pidiendo login incluso llegando por el túnel.

`bind` acepta varias direcciones: además de `127.0.0.1` (para `cloudflared`, que corre en la propia Pi), se añadió la IP de la Pi en la LAN (`192.168.1.140`) para que la app móvil pueda hablar con la API directamente por WiFi durante el desarrollo, sin depender del túnel. Sigue sin haber nada expuesto a internet (no hay *port-forwarding* en el router) — es una extensión deliberada del mismo nivel de confianza que ya tenían Node-RED, Grafana e InfluxDB.

Verificación desde la propia Pi antes de tocar el túnel:

```bash
curl -s -o /dev/null -w "%{http_code}\n" http://localhost:8080/ui       # 401 (pide credenciales) o 200 con -u usuario:pass
curl -s -o /dev/null -w "%{http_code}\n" http://localhost:8080/         # 404 — el editor, bloqueado
curl -s -o /dev/null -w "%{http_code}\n" http://localhost:8080/flows    # 404 — la API de administración, bloqueada
```

### Cloudflare Tunnel

```bash
curl -L --output cloudflared.deb https://github.com/cloudflare/cloudflared/releases/latest/download/cloudflared-linux-arm64.deb
sudo dpkg -i cloudflared.deb
```

Se deja como un servicio que se enciende y apaga a mano — **sin `enable`**, para que no arranque solo con la Pi y no quede nada expuesto salvo cuando se decide mostrar el proyecto. En `/etc/systemd/system/cloudflared-demo.service`:

```ini
[Unit]
Description=Cloudflare Quick Tunnel (demo bajo demanda)
After=network-online.target caddy.service
Wants=network-online.target

[Service]
Type=simple
ExecStart=/usr/local/bin/cloudflared tunnel --url http://localhost:8080
Restart=on-failure
User=piluis

[Install]
WantedBy=multi-user.target
```

```bash
sudo systemctl daemon-reload
```

**Para hacer una demo:**

```bash
sudo systemctl start cloudflared-demo
sudo journalctl -u cloudflared-demo --no-pager -l | grep -i "trycloudflare.com"
```

La segunda línea saca la URL pública (algo como `https://palabras-al-azar.trycloudflare.com`) — cambia cada vez que se arranca el servicio, porque un *Quick Tunnel* no tiene hostname fijo (para eso haría falta un *named tunnel* con un dominio propio dado de alta en Cloudflare, ver nota abajo). Se comparte `<url>/ui`.

**Para cerrarla:**

```bash
sudo systemctl stop cloudflared-demo
```

**Limitación conocida**: sin cuenta de Cloudflare ni dominio propio, la URL de cada demo es distinta e impredecible — vale para "mira, te enseño el proyecto ahora mismo", no para dejar un enlace fijo en un CV o portfolio. Para eso está el túnel con nombre de la siguiente sección.

### Túnel con nombre + dominio fijo

Para la app móvil (necesita una URL que no cambie nunca, tanto en casa como fuera) se añadió un segundo túnel, permanente: dominio propio (`ecoplantplatform.com`, comprado en **Cloudflare Registrar** — al estar en la misma cuenta que el túnel, el DNS se gestiona solo, sin los rodeos que hicieron falta al intentarlo primero con un dominio gratuito de terceros) + un túnel de Cloudflare **con nombre** (`ecoplant-pi`, creado desde el panel de **Zero Trust → Networks → Tunnels & Mesh**, no con `cloudflared tunnel login` — ese comando exige tener ya un dominio dado de alta y falla si la cuenta no tiene ninguno).

Instalación del conector en la Pi (token generado al crear el túnel en el panel):

```bash
sudo cloudflared service install <token>
```

Esto instala `cloudflared` como servicio systemd propio (`cloudflared.service`, distinto de `cloudflared-demo`), habilitado al arrancar — a diferencia del Quick Tunnel, este si tiene sentido que esté siempre activo, porque ahora hay una app de uso real detrás, no solo demos puntuales.

El enrutado (qué hostname va a qué servicio local) se configura en **Zero Trust → Networks → Tunnels & Mesh → `ecoplant-pi` → Published application routes**: `api.ecoplantplatform.com` → `http://127.0.0.1:8080` (Caddy). Se usa `127.0.0.1` explícito y no `localhost` — con `localhost`, `cloudflared` puede resolver a `::1` (IPv6) en vez de a la IP donde escucha Caddy, dando `502` de forma intermitente y confusa. Se reservó `api.` para el backend a propósito, dejando la raíz del dominio y `www` libres para una futura landing page del proyecto.

**Bug real encontrado al verificar esto**: tras un reinicio de la Pi, Caddy no volvía a arrancar (condición de carrera con la red al asignar la IP de la LAN) — ver [`../docs/troubleshooting.md`](../docs/troubleshooting.md#19-caddy-no-arranca-tras-un-reinicio-de-la-pi-condición-de-carrera-con-la-red) para el diagnóstico completo y el arreglo (`override.conf` de systemd con `network-online.target` + `Restart=on-failure`).

---

## 6. Backend API

Servicio nuevo y aditivo (FastAPI + PostgreSQL) que añade usuarios, ubicaciones y permisos — el modelo *usuario → ubicación → dispositivo* — por delante de la plataforma existente. No sustituye nada: Node-RED sigue decidiendo cuándo regar y sirviendo su propio dashboard; este servicio es la capa de autenticación y API que se monta al lado. Detalle de diseño en [`../docs/architecture.md`](../docs/architecture.md), instrucciones de desarrollo en [`../backend/README.md`](../backend/README.md).

### PostgreSQL

```bash
sudo apt install -y postgresql
sudo -u postgres psql -c "CREATE ROLE ecoplant WITH LOGIN PASSWORD '<password>';"
sudo -u postgres psql -c "CREATE DATABASE ecoplant OWNER ecoplant;"
```

### Certificado de cliente (mTLS) para el backend

Mismo procedimiento que para `nodered`/`macetero01` (ver "Certificados de cliente (mTLS)" más arriba), con CN `backend-api`:

```bash
cd ~/certs/clients
openssl genrsa -out backend-api.key 2048
openssl req -new -key backend-api.key -out backend-api.csr -subj "/C=ES/ST=Alicante/L=Aspe/O=EcoPlant/CN=backend-api"
openssl x509 -req -in backend-api.csr -CA ../ca.crt -CAkey ../ca.key -CAcreateserial -out backend-api.crt -days 730
openssl verify -CAfile ../ca.crt backend-api.crt
mv backend-api.crt backend-api.key ~/certs/
chmod 600 ~/certs/backend-api.key
```

Añadir a `/etc/mosquitto/acl`:

```
# Backend API: publica comandos de riego para dispositivos reclamados
# y consulta estado/presencia (el histórico se lee de InfluxDB, no MQTT)
user backend-api
topic write maceteros/+/comando
topic read  maceteros/+/estado
topic read  maceteros/+/sensores
```

```bash
sudo systemctl restart mosquitto
```

### Token de InfluxDB (solo lectura)

En `http://<ip-raspberry>:8086` → *Load Data → API Tokens → Generate API Token → Custom API Token*: nombre `backend-api-readonly`, marcar **Read** (no Write) sobre el bucket `macetero_iot`. Distinto del token de Node-RED, que sí tiene escritura.

### Despliegue

```bash
git clone https://github.com/luistorrerodri/EcoPlant-Platform.git ~/EcoPlant-Platform
cd ~/EcoPlant-Platform/backend
python3 -m venv .venv
source .venv/bin/activate
pip install -r requirements.txt
cp .env.example .env   # rellenar con los valores reales (ver backend/README.md)
alembic upgrade head
```

Servicio systemd, **habilitado al arrancar** (a diferencia de `cloudflared-demo`: este servicio escucha solo en `127.0.0.1`, igual que Node-RED e InfluxDB, que también arrancan solos — lo que decide qué es alcanzable desde fuera es Caddy y el túnel, no si este servicio está vivo):

```bash
sudo nano /etc/systemd/system/ecoplant-backend.service
```

```ini
[Unit]
Description=EcoPlant Platform - Backend API (FastAPI)
After=network-online.target postgresql.service mosquitto.service
Wants=network-online.target

[Service]
Type=simple
User=piluis
WorkingDirectory=/home/piluis/EcoPlant-Platform/backend
EnvironmentFile=/home/piluis/EcoPlant-Platform/backend/.env
ExecStart=/home/piluis/EcoPlant-Platform/backend/.venv/bin/uvicorn app.main:app --host 127.0.0.1 --port 8000
Restart=on-failure

[Install]
WantedBy=multi-user.target
```

```bash
sudo systemctl daemon-reload
sudo systemctl enable --now ecoplant-backend
```

### Caddyfile

Nuevo bloque junto al de `/ui`, dentro del mismo `http://127.0.0.1:8080 { ... }`:

```
@api path /api/*
handle @api {
	reverse_proxy localhost:8000
}
```

```bash
sudo caddy reload --config /etc/caddy/Caddyfile
```

Con esto, `/api/docs` (Swagger) queda accesible por el mismo camino que `/ui` — local, por Caddy, y a través del Quick Tunnel cuando está levantado — mientras que el resto (editor de Node-RED, InfluxDB, Grafana, la propia base de datos) nunca se expone.

### Verificación

```bash
curl -s http://localhost:8000/api/health                                   # directo al backend
curl -s -o /dev/null -w "%{http_code}\n" http://localhost:8080/api/health   # a traves de Caddy, debe dar 200
curl -s -o /dev/null -w "%{http_code}\n" http://localhost:8080/flows        # debe seguir dando 404
sudo journalctl -u ecoplant-backend -n 20 --no-pager                        # confirmar que conecto a Postgres y MQTT sin errores
```

Con `cloudflared-demo` levantado, `<url>/api/docs` debe cargar el Swagger desde fuera, y permitir registrarse, crear una ubicación, reclamar un dispositivo y regarlo — igual que en local.

### Catálogo de plantas y configuración de riego en Postgres

La configuración de riego (`humedadMin`, `horaInicio`, `horaFin`, `duracionRiegoMs`) que hasta ahora vivía solo en el contexto de Node-RED (§2, "Persistencia del contexto") pasa a ser columnas de `devices` en Postgres, editables desde la app. Node-RED deja de ser la fuente de verdad y pasa a sondear al backend cada 60s — ver `docs/architecture.md` § "Configuración persistente y editable" para el porqué del diseño. Este cambio se despliega en dos partes, **en este orden**, porque la segunda depende de que la primera ya esté sirviendo los valores correctos:

**1. Backend (código versionado, despliegue normal):**

```bash
cd ~/EcoPlant-Platform
git pull
cd backend
source .venv/bin/activate
pip install -r requirements.txt   # sin cambios de dependencias en esta iteración, por si acaso
```

Añadir al `.env` (no está en `.env.example` por defecto — hay que generarlo, ver el comentario de esa sección en `backend/.env.example`):

```bash
python3 -c "import secrets; print(secrets.token_urlsafe(32))"
# pega el resultado como INTERNAL_API_TOKEN=... en backend/.env
```

```bash
alembic upgrade head
sudo systemctl restart ecoplant-backend
```

**Verificar antes de tocar nada más** (el objetivo es que este paso sea un no-op de comportamiento — si `macetero01` no sale exactamente así, parar aquí):

```bash
sudo -u postgres psql -d ecoplant -c \
  "SELECT device_id, humedad_min, hora_inicio, hora_fin, duracion_riego_ms FROM devices WHERE device_id = 'macetero01';"
# debe dar exactamente: 36 | 8 | 21 | 9000

curl -H "X-Internal-Token: <el token de arriba>" http://localhost:8000/api/internal/device-configs
# {"macetero01": {"humedadMin": 36, "horaInicio": 8, "horaFin": 21, "duracionRiegoMs": 9000}}

curl -H "X-Internal-Token: token-incorrecto" http://localhost:8000/api/internal/device-configs
# 401
```

**2. Node-RED (manual, en el editor — `flows.json` del repo es solo referencia, no se despliega solo):**

En la misma pestaña de flujo, añadir sin tocar el nodo **"Decisión riego"**:

- `inject` → repetir cada 60s, y marcar "Inject once after 0.1 seconds" para que cargue en cuanto se hace Deploy.
- `http request` → método `GET`, URL `http://localhost:8000/api/internal/device-configs`, cabecera `X-Internal-Token: <mismo token del .env>`, "Return" = objeto JSON parseado.
- `function`, nómbralo **"Aplicar config recibida"**:
  ```javascript
  if (msg.statusCode !== 200) {
      node.warn('No se pudo actualizar config_maceteros: HTTP ' + msg.statusCode);
      return null;
  }
  global.set('config_maceteros', msg.payload);
  node.status({fill: "green", shape: "dot", text: "actualizado " + new Date().toLocaleTimeString()});
  return msg;
  ```
  Cablear: `inject → http request → Aplicar config recibida`. Un `debug` a la salida ayuda a verificar en el primer despliegue (se puede desactivar después).

Después, para que el dashboard no pelee con el sondeo escribiendo `config_maceteros` a la vez: desconecta (no borres) el cable del slider de humedad hacia el nodo "Guardar Umbral", y el de los desplegables de horario hacia "Guardar horario" — los nodos "Leer umbral actual"/"Leer horario actual" se quedan como están, así el dashboard sigue mostrando el valor vigente, solo que de solo lectura. Deshabilita también (clic derecho → Disable) el nodo "Init config maceteros": con el sondeo cargando en cada Deploy, ese bootstrap fijo para `macetero01` ya no hace falta, pero se deja ahí, inerte, como red de seguridad reactivable a mano si el backend no responde en el arranque.

Deploy, y confirmar en el panel de debug que "Aplicar config recibida" da exactamente los mismos valores que el `curl` de arriba. Dejar correr al menos un ciclo completo sin tocar nada más y confirmar que no se dispara ningún riego inesperado — el sistema debe comportarse igual que antes de este cambio.

### Interior / exterior por dispositivo

Columna `environment` en `devices` (roadmap punto 2, `docs/architecture.md`). A diferencia del catálogo de plantas, esta migración no toca Node-RED ni necesita ningún token nuevo — es puramente aditiva y nadie la lee todavía:

```bash
cd ~/EcoPlant-Platform && git pull
cd backend && alembic upgrade head
sudo systemctl restart ecoplant-backend
curl -s http://localhost:8000/api/health
```

### Meteorología para riego exterior

Roadmap punto 3 (`docs/architecture.md`). Añade `latitude`/`longitude` a `locations` y un `lluviaPrevista` calculado (Open-Meteo) al mismo objeto que ya sirve `GET /api/internal/device-configs` — sin token nuevo, sin cambios en el poller de Node-RED.

**1. Backend**, igual que los pasos anteriores:

```bash
cd ~/EcoPlant-Platform && git pull
cd backend && alembic upgrade head
sudo systemctl restart ecoplant-backend
curl -s http://localhost:8000/api/health
```

**Verificar antes de tocar Node-RED**: `macetero01` no tiene `environment` fijado, así que debe seguir dando `lluviaPrevista: false` — es el chequeo de no-regresión:

```bash
curl -s -H "X-Internal-Token: <token>" http://localhost:8000/api/internal/device-configs
```

Para probar el cálculo real: `PATCH /api/locations/{id}` con unas coordenadas bajo lluvia de verdad ahora mismo (comprobable en cualquier web del tiempo) y `PATCH /api/devices/{id}` con `{"environment": "exterior"}` en un dispositivo de prueba apuntando a esa ubicación — el siguiente `curl` de arriba debe dar `lluviaPrevista: true`. Deshacer ambos cambios de prueba después.

**2. Node-RED (manual, en el editor)** — dos líneas dentro de **"Decisión riego"**, sin tocar nada más de la función. Justo después de `let haPasadoTiempo = ...`:

```javascript
let sinLluviaPrevista = !cfg.lluviaPrevista;
```

Y en el `if` final, añadir la condición al final:

```javascript
if (necesitaRiego && dentroHorario && haPasadoTiempo && segundosDesdeOrden > 60 && sinLluviaPrevista) {
```

`!cfg.lluviaPrevista` (no `=== false`) es a propósito: si la clave todavía no ha llegado (config vieja, redeploy en curso), se trata como "sin lluvia prevista" — nunca bloquea el riego por un dato que falta.

**Probar la rama de "no regar por lluvia" sin esperar a que llueva**: un nodo `inject` desechable que fuerce `global.get('config_maceteros').macetero01.lluviaPrevista = true` en memoria (no toca Postgres, se autocorrige solo en el siguiente sondeo de 60s), seguido de una lectura de humedad simulada por debajo del umbral. Confirmar en el debug que "Decisión riego" no dispara `REGAR`. Borrar el nodo de prueba (no solo desactivarlo) y hacer Deploy otra vez.

**3. Actualizar el snapshot de `flows.json`**: el archivo del repo lleva desde el roadmap punto 1 sin reflejar los cambios hechos a mano en el editor (poller, sliders desconectados, init deshabilitado, y ahora esto). En vez de parchear el archivo a mano, hacer un *Export* completo desde el propio Node-RED (menú → Export → todo el flujo → copiar) y sobrescribir `platform/nodered/flows.json` entero, para que vuelva a ser un reflejo fiel del estado real.

### Diagnóstico visual de la planta con IA

Tabla nueva (`plant_photo_diagnoses`) y tres endpoints nuevos bajo `/api/devices/{id}/photo-diagnosis*` — puramente aditivo, no toca Node-RED ni el ciclo de riego para nada.

```bash
cd ~/EcoPlant-Platform && git pull
cd backend && source .venv/bin/activate && pip install -r requirements.txt
```

Añadir `GROQ_API_KEY` al `.env` (gratis, sin tarjeta, en `console.groq.com` → API Keys):

```bash
echo "GROQ_API_KEY=tu_clave_aqui" >> .env
```

```bash
alembic upgrade head
sudo systemctl restart ecoplant-backend
```

**Aviso importante si en algún momento se cambia de proveedor de IA otra vez** (ya pasó una vez con este mismo campo — ver troubleshooting #22-#30, en concreto la #27): `echo "CLAVE=valor" >> .env` **añade** una línea, no sustituye la anterior. Cambiar de `ANTHROPIC_API_KEY` a `GEMINI_API_KEY` a `GROQ_API_KEY` sin borrar las líneas viejas dejó el `.env` con las tres a la vez — `Settings` (Pydantic, `extra="forbid"` por defecto) rechaza cualquier variable del `.env` que no tenga su campo correspondiente en `app/config.py`, y el backend entero se niega a arrancar (`ValidationError: extra_forbidden`), no solo el endpoint que la usa. Si esto vuelve a pasar, `grep -i api_key .env` para ver qué hay de verdad, y borrar a mano las líneas que ya no correspondan a un campo de `Settings`.

Verificar por Swagger (`/api/docs`), sin necesitar la app: `POST /api/devices/macetero01/photo-diagnosis`, subiendo una foto real como `multipart/form-data`. Debe devolver `200` con un `verdict` (`bien`/`revisar`/`preocupante`) y un `message` que mencione tanto lo que se ve en la foto como si coincide con los datos de los sensores de los últimos 5 días. El contexto exacto que se le manda al modelo queda en el log (`journalctl -u ecoplant-backend`, buscar `"Contexto de sensores"`) por si hace falta verificarlo sin adivinar por el texto de la respuesta.

### Duración de riego por tipo, pausa del sensor, y árboles en el catálogo

Tres piezas pequeñas en el mismo lote (2026-10-01): `duracion_riego_ms` ahora se puede editar y se copia del tipo de planta elegido (antes existía en el catálogo pero nada la aplicaba — ver troubleshooting #31); pausa temporal del sensor (`sensor_pausado_hasta`, ver `docs/architecture.md` § "Pausa temporal del sensor"); y tres árboles nuevos en `plant_types` (aguacate, manzano, limonero) agrupados por una columna `category` nueva. Solo la pausa del sensor toca Node-RED — las otras dos son puramente aditivas.

```bash
cd ~/EcoPlant-Platform && git pull
cd backend && source .venv/bin/activate && pip install -r requirements.txt
alembic upgrade head
sudo systemctl restart ecoplant-backend
```

**Node-RED (manual, en el editor — igual que el resto de cambios de `flows.json`):** en el nodo **"Decisión riego"**, añadir la lectura del nuevo campo y la condición de pausa, sin tocar nada más del cuerpo de la función:

```javascript
// justo despues de "let sinLluviaPrevista = !cfg.lluviaPrevista;"
let sensorPausado = !!cfg.sensorPausado;

// en el node.status({...}), sustituir el objeto completo por:
node.status({
    fill: sensorPausado ? "yellow" : (necesitaRiego ? "blue" : "grey"),
    shape: "dot",
    text: sensorPausado ? (deviceId + " PAUSADO") : (deviceId + " " + humedad + "% / " + cfg.humedadMin + "%")
});

// en el if final, añadir "&& !sensorPausado" al final de la condicion:
if (necesitaRiego && dentroHorario && haPasadoTiempo && segundosDesdeOrden > 60 && sinLluviaPrevista && !sensorPausado) {
```

Deploy, y verificar: `POST /api/devices/macetero01/pause-sensor` por Swagger, luego mirar el panel de debug/estado del nodo "Decisión riego" — el punto de estado debe pasar a amarillo con el texto "PAUSADO" en el siguiente mensaje de sensores, y no debe dispararse ningún riego aunque la humedad esté por debajo del mínimo. `POST /api/devices/macetero01/resume-sensor` debe devolverlo a la normalidad al instante (sin esperar los 10 minutos de autoexpiración).

### Ampliación del catálogo (27 plantas nuevas, 6 categorías, nombres sin latín) y lecturas en vivo

Cuatro commits pequeños, el mismo día que lo anterior, ninguno toca Node-RED — solo migraciones de catálogo y un endpoint de solo lectura nuevo:

```bash
cd ~/EcoPlant-Platform && git pull
cd backend && source .venv/bin/activate
alembic upgrade head          # 3 migraciones: catalogo ampliado, nombres sin latin, planta del dinero
sudo systemctl restart ecoplant-backend
```

El endpoint nuevo es `GET /api/devices/{id}/latest-readings` (valor real de cada campo, sin agregar — mismo patrón que ya usaba `/calibrate`): se añadió porque `/readings` agrega a `1m`/`10m`/`1h` según el rango pedido, y "el último punto" de ahí podía tardar hasta 10 minutos en reflejar un cambio real — se notaba mucho probando el sensor en vivo (el OLED cambiaba, la app no). Verificar por Swagger: `GET /api/devices/macetero01/latest-readings` debe devolver un valor por campo (`humedad_suelo`, `temp_suelo`, `temp_aire`, `presion`) que coincida con lo que marca el dispositivo en ese momento, no con un promedio de los últimos minutos.

Catálogo: tras el `alembic upgrade head`, `GET /api/plant-types` debe devolver 43 entradas, ninguna con nombre científico en latín (p. ej. `Pata de elefante`, no `Beaucarnea recurvata (pata de elefante)`), y dos entradas distintas para "planta del dinero" (`Árbol del dinero`, categoría `arbol`, y `Planta del dinero`, categoría `colgante`) — son especies distintas que comparten apodo popular, ver `docs/troubleshooting.md`.

### Segundo dispositivo con otro sensor de ambiente (`macetero02`, DHT22) — campo `humedad_ambiente`

Puramente aditivo, no migración. `humedad_ambiente` se suma a los campos que la API ya sabe consultar:

```bash
cd ~/EcoPlant-Platform && git pull
cd backend && source .venv/bin/activate
sudo systemctl restart ecoplant-backend
```

**Node-RED (manual, en el editor):** en el nodo **"Formatear para InfluxDB"**, sustituir el bloque final (desde `let estado = cfg` hasta `return msg;`) por:

```javascript
let estado = cfg
    ? calcularEstado(msg.payload.humedad_suelo, cfg.humedadMin, cfg.humedadMax)
    : msg.payload.estado;

let fields = {
    humedad_suelo: msg.payload.humedad_suelo,
    humedad_suelo_raw: msg.payload.humedad_suelo_raw,
    temp_aire: msg.payload.temp_aire,
    temp_suelo: msg.payload.temp_suelo,
    estado: estado
};

// presion y humedad_ambiente dependen del sensor de ambiente de cada
// dispositivo (BMP280 da presion, DHT22 da humedad_ambiente, ninguno
// da los dos) - solo se escribe el campo si el dispositivo lo publico
// de verdad, nunca con un valor por defecto. Ver firmware/README.md.
if (msg.payload.presion !== undefined) {
    fields.presion = msg.payload.presion;
}
if (msg.payload.humedad_ambiente !== undefined) {
    fields.humedad_ambiente = msg.payload.humedad_ambiente;
}

msg.payload = [fields, { device_id: deviceId }];
return msg;
```

(La función `calcularEstado()` de más arriba en el mismo nodo no cambia.) Deploy, y confirmar en el debug que `macetero01` sigue publicando exactamente los mismos campos que antes.

Ver [`../firmware/README.md`](../firmware/README.md) § "Varios dispositivos, sensores de ambiente distintos" para qué publica cada dispositivo, y "Dar de alta un dispositivo nuevo" más arriba para el certificado/ACL/alta de `macetero02` en sí.

Verificar: `GET /api/devices/macetero02/latest-readings` debe devolver `humedad_ambiente` con un valor real y `presion: null`; `GET /api/devices/macetero01/latest-readings` debe seguir exactamente igual que antes (`presion` con valor real, `humedad_ambiente: null`) — confirma que añadir el campo nuevo no afectó al dispositivo que ya funcionaba.

### Humedad ambiente en el diagnóstico (resumen de salud por reglas + IA de la foto)

Migración nueva (`f9c1a7e3b6d2`, añade `humedad_ambiente_avg` a `health_summaries`) más cambios de código en `health_analysis.py` y `plant_vision.py` — ver [`../docs/architecture.md`](../docs/architecture.md) § "Humedad ambiente en el resumen de salud" para el razonamiento agronómico completo:

```bash
cd ~/EcoPlant-Platform && git pull
cd backend && source .venv/bin/activate
alembic upgrade head          # f9c1a7e3b6d2: humedad_ambiente_avg en health_summaries
sudo systemctl restart ecoplant-backend
```

Verificar por Swagger con `macetero02` (una vez tenga un par de días de histórico real): `POST /api/devices/macetero02/health-summary/refresh` debe devolver `humedad_ambiente_avg` con un valor real; el mismo endpoint para `macetero01` debe seguir devolviendo `humedad_ambiente_avg: null` y un `verdict`/`message` idénticos a como se comportaba antes de este cambio — confirma que el nuevo campo no altera el diagnóstico de un dispositivo que no lo mide. Para probar la rama nueva del veredicto (`revisar_drenaje` disparado por ambiente húmedo + saturación moderada) hace falta que `macetero02` acumule unos días con el sustrato relativamente húmedo y el ambiente por encima del 70% — no es algo que se pueda forzar desde Swagger, toca esperar a que ocurra con uso real o, si urge probarlo antes, insertar puntos de prueba directamente en InfluxDB.

### Limpieza de Node-RED: configuración muerta y dashboard legacy eliminados (2026-10-02)

Al revisar la escalabilidad de cara a un tercer dispositivo, aparecieron dos restos de antes de que la configuración de riego se migrara a Postgres (roadmap paso 1, ver más arriba) — ninguno afectaba al pipeline real de datos, pero ambos eran hardcodeados a `macetero01` y no habrían escalado a un tercero sin duplicarse a mano.

**1. Cluster de configuración muerto.** Un slider "Umbral de riego (%)" y dos desplegables "Hora inicio/fin riego", conectados a funciones (`Guardar Umbral`, `Guardar horario`, `Leer umbral/horario actual`, la ya desactivada `Init config maceteros`) que leían/escribían la variable global `config_maceteros` — la misma que el poller real (`Aplicar config recibida`, alimentado por `GET /api/internal/device-configs`) sobreescribe entera cada 60s. Cualquier cambio hecho a mano con el slider se borraba solo en menos de un minuto; además el slider ni siquiera tenía cable de salida, así que en la práctica no hacía nada en absoluto. Se eliminaron 13 nodos en total (4 widgets, 5 funciones, 4 de soporte — inject/debug). El botón "Regar Ahora" de ese mismo grupo sí funcionaba de verdad (publicaba el comando por MQTT), pero duplicaba el botón de la app solo para `macetero01` y se saltaba el registro en `watering_events` — también eliminado.

**2. Dashboard "Monstera" completo eliminado.** La pestaña con los gauges/gráfica de `macetero01`, anterior a que existiera la app, quedó redundante frente a la app (vista completa por dispositivo) y Grafana (ya escalable, ver arriba) — decisión explícita de Luis: no construirla escalable aparte, directamente retirarla.

**Resultado**: la única vía de configuración de riego/pausa-sensor es ahora App → Backend → Postgres → Node-RED (solo lectura vía el poller) — confirmado por código que `POST /{device_id}/water`, `pause-sensor`/`resume-sensor` y `GET /api/internal/device-configs` operan exclusivamente sobre la fila de ese `device_id`, sin estado compartido entre dispositivos. Un tercer dispositivo no necesita ningún nodo nuevo en Node-RED para esto.

> `platform/nodered/flows.json` resincronizado (2026-10-02) tras esta limpieza — ya no tiene ninguno de los nodos borrados.

### Duración de riego real por dispositivo, y filtro de lecturas implausibles (2026-10-13)

Dos fixes encontrados tras varios días de uso real con `macetero02` — detalle completo en `docs/troubleshooting.md` #35 y #36.

**1. La duración de riego nunca llegaba al ESP32** (puramente cosmética hasta hoy: se veía bien en la app/API/BD, pero el firmware regaba siempre 9s fijos). Backend puramente aditivo, sin migración:

```bash
cd ~/EcoPlant-Platform && git pull
cd backend && source .venv/bin/activate
sudo systemctl restart ecoplant-backend
```

Requiere además **reflashear los dos dispositivos** (`macetero_produccion_6.ino` y `macetero02_dht22.ino`, ambos con el mismo cambio: nueva variable `duracionRiegoCfg` recibida por `mqtt_topic_config`). Tras el reinicio del backend, cualquier dispositivo ya configurado necesita un guardado más en `DeviceConfigScreen` (aunque sea el mismo valor) para que se dispare la primera publicación retenida con el campo `duracionRiegoMs` — sin eso, el dispositivo sigue con el valor de arranque (`TIEMPO_RIEGO = 9000ms`) hasta que alguien toque su configuración.

Verificar: cronometrar un riego real (no solo mirar la API) y confirmar que dura lo configurado en `DeviceConfigScreen`, no 9 segundos fijos — el log serie del dispositivo imprime `duracionRiegoMs=` al aplicar la config recibida.

**2. Filtro de rango plausible por campo** (`influx_client.PLAUSIBLE_RANGES`), aplicado como filtro Flux en `get_readings()`/`get_latest_value()` — mismo `git pull` + `systemctl restart` de arriba, sin migración. Además, el firmware de `macetero02` descarta ahora una lectura del DHT22 fuera de rango (`t < -20 || t > 60`, `h < 0 || h > 100`) antes de publicarla, igual que ya hacía `temp_suelo` con el DS18B20 desconectado.

Verificar: `GET /api/devices/macetero02/latest-readings` y el resumen de salud ya no deberían reflejar picos como ~121°C aunque existan puntos así en el histórico guardado antes del fix.

### Ajuste automático de la duración de riego, recordatorio de foto y nombre amigable en notificaciones (2026-10-24)

Migración nueva (`c4e8a2f91b7d`, añade `devices.duracion_riego_base_ms`) más cambios en `health_scheduler.py`, `notify.py`, `mqtt_client.py` y `routers/devices.py` — ver `docs/architecture.md` § "Ajuste automático de la duración de riego" para el razonamiento completo.

```bash
cd ~/EcoPlant-Platform && git pull
cd backend && source .venv/bin/activate
alembic upgrade head          # c4e8a2f91b7d: duracion_riego_base_ms en devices
sudo systemctl restart ecoplant-backend
```

Tres cambios de comportamiento a tener en cuenta:
- Las notificaciones de "Riego completado"/"Dispositivo desconectado" ahora muestran el nombre de la planta (`device.name`, o el `device_id` si no tiene nombre puesto) en vez del `device_id` en crudo.
- El aviso periódico de salud (cada ~4-5 días) dejó de mandar el mensaje de solo-sensores cuando la última foto analizada tenía más de 10 días. **Sustituido el 2026-10-26** por una notificación semanal por macetero (ver más abajo).
- Un dispositivo que acumule 2 resúmenes de salud seguidos en `revisar_riego` se alarga su `duracion_riego_ms` en 1s sola, hasta un máximo de `duracion_riego_base_ms + 4000`, y avisa por notificación. `duracion_riego_base_ms` se resetea solo al valor nuevo cada vez que una persona cambia la duración desde la app (a mano o al elegir tipo de planta) — vuelve a tener margen completo de 4s desde ahí.

Verificar: `alembic current` debe decir `c4e8a2f91b7d (head)`; un `PATCH /api/devices/{id}` con `duracion_riego_ms` debe devolver el dispositivo con `duracion_riego_base_ms` igual al nuevo valor (no es un campo expuesto en el schema de salida todavía, comprobar directo en Postgres: `SELECT duracion_riego_ms, duracion_riego_base_ms FROM devices WHERE device_id = '...'`).

### Protección de login, estado, historial de riegos, varios móviles y notificación semanal (2026-10-26)

Dos migraciones nuevas (cadena `c4e8a2f91b7d → a8f2d6b41c93 → e5b9c3a72d18`) y una dependencia nueva (`tzdata`). Razonamiento completo en `docs/architecture.md` § "Protección contra fuerza bruta…" y "Estado, historial y notificación semanal".

```bash
cd ~/EcoPlant-Platform && git pull
cd backend && source .venv/bin/activate
pip install -r requirements.txt      # tzdata (zona horaria Europe/Madrid; la Pi no la trae para Python)
alembic upgrade head                 # a8f2d6b41c93 y e5b9c3a72d18
sudo systemctl restart ecoplant-backend
```

Haz el `alembic upgrade head` y el `restart` seguidos: la primera migración **corrige las horas ya guardadas** de `watering_events` (el ESP32 mandaba la hora local de Madrid etiquetada como UTC, así que salían 1-2 h adelantadas) y el código nuevo ya guarda las horas bien; entre una cosa y otra, un riego registrado quedaría con la hora sin corregir (probabilidad despreciable, pero no los separes con una pausa larga). La segunda migración **copia el `push_token` de cada usuario a la tabla nueva `push_tokens`** y elimina la columna vieja — los móviles con la app antigua siguen recibiendo notificaciones sin reinstalar nada.

Cambios de comportamiento:
- **Login/registro con límites** (5 fallos por email → 15 min de bloqueo, etc.): `429` con mensaje en español. Se vacían al reiniciar el backend.
- **Nuevos endpoints**: `GET /api/devices/status` (conectado / sin conexión de todos tus dispositivos, según el último dato recibido en InfluxDB: ≤ 60 s = conectado), `GET /api/devices/{id}/watering-events` (últimos 30 riegos, `?limit=` hasta 100, con `origen`: `manual` / `automatico` / `null` para los anteriores a este cambio), `POST /api/auth/push-token/unregister` (la app lo llama al cerrar sesión).
- **Varios móviles por cuenta**: cada instalación registra su propio token; los tokens muertos (`DeviceNotRegistered`) se borran solos.
- **Resumen de salud sin notificación**: el cálculo cada 4 días sigue igual (el ajuste automático de riego lo necesita), pero ya no manda push. En su lugar, **cada domingo a las 11:00 (hora de Madrid)** llega una notificación por macetero con el último resumen y un recordatorio de hacer una foto si la última tiene más de 7 días o no existe. Sustituye al recordatorio de foto de 10 días. El cálculo diario pasó de las 09:00 UTC a las 06:00 UTC para no coincidir con esa hora en verano.
- La **etiqueta manual/automático** es una heurística del backend (riego completado en los 90 s siguientes a una orden manual) — ver limitaciones conocidas.

Verificar:
1. `alembic current` → `e5b9c3a72d18 (head)`. `journalctl -u ecoplant-backend -n 30` sin errores; `journalctl -u ecoplant-backend | grep "Aviso semanal"` debe mostrar la próxima ejecución en domingo a las 11:00 con el desfase de Madrid (`+01:00` o `+02:00`).
2. Un riego manual desde la app → en "Más información → Historial de riegos" aparece con la hora local correcta y la etiqueta *Manual*; el siguiente riego automático sale como *Automático*.
3. **IP real en los logs** (importante, es lo que hace útil el límite por IP): con el móvil por **datos 4G** (no WiFi), escribe mal la contraseña una vez y mira `journalctl -u ecoplant-backend -n 20`: el aviso de login fallido debe mostrar una IP pública, no `127.0.0.1`. Si saliera `127.0.0.1`, Cloudflare no está pasando `CF-Connecting-IP` y el límite por IP bloquearía a todos a la vez — avisar antes de dejarlo así.
4. Cinco contraseñas erróneas seguidas con un email → sexto intento (incluso con la correcta) devuelve el mensaje de bloqueo; con otro email la app sigue entrando.

**Requiere build nueva de la app** (pantalla de historial, indicadores de conexión, cierre de sesión que borra el token): `npx eas-cli build --platform android --profile preview`. Con la app antigua todo lo del backend sigue funcionando, solo faltan esas pantallas.

---

## Verificación del stack completo

```bash
systemctl status mosquitto nodered influxdb grafana-server --no-pager
```

Prueba de extremo a extremo sin necesidad de hardware, publicando una lectura simulada:

```bash
mosquitto_pub -h 192.168.1.140 -p 8883 --cafile ~/certs/ca.crt \
  --cert ~/certs/clients/nodered.crt --key ~/certs/clients/nodered.key \
  -t "maceteros/test01/sensores" \
  -m '{"device_id":"test01","humedad_suelo":42,"temp_aire":22.5,"presion":1013.2,"estado":"OK"}'
```

El dato debe aparecer en el bucket `macetero_iot` de InfluxDB y, por tanto, en Grafana.

---

## Puertos

| Servicio | Puerto | Autenticación | Cifrado |
|---|---|---|---|
| Mosquitto | 8883 | certificado de cliente (mTLS) + ACL | TLS 1.2 |
| Node-RED | 1880 | editor y dashboard separados | — |
| InfluxDB | 8086 | usuario/contraseña + token API | — |
| Grafana | 3000 | usuario/contraseña | — |
| Backend API | 8000 | JWT (registro/login propios) | — |
| PostgreSQL | 5432 | usuario/contraseña, solo `127.0.0.1` | — |
| Caddy | 8080 | delega en cada servicio proxied | — |

El puerto MQTT sin cifrar (1883) está cerrado. Los servicios web (Node-RED, InfluxDB, Grafana, Backend API, Caddy) hablan HTTP sin cifrar entre sí en `127.0.0.1`: asumible porque nada de eso escucha en la red, solo en loopback. Lo único que sale de la Pi es lo que Caddy reenvía explícitamente (`/ui`, `/api/*`) a través del Cloudflare Tunnel, con TLS gestionado por Cloudflare — ver "Acceso remoto" más arriba.

---

## Copia de seguridad

Qué contiene una copia (todo lo que no se regenera solo):

| Qué | Origen en la Pi |
|---|---|
| Base de datos de usuarios, ubicaciones, dispositivos, resúmenes, tokens de notificación | `pg_dump` de `ecoplant` + roles de PostgreSQL |
| Datos históricos (lecturas) | `/var/lib/influxdb/` completo |
| Flujos y credenciales de Node-RED, clave de cifrado de credenciales, contexto persistente (parámetros de riego) | `~/.node-red/` (sin `node_modules`: se reinstalan con `npm install`) |
| CA, certificado del servidor, certificados de cliente (Node-RED, backend, dispositivos) | `~/certs/` (`ca.key` cifrada con su propia contraseña) |
| Broker: configuración, ACLs, certificados | `/etc/mosquitto/` |
| Variables de entorno del backend | `backend/.env` |
| Servicios y proxy | `ecoplant-backend.service`, `cloudflared-demo.service`, `influxdb.service`, `nodered.service.d`, `mosquitto.service.d`, `/etc/caddy/Caddyfile` |
| Grafana | `/etc/grafana/grafana.ini`, `/var/lib/grafana/grafana.db` |

Las fotos de plantas **no se guardan** en ningún sitio (se envían a Groq para el diagnóstico y se descartan), así que no hay nada que respaldar de ellas.

### Hacer una copia (a mano, desde el PC)

La copia se guarda **en el PC**, no en la Pi (si se estropea la tarjeta SD se pierde todo lo que haya en ella). Se lanza cuando se quiera, desde PowerShell y con el PC en la misma red que la Pi:

```powershell
.\platform\backup\backup-from-pi.ps1
```

El script se conecta por SSH, ejecuta [`pi-backup.sh`](backup/pi-backup.sh) en la Pi (pide la contraseña `sudo` y una **contraseña de cifrado** para la copia), baja el archivo a `%USERPROFILE%\Backups\EcoPlant\ecoplant-backup-AAAAMMDD-HHMM.tar.gz.enc`, comprueba que el tamaño coincide y borra el temporal de la Pi. Con `-Destino D:\otra\carpeta` se elige otra carpeta.

Detalles que conviene saber:

- **InfluxDB se para unos segundos** mientras se copia su carpeta (es la única forma de que la copia sea consistente sin un token de administrador). Node-RED registrará algún error de escritura en ese momento y se pierden como mucho unas pocas lecturas; el script lo vuelve a arrancar siempre, incluso si algo falla.
- **La copia contiene secretos** (`.env`, claves privadas, `ca.key`, hashes de contraseña): por eso va cifrada con AES-256 (`openssl enc -pbkdf2`). **Guarda la contraseña de cifrado en un gestor de contraseñas**: sin ella la copia no se puede abrir, y no hay forma de recuperarla.
- El script abre la copia recién generada para comprobar que la contraseña y el contenido son correctos antes de darla por buena.
- `MANIFEST.txt` dentro del archivo indica fecha, commit del repo, revisión de Alembic y qué rutas no existían y se omitieron.

### Restaurar

En una Pi nueva (o tras reinstalar), con la copia y su contraseña:

1. Instalar los servicios base siguiendo este README (Mosquitto, Node-RED, InfluxDB, Grafana, PostgreSQL, Caddy, cloudflared) y clonar el repo, **sin configurarlos**: la configuración viene en la copia. Parar los servicios.
2. Copiar el `.enc` a la Pi y abrirlo:

```bash
mkdir ~/restore && cd ~/restore
openssl enc -d -aes-256-cbc -pbkdf2 -iter 200000 -in ~/ecoplant-backup-AAAAMMDD-HHMM.tar.gz.enc | tar -xzf -
cat MANIFEST.txt
```

3. Devolver los ficheros a sus rutas originales (conserva permisos y propietarios):

```bash
sudo cp -a ~/restore/files/. /
cd ~/.node-red && npm install        # reinstala node_modules desde package.json
```

4. PostgreSQL (roles primero, luego la base):

```bash
sudo -u postgres psql -f ~/restore/postgres-globals.sql      # "role already exists" en postgres es normal
sudo -u postgres createdb -O ecoplant ecoplant
sudo -u postgres pg_restore -d ecoplant < ~/restore/postgres-ecoplant.dump
```

5. InfluxDB:

```bash
sudo systemctl stop influxdb
sudo rm -rf /var/lib/influxdb
sudo tar -C / -xzf ~/restore/influxdb.tar.gz
sudo systemctl start influxdb
```

6. `sudo systemctl daemon-reload`, arrancar el resto (`mosquitto`, `nodered`, `grafana-server`, `ecoplant-backend`, `caddy`) y comprobar que los dispositivos publican y que la app abre sesión. Borrar `~/restore` al terminar (contiene secretos sin cifrar).

La clave privada de la CA (`ca.key`) es el elemento más sensible del conjunto: quien la posea puede emitir certificados que los dispositivos aceptarán como legítimos. Vive en la propia Pi, cifrada con una contraseña que solo conoce el operador — mitiga que alguien robe el archivo y lo use directamente, pero no es lo mismo que mantenerla en una máquina totalmente separada del servidor; moverla fuera de la Pi queda como mejora de seguridad pendiente. Las copias en el PC la incluyen (cifrada dos veces: por su contraseña y por la de la copia).
