luistorrerodri/EcoPlant-Platform/structure/preview/00_conjunto.png

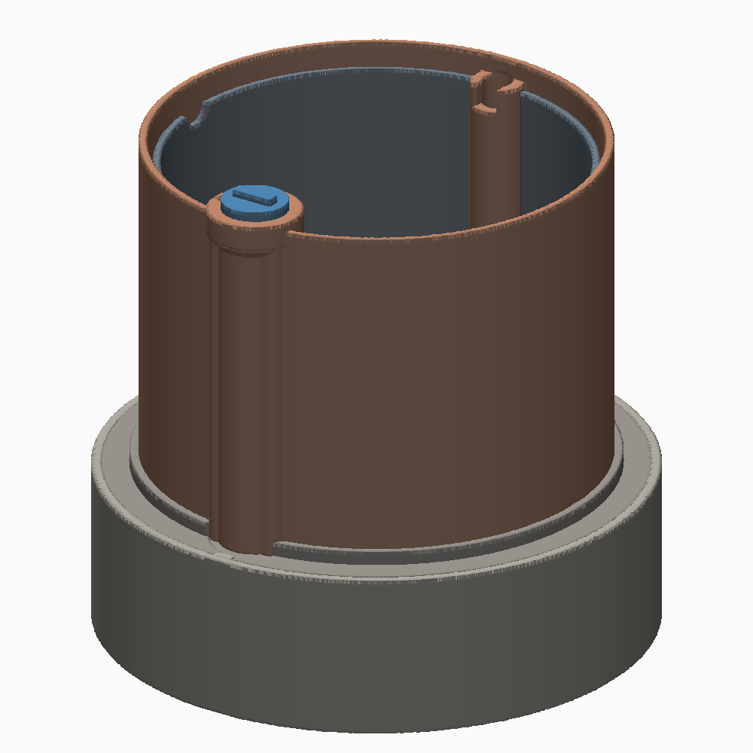
structure/preview/00_conjunto.png
