luistorrerodri/EcoPlant-Platform/structure/preview/00_conjunto_cenital.png

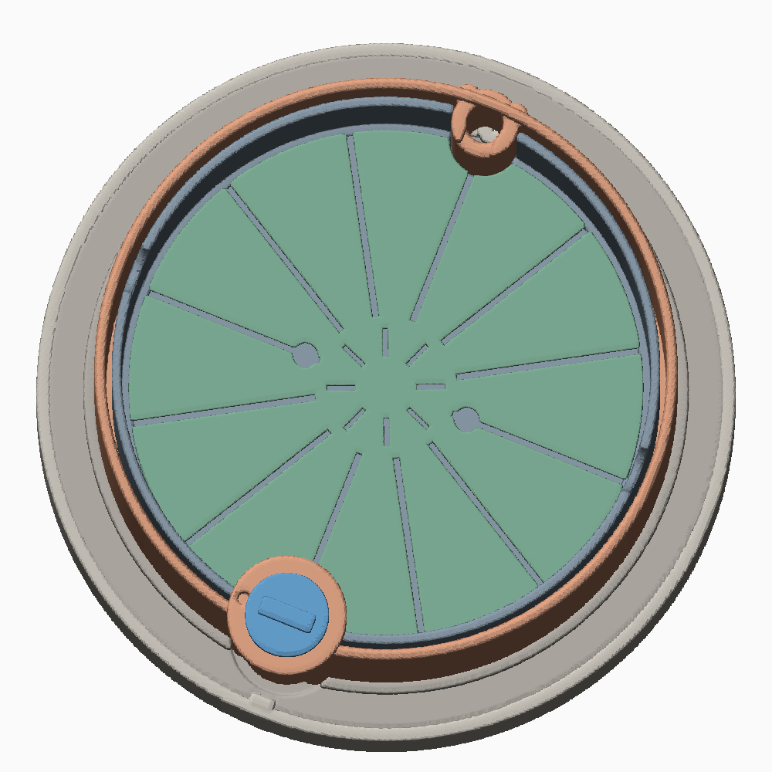
structure/preview/00_conjunto_cenital.png
