luistorrerodri/EcoPlant-Platform/structure/preview/00_conjunto_corte.png

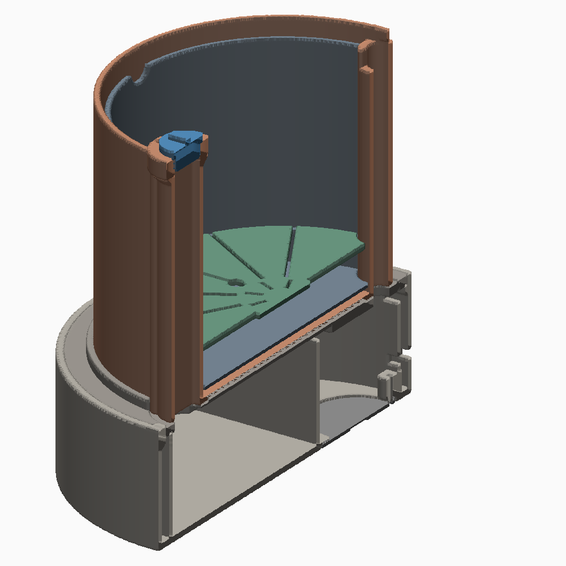
structure/preview/00_conjunto_corte.png
