luistorrerodri/EcoPlant-Platform/structure/preview/00_conjunto_frontal.png

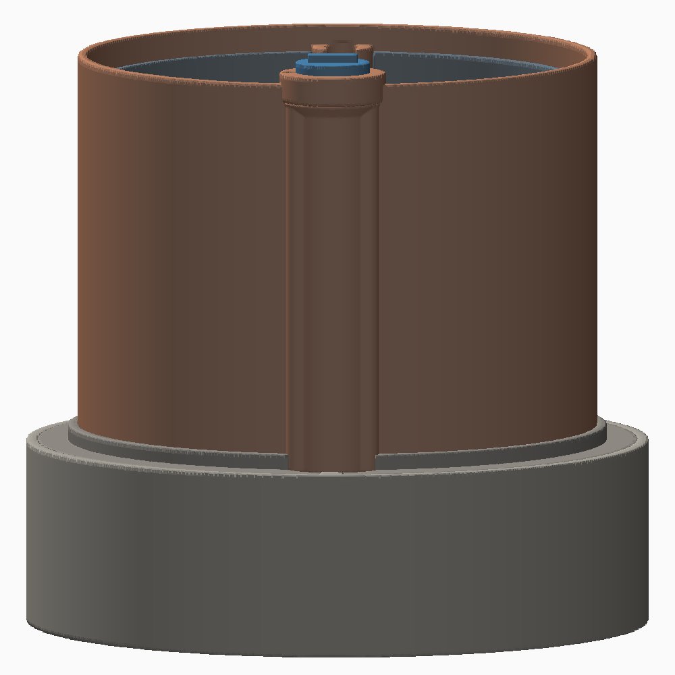
structure/preview/00_conjunto_frontal.png
