luistorrerodri/EcoPlant-Platform/structure/preview/00_explosionado.png

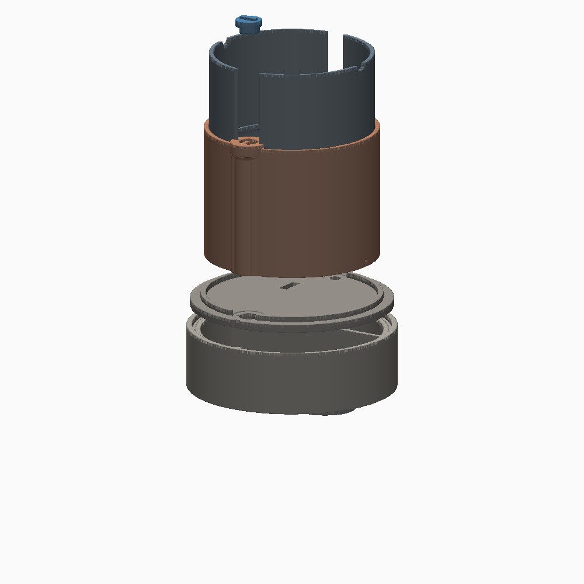
structure/preview/00_explosionado.png
