luistorrerodri/EcoPlant-Platform/structure/preview/01_cubeta_base.png

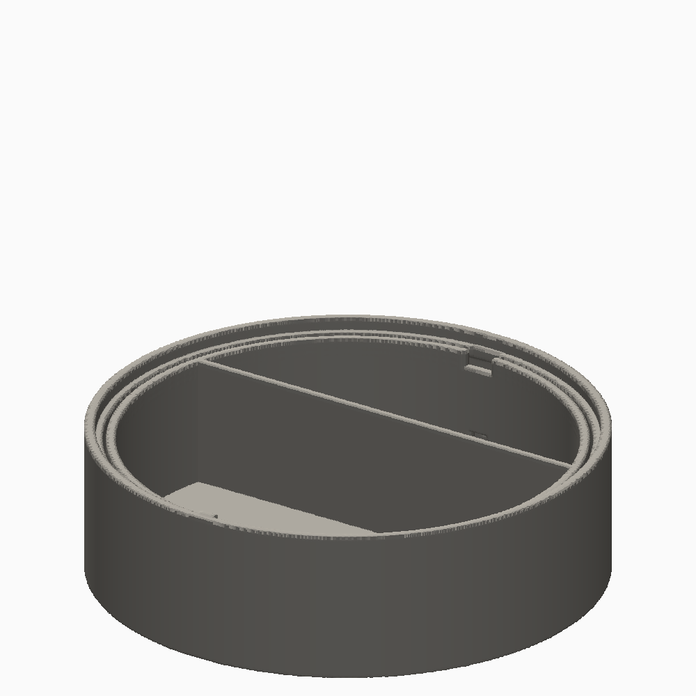
structure/preview/01_cubeta_base.png
