luistorrerodri/EcoPlant-Platform/structure/preview/01_cubeta_base_corte.png

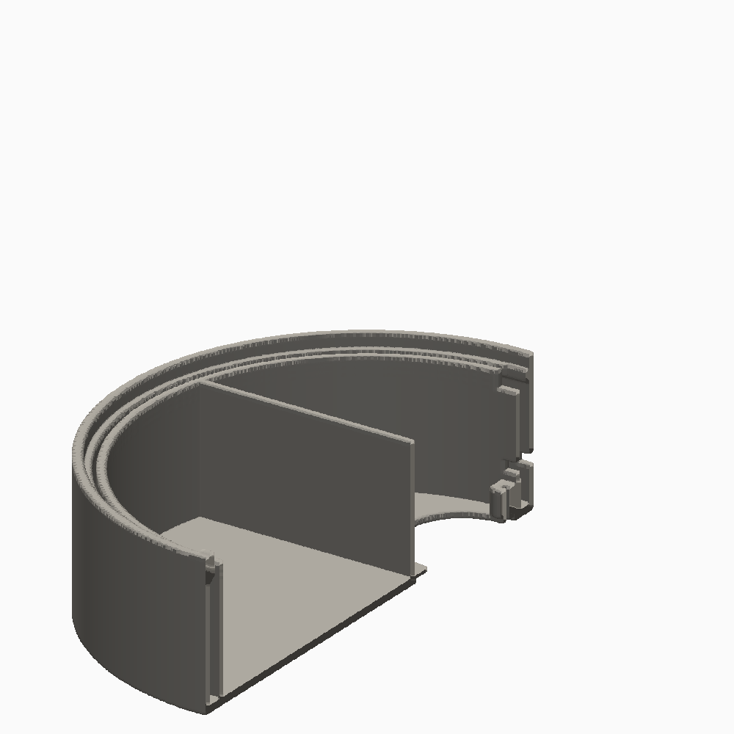
structure/preview/01_cubeta_base_corte.png
