luistorrerodri/EcoPlant-Platform/structure/preview/02_tapa_superior.png

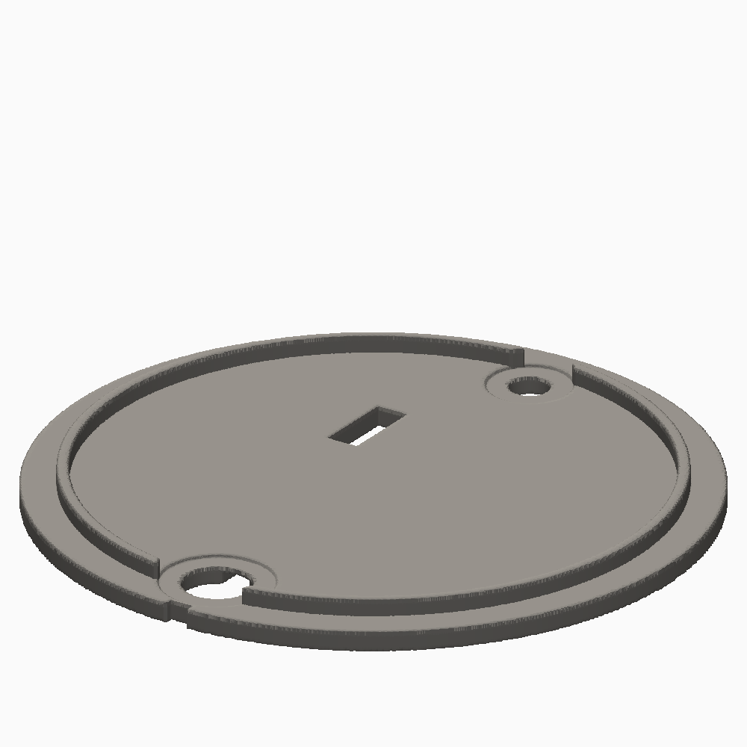
structure/preview/02_tapa_superior.png
