luistorrerodri/EcoPlant-Platform/structure/preview/03_maceta.png

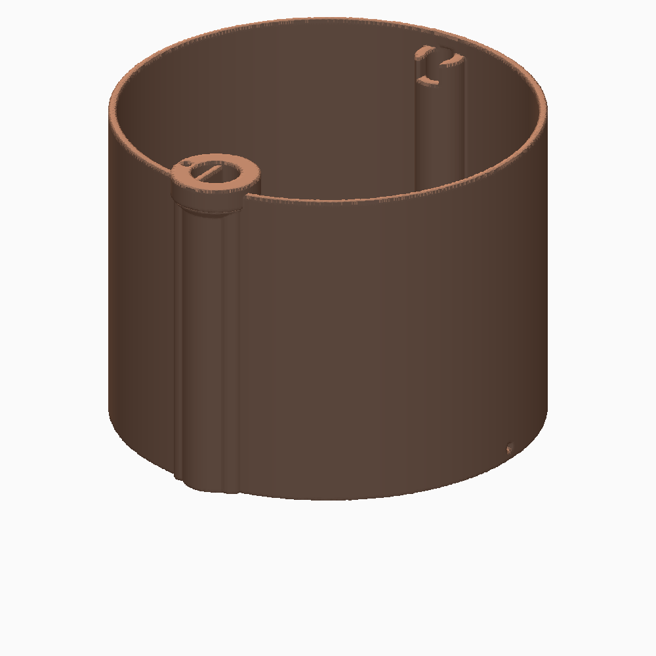
structure/preview/03_maceta.png
