luistorrerodri/EcoPlant-Platform/structure/preview/03_maceta_corte.png

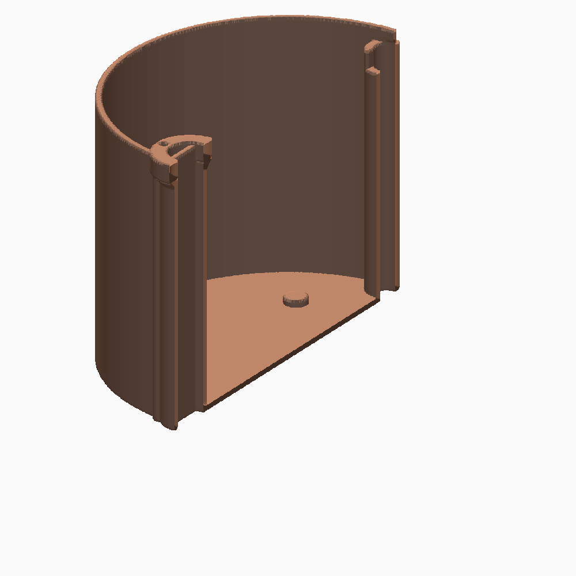
structure/preview/03_maceta_corte.png
