luistorrerodri/EcoPlant-Platform/structure/preview/04_cesta_corte.png

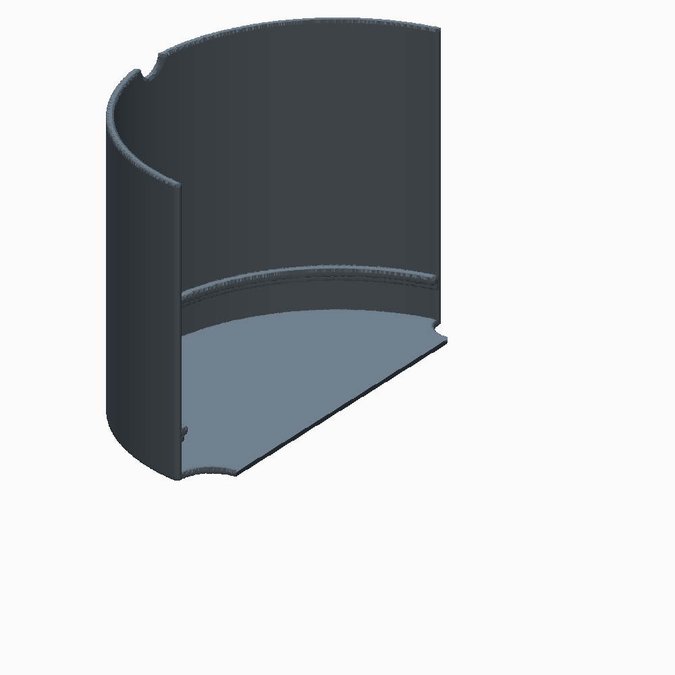
structure/preview/04_cesta_corte.png
