luistorrerodri/EcoPlant-Platform/structure/preview/05_tapon_llenado.png

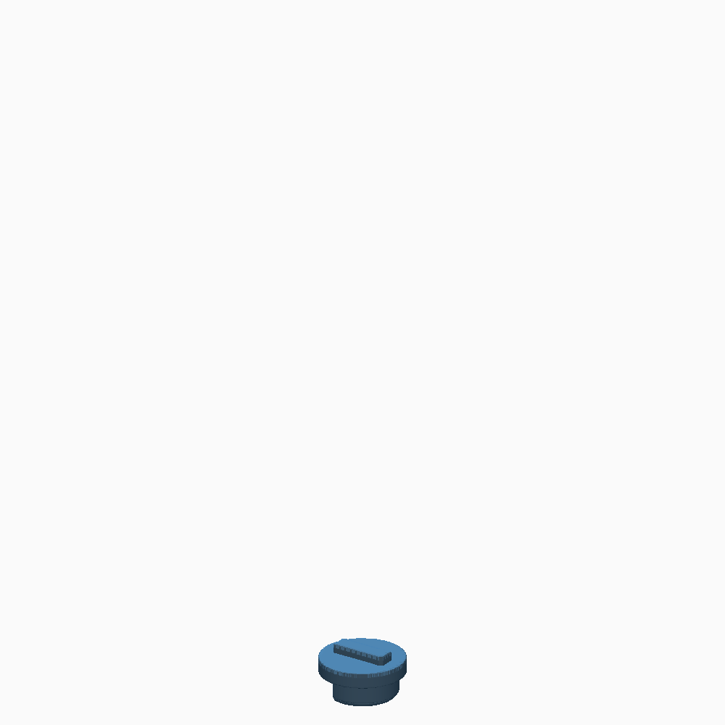
structure/preview/05_tapon_llenado.png
