luistorrerodri/EcoPlant-Platform/structure/preview/07_rejilla_drenaje.png

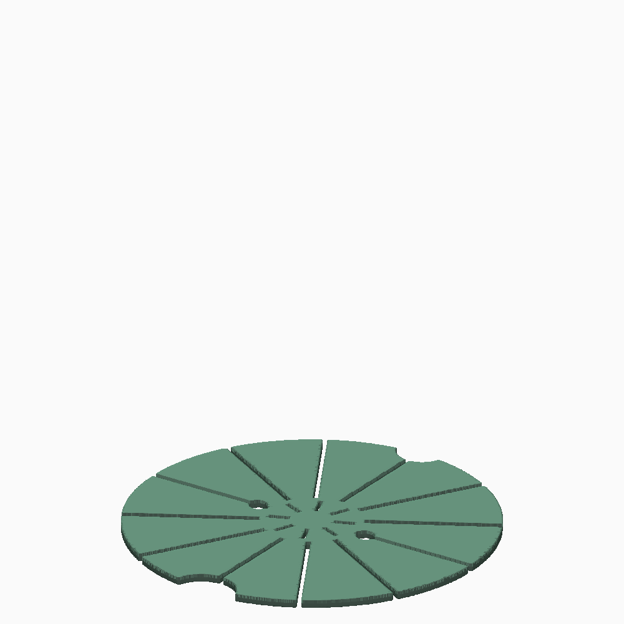
structure/preview/07_rejilla_drenaje.png
