luistorrerodri/EcoPlant-Platform/docs/troubleshooting.md

# Troubleshooting

Registro de los problemas de integración reales que surgieron durante el desarrollo, cómo se diagnosticaron y cómo se resolvieron. Documentado tanto para referencia futura como porque el proceso de diagnóstico es, en sí mismo, parte del valor del proyecto.

---

## 1. Sensor vendido como BME280 que en realidad era un BMP280

**Síntoma**: la librería `Adafruit_BME280` fallaba en `begin()` tanto en `0x76` como en `0x77`, pero un escáner I2C detectaba perfectamente un dispositivo respondiendo en `0x76`.

**Diagnóstico**: el hecho de que el escáner lo viera pero la librería lo rechazara descartaba un problema de cableado o alimentación — el chip estaba vivo y hablando por el bus. Eso apuntaba a que la librería estaba rechazando el dispositivo por su identificador interno. Se leyó directamente el registro de chip ID (`0xD0`) por I2C:

```cpp
Wire.beginTransmission(0x76);
Wire.write(0xD0);          // registro de chip ID
Wire.endTransmission();
Wire.requestFrom(0x76, 1);
byte chipId = Wire.read();
```

El resultado fue `0x58`. Según el datasheet de Bosch, `0x60` corresponde a un BME280 y `0x58` a un BMP280 — es decir, el módulo era un BMP280 (temperatura y presión, **sin sensor de humedad**) vendido y serigrafiado como BME280.

**Solución**: migrar a la librería `Adafruit_BMP280` y eliminar del payload el campo de humedad ambiente, que ese hardware físicamente no puede medir.

**Aprendizaje**: en módulos de bajo coste, la serigrafía no es fuente de verdad. Verificar el chip ID por I2C es un paso barato que ahorra horas de depuración achacada erróneamente al cableado.

---

## 2. Repositorio APT de InfluxData con fallo de firma GPG en Debian Bookworm / ARM64

**Síntoma**: `apt update` fallaba repetidamente con:

```
NO_PUBKEY DA61C26A0585BD3B
E: El repositorio «https://repos.influxdata.com/debian stable InRelease» no está firmado.
```

**Diagnóstico**: se verificó que la clave se descargaba correctamente (archivo de 1684 bytes, tamaño coherente para una clave GPG) y que `gnupg` estaba instalado y actualizado. Se reintentó el proceso paso a paso, separando la descarga de la conversión con `gpg --dearmor` en lugar de encadenarlo todo con pipes — el fallo persistió igualmente, descartando un error en la ejecución del comando.

Es un problema conocido y reportado por otros usuarios en esa combinación concreta de sistema (Raspberry Pi OS / Debian Bookworm sobre ARM64), no un error de configuración local.

**Solución**: abandonar la instalación vía `apt` e instalar desde el binario oficial, creando un servicio systemd propio:

```bash
curl -L -O https://download.influxdata.com/influxdb/releases/influxdb2-2.9.1_linux_arm64.tar.gz
tar xvzf influxdb2-2.9.1_linux_arm64.tar.gz
sudo cp influxdb2-2.9.1/influxd /usr/local/bin/
```

Con un usuario de sistema dedicado (`influxdb`), un directorio de datos en `/var/lib/influxdb` y una unidad systemd que apunta a `--bolt-path` y `--engine-path`. El detalle completo está en [`../platform/README.md`](../platform/README.md).

**Aprendizaje**: cuando un repositorio de terceros falla de forma reproducible en una arquitectura concreta, el binario oficial con un servicio systemd propio es una alternativa perfectamente válida y a menudo más rápida que seguir peleando con las firmas. Además obliga a entender qué hace realmente el servicio, en lugar de delegarlo ciegamente al paquete.

**Nota adicional**: el repositorio de Grafana (`apt.grafana.com`) funcionó sin problemas en el mismo sistema, lo que confirma que el fallo era específico del repositorio de InfluxData y no de la Raspberry Pi ni de la configuración de APT.

---

## 3. `rc=-2` al conectar el ESP32 al broker MQTT

**Síntoma**: el ESP32 conectaba correctamente al WiFi y obtenía IP, pero fallaba indefinidamente al conectar por MQTT con `rc=-2`.

**Diagnóstico**: en la librería `PubSubClient`, `rc=-2` significa literalmente "no se pudo establecer la conexión con el servidor" — es un fallo de red, no de autenticación (que daría `rc=4` o `rc=5`). Comparando la IP asignada al ESP32 (`192.168.1.139`) con la IP configurada del broker (`192.168.100.52`), la discrepancia era evidente: estaban en subredes distintas. La IP del broker era de una red anterior y había quedado obsoleta en el firmware.

**Solución**: actualizar `mqtt_server` a la IP real de la Raspberry Pi en la red actual.

**Aprendizaje**: distinguir entre los códigos de error de `PubSubClient` acelera mucho el diagnóstico. `-2` (fallo de red) y `5` (no autorizado) apuntan a causas completamente distintas y evitan buscar en el sitio equivocado.

---

## 4. `Invalid topic specified` al publicar desde Node-RED

**Síntoma**: al pulsar el botón de riego manual del dashboard, el nodo `mqtt out` lanzaba:

```
Error: Invalid topic specified
```

**Diagnóstico**: el nodo `mqtt out` estaba configurado con el campo *Topic* vacío, con la intención de que heredase el topic del mensaje entrante (`msg.topic`), que el nodo `button` sí estaba fijando. Sin embargo, el topic no llegaba efectivamente al nodo de salida, dejándolo sin destino válido en el momento de publicar.

**Solución**: fijar el topic (`planta_datos/comando`) directamente en la configuración del nodo `mqtt out`, en lugar de depender de que viaje dentro del mensaje.

**Aprendizaje**: cuando un valor puede definirse en el propio nodo o heredarse del mensaje, fijarlo en el nodo es más robusto y explícito, especialmente en rutas críticas como un comando de actuación física.

---

## 5. Nodo MQTT de Node-RED reconectando en bucle contra una IP obsoleta

**Síntoma**: en los logs de `journalctl` de Node-RED aparecía, cada ~45 segundos:

```
[info] [mqtt-broker:planta_datos] Connection failed to broker: ...52:1883
```

**Diagnóstico**: el nodo de configuración del broker MQTT en Node-RED conservaba la IP de una red anterior (`192.168.100.52`), heredada de un prototipo previo del proyecto. Node-RED reintentaba conectarse indefinidamente sin éxito.

**Solución**: editar el nodo de configuración del broker y apuntarlo a `localhost`, ya que Mosquitto corre en la misma Raspberry Pi que Node-RED.

**Aprendizaje**: cuando un servicio consume otro que vive en la misma máquina, `localhost` es preferible a la IP de red: elimina la dependencia de que la IP del host no cambie.

---

## 6. `The chip stopped responding` al flashear el ESP32

**Síntoma**: la subida del firmware fallaba consistentemente alrededor del 90% de la escritura:

```
A fatal error occurred: The chip stopped responding.
```

El código compilaba correctamente y la conexión inicial con el chip se establecía sin problemas.

**Diagnóstico**: que el fallo ocurriera durante la escritura y no al conectar apunta a un problema de estabilidad de la comunicación o de alimentación durante el volcado, no a un error de código ni de detección del puerto. Con todos los módulos (BMP280, OLED, RTC, relé) conectados y alimentados desde el propio ESP32, los picos de consumo durante la escritura en flash pueden provocar caídas de tensión.

**Solución / mitigaciones aplicables**:
- Reducir `upload_speed` a `115200` en `platformio.ini` (por defecto usa velocidades mucho más altas que son más sensibles a cableados largos).
- Usar un cable USB de datos corto y de calidad, conectado directamente al equipo (no a un hub).
- Desconectar temporalmente los periféricos durante el flasheo para descartar consumo excesivo.

**Aprendizaje**: en el flasheo de microcontroladores, distinguir *cuándo* falla (al conectar vs. durante la escritura) orienta el diagnóstico: lo primero suele ser puerto/bootloader, lo segundo alimentación o integridad de la señal.

---

## 7. Lectura `undefined` en el nodo de decisión de riego

**Síntoma**: el nodo de decisión mostraba en su status `humedad:undefined%`, por lo que nunca llegaba a evaluar correctamente la condición de riego.

**Diagnóstico**: el nodo estaba conectado a una salida de la función de reparto que ya había extraído un único valor numérico para alimentar un gauge del dashboard. En ese punto `msg.payload` era directamente un número (por ejemplo `74`), no el objeto completo, de modo que `msg.payload.humedad_suelo` no existía.

**Solución**: conectar el nodo de decisión directamente a la salida del nodo `json`, donde el mensaje todavía conserva el objeto completo tal como lo publica el ESP32.

**Aprendizaje**: en Node-RED es fácil perder de vista en qué punto del flujo el payload deja de ser el objeto original. Cuando un campo aparece como `undefined`, el primer sitio donde mirar es *de dónde* viene el cable, no el código de la función.

---

## 8. Series fragmentadas en InfluxDB por modelar un valor cambiante como tag

**Síntoma**: en Grafana, la gráfica de humedad de suelo aparecía cortada en múltiples segmentos de colores distintos, en lugar de como una línea continua. La leyenda mostraba entradas separadas del tipo `humedad_suelo {device_id="macetero01", estado="SECO"}`, `... estado="HUMEDO"`, etc.

**Diagnóstico**: `estado` se había modelado como **tag** en InfluxDB. En una base de datos de series temporales, cada combinación única de tags define una serie independiente, de modo que un valor que cambia con frecuencia genera tantas series como valores distintos pueda tomar. Cada vez que la planta pasaba de `SECO` a `HUMEDO`, la primera serie dejaba de recibir puntos y arrancaba otra: de ahí las líneas cortadas.

**Solución**: mover `estado` de tag a field, dejando `device_id` como único tag. Además de resolver la fragmentación, es lo correcto conceptualmente: `estado` es un valor derivado de `humedad_suelo` mediante umbrales, no un metadato del dispositivo.

**Efecto secundario durante la migración**: al aplicar el cambio, la consulta en el Data Explorer dejó de devolver datos con el error `unsupported input type for mean aggregate: string`. La causa era que `estado`, ahora field de tipo texto, estaba incluido en una consulta cuya función de agregación era `mean` — no se puede promediar una cadena. Al deseleccionarlo de los campos consultados, la consulta volvió a funcionar.

Adicionalmente, los datos anteriores al cambio conservan el tag antiguo, por lo que durante un tiempo conviven ambos esquemas en el mismo bucket. Filtrar por `estado` en el Data Explorer devolvía únicamente los datos históricos, dando la falsa impresión de que la ingesta se había detenido.

**Aprendizaje**: la regla práctica es sencilla — si vas a **filtrar o agrupar** por un valor y es estable, es un tag; si vas a **graficarlo o agregarlo** y cambia con cada lectura, es un field. Modelar mal esta distinción no da un error inmediato, pero degrada las consultas y, a escala, el rendimiento por explosión de cardinalidad.

---

## 9. Riegos en ráfaga al introducir la confirmación del dispositivo

**Síntoma**: al cambiar la lógica para que el contador de "último riego" dependiera de la confirmación del dispositivo en lugar de la orden enviada, el sistema empezó a regar de forma repetida cada pocos segundos.

**Diagnóstico**: dos causas encadenadas.

La primera fue de secuencia: el cambio se aplicó en la plataforma **antes** de flashear el firmware que envía las confirmaciones. Sin confirmaciones, el registro de último riego permanecía a cero, la condición "han pasado más de 24 h" se cumplía siempre, y cada lectura de sensores disparaba una orden nueva.

La segunda persistió incluso con el firmware correcto: como el riego en el ESP32 es bloqueante (`delay()` de 9 segundos), durante ese tiempo el dispositivo no procesa MQTT. Las órdenes que la plataforma seguía emitiendo se acumulaban en el broker y se ejecutaban en cadena al terminar el primer riego. La confirmación llegaba demasiado tarde para frenar las que ya estaban en camino.

**Solución**: añadir en la plataforma una ventana mínima de 60 segundos entre órdenes consecutivas al mismo dispositivo, registrada en el momento de emitir el comando y evaluada antes de emitir el siguiente. A diferencia de la confirmación, esta guarda protege aunque el dispositivo no responda nunca.

**Aprendizaje**: en un sistema distribuido, condicionar una acción a la respuesta de otro componente introduce una ventana temporal en la que la acción puede repetirse. Hace falta una protección local (idempotencia, ventana de bloqueo o límite de reintentos) que no dependa de que la otra parte responda. Y en migraciones que afectan a dos componentes a la vez, el orden importa: el que emite debe actualizarse después del que responde, no antes.

---

## 10. Node.js rechaza un certificado que OpenSSL acepta (SAN ausente)

**Síntoma**: tras habilitar TLS en el broker, `mosquitto_sub` conectaba correctamente por el puerto 8883, pero el nodo MQTT de Node-RED se quedaba indefinidamente en estado "conectando", con el log repitiendo `Connection failed to broker: mqtts://...` sin más detalle.

**Diagnóstico**: el certificado del servidor se había generado indicando la dirección del broker únicamente en el campo **Common Name (CN)**. OpenSSL, y por tanto las herramientas de línea de comandos de Mosquitto, aceptan el CN como identificador del servidor. Node.js, en cambio, sigue la recomendación de RFC 6125 e **ignora el CN por completo**, exigiendo que la dirección figure en la extensión **Subject Alternative Name (SAN)**.

Se confirmó con:

```bash
openssl x509 -in server.crt -noout -text | grep -A1 "Subject Alternative Name"
```

que no devolvía nada: el certificado carecía de SAN.

**Solución**: regenerar el certificado del servidor incluyendo la extensión, mediante un archivo de extensiones pasado con `-extfile`. La CA no se toca, de modo que los dispositivos que ya llevan el `ca.crt` embebido no requieren reflasheo.

**Aprendizaje**: el CN como identificador de servidor está obsoleto desde hace años. Cualquier certificado nuevo debe llevar SAN, incluso en entornos internos con CA propia.

---

## 11. mbedTLS (ESP32) rechaza un certificado que Node.js acepta (SAN por IP)

**Síntoma**: tras corregir el problema anterior, Node-RED conectaba correctamente pero el ESP32 pasó a fallar de forma sistemática con:

```
(-9984) X509 - Certificate verification failed, e.g. CRL, CA or signature check failed
```

**Diagnóstico**: el caso simétrico al anterior. El SAN se había generado con la entrada `IP Address:192.168.1.140`, que es lo formalmente correcto para una dirección IP. Node.js interpreta correctamente las entradas de tipo `iPAddress`. La implementación de mbedTLS que utiliza el ESP32, en cambio, compara el nombre solicitado contra las entradas de tipo **dNSName**, sin evaluar las de tipo `iPAddress`, por lo que ninguna coincidía y la verificación fallaba.

**Solución**: incluir la dirección **también** como entrada DNS, aunque sea una IP:

```
subjectAltName = IP:192.168.1.140, DNS:192.168.1.140, DNS:raspberrypi, DNS:localhost
```

Las entradas se acumulan, de modo que ambos clientes encuentran una coincidencia válida con el mismo certificado.

**Aprendizaje**: dos implementaciones de TLS que cumplen el estándar pueden diferir en qué partes del certificado evalúan. En un sistema con clientes heterogéneos (un runtime de servidor y un microcontrolador), el certificado debe satisfacer a la implementación más restrictiva de todas, no a la más permisiva. Conviene verificar la conexión desde **cada** tipo de cliente antes de dar por buena una configuración TLS.

**Nota de diagnóstico**: el código `-9984` de mbedTLS agrupa varias causas distintas (firma inválida, CA desconocida, nombre no coincidente, certificado caducado). Cuando aparece, merece la pena descartar por orden: fecha del dispositivo, cadena de firma (`openssl verify -CAfile ca.crt server.crt`) y, por último, coincidencia de nombre en el SAN.

---

## 12. Riego automático duplicado entre firmware y plataforma

**Síntoma**: no llegó a manifestarse como fallo en producción, pero se detectó durante la migración de la lógica al servidor.

**Diagnóstico**: al implementar la decisión de riego en Node-RED, el firmware del ESP32 conservaba todavía su propio bloque de decisión automática (comparación de humedad, franja horaria y tiempo desde el último riego). Ambas lógicas quedaron activas en paralelo. Mientras los parámetros de ambas coincidían el comportamiento parecía correcto, pero en el momento en que se modificara el umbral desde el dashboard, el ESP32 habría seguido regando según su criterio interno, ajeno al cambio.

**Solución**: eliminar por completo el bloque de decisión del firmware, dejando únicamente la ejecución del comando recibido por MQTT. El ESP32 pasó a ser exclusivamente sensor y actuador.

**Aprendizaje**: durante una migración de responsabilidad de un componente a otro, el estado intermedio en el que ambos hacen lo mismo es especialmente traicionero: funciona, y por eso es fácil olvidarse de completar la migración. Conviene tratar la eliminación de la lógica antigua como parte de la misma tarea, no como una limpieza posterior opcional.

---

## 13. `-9984 X509 verify failed` en el ESP32 al añadir mTLS, causado por un `CA_CERT` desactualizado

**Síntoma**: al implementar autenticación mutua (certificado de cliente por dispositivo), el ESP32 dejó de conectar al broker con `(-9984) X509 - Certificate verification failed`, el mismo código genérico que agrupa varias causas (ver entrada 11). El log de Mosquitto mostraba, casi en el instante de aceptar la conexión: `OpenSSL Error[0]: error:0A000418:SSL routines::tlsv1 alert unknown ca`.

**Diagnóstico**: la sospecha inicial fue el certificado de cliente recién creado — el cambio más reciente. Se descartó en dos pasos: primero, probando el par `macetero01.crt`/`macetero01.key` directamente desde la propia Pi con `mosquitto_sub --cert ... --key ...`, que conectó sin problema, confirmando que el certificado de cliente era válido. Segundo, desactivando temporalmente `require_certificate` en el broker (de modo que el certificado de cliente dejaba de intervenir) y comprobando que el ESP32 **seguía fallando exactamente igual** — lo que descartó por completo la vía del certificado de cliente y apuntó a la verificación del certificado del *servidor*, sin relación con el trabajo de mTLS.

Con eso, el patrón del log (fallo casi inmediato, alerta `unknown ca` recibida por el broker) encajaba con que fuera el propio ESP32 quien rechazaba el certificado del broker y abortaba el handshake enviando esa alerta — es decir, el `CA_CERT` embebido en el firmware no correspondía ya al `ca.crt` real de la Pi, probablemente por haber quedado una copia de una generación de CA anterior.

**Solución**: volver a copiar el `ca.crt` actual de la Pi al `secrets.h` del firmware (archivo a archivo, sin retipear el contenido — ver la nota siguiente) y reflashear.

**Aprendizaje**: cuando un fallo de TLS aparece justo después de tocar *otra* pieza relacionada (aquí, añadir el certificado de cliente), es tentador asumir que la pieza recién tocada es la culpable. Aislar la variable — probar el certificado nuevo por separado, y luego desactivar temporalmente la función nueva para ver si el fallo persiste sin ella — evita perder tiempo depurando la parte equivocada. El código `-9984` seguía sin distinguir la causa exacta; hizo falta cruzar el log del ESP32 con el del broker (no solo mirar un lado) para saber qué certificado era el que realmente estaba fallando.

**Nota sobre copiar/pegar certificados**: retranscribir manualmente un bloque PEM (por terminal o a mano) es una fuente de errores fácil de introducir y difícil de detectar a simple vista. La forma fiable es traer el archivo real al equipo (`scp`) y copiar su contenido directamente en un editor de texto, sin que el contenido pase por una reescritura intermedia.

---

## 14. Caddy sirviendo en TLS y bloqueando todo por el filtro de `Host`

**Síntoma**: al configurar Caddy como proxy local para exponer solo `/ui` de Node-RED, dos fallos encadenados durante la puesta en marcha.

Primero, cualquier petición HTTP normal (`curl http://localhost:8080/...`) devolvía `400 Bad Request` con el cuerpo `Client sent an HTTP request to an HTTPS server.`

**Diagnóstico**: el bloque del `Caddyfile` empezaba con `127.0.0.1:8080 { ... }`, sin especificar esquema. Caddy asume HTTPS por defecto salvo que se le diga lo contrario, y para una dirección así (sin dominio público) lo hace sirviendo TLS con su propia CA interna autofirmada — de ahí que una petición en texto plano fuera rechazada por el propio servidor TLS antes de llegar a ninguna lógica de rutas.

**Solución parcial**: anteponer el esquema explícitamente, `http://127.0.0.1:8080 { ... }`, para forzar HTTP plano sin TLS.

Con eso resuelto, apareció el segundo fallo: **todas** las rutas devolvían `200` con cuerpo vacío — incluidas rutas que deberían estar bloqueadas (`/`, `/flows`) e incluso una ruta inventada que no podía coincidir con nada. El bloque `handle { respond 404 }` pensado como salida por defecto no se estaba aplicando nunca.

**Diagnóstico**: preguntando directamente a la API de administración de Caddy (`curl http://localhost:2019/config/`) qué configuración tenía cargada de verdad, se confirmó que el `reload` sí se aplicaba — pero la ruta activa incluía `"match":[{"host":["127.0.0.1"]}]`. Al escribir `127.0.0.1:8080` como dirección del sitio, Caddy usa esa IP no solo para decidir en qué interfaz escuchar, sino también como **filtro sobre la cabecera `Host`** de la petición. Las pruebas se hacían con `curl http://localhost:8080/...`, que manda `Host: localhost:8080`, no `Host: 127.0.0.1` — la petición nunca coincidía con el único route definido, y caía al manejador por defecto de Caddy (200 vacío) en lugar de a los bloques `handle` configurados.

**Solución**: separar la interfaz de escucha del filtrado por host con la directiva `bind`, dejando la dirección del sitio sin IP:

```
:8080 {
	bind 127.0.0.1
	...
}
```

Así Caddy escucha solo en loopback (nada expuesto a la red local ni a internet salvo lo que decida reenviar `cloudflared`) sin exigir un `Host` concreto.

**Aprendizaje**: cuando el comportamiento observado no cuadra con la configuración que se cree tener cargada, preguntarle directamente al proceso en marcha (aquí, la API de admin de Caddy en `:2019`) qué tiene activo de verdad ahorra mucho tiempo frente a seguir editando el archivo a ciegas — el archivo puede ser correcto y aun así no significar lo que se piensa que significa. Y una dirección de sitio en un Caddyfile no es solo "dónde escuchar": mezclar ahí una IP tiene efectos de *matching* que no son obvios a primera vista.

---

## 15. `alembic revision --autogenerate` falla: la carpeta `versions/` nunca llegó al repositorio

**Síntoma**: al construir el backend, el primer `alembic revision --autogenerate` en la Pi terminaba con `FileNotFoundError: [Errno 2] No such file or directory: '.../alembic/versions/....py'`. Justo después, `alembic upgrade head` "funcionaba" sin error, pero `\dt` en `psql` solo mostraba la tabla de control `alembic_version`, vacía — ninguna de las tablas del modelo se había creado.

**Diagnóstico**: Git no versiona directorios vacíos. `backend/alembic/versions/` se había creado localmente pero, al no contener ningún archivo trackeado, nunca se incluyó en los commits — al clonar/hacer `pull` en la Pi, la carpeta simplemente no existía, así que Alembic no tenía dónde escribir el archivo de migración nuevo.

**Solución**: añadir un archivo `.gitkeep` (vacío, solo para que Git tenga algo que trackear) dentro de `alembic/versions/`, confirmar con `git ls-files` que la carpeta ya se versiona, y repetir `alembic revision --autogenerate` + `alembic upgrade head`.

**Aprendizaje**: cuando una herramienta necesita escribir en una carpeta que "debería estar ahí" porque se creó en algún momento, comprobar que esa carpeta llegó de verdad al control de versiones — `mkdir` local y "está en el repo" no son lo mismo si la carpeta se queda vacía.

---

## 16. `passlib` no es compatible con las versiones recientes de `bcrypt`

**Síntoma**: sin llegar a probarse en producción — se detectó antes de desplegar. `passlib[bcrypt]==1.7.4` es la última versión publicada (2020) y no reconoce el paquete `bcrypt` a partir de la versión 4.1, que eliminó el atributo `__about__` que `passlib` usa internamente para detectar qué versión de `bcrypt` tiene instalada.

**Diagnóstico**: al no fijar una versión concreta de `bcrypt` en `requirements.txt`, `pip` resolvía la última disponible (5.0.0 en el momento de instalar), incompatible con `passlib` 1.7.4.

**Solución**: fijar explícitamente `bcrypt==4.0.1` en `requirements.txt`, anterior al cambio que rompe la compatibilidad.

**Aprendizaje**: cuando una dependencia (aquí `passlib`) lleva años sin publicar una versión nueva, sus propias sub-dependencias no fijadas (`bcrypt`, en este caso, tirado por el extra `passlib[bcrypt]`) pueden evolucionar por delante y romper la compatibilidad sin que `passlib` se entere. Vale la pena fijar explícitamente la sub-dependencia cuando el paquete principal está claramente desactualizado, en vez de confiar en que el resolutor de `pip` elija algo compatible.

---

## 17. Swagger UI se rompe (`RangeError: Maximum call stack size exceeded`) con una respuesta JSON demasiado grande

**Síntoma**: el endpoint de lecturas históricas (`GET /devices/{id}/readings`) respondía `200 OK` — confirmado en el log del servidor — pero el Swagger UI se quedaba con el mensaje "Could not render responses_Responses, see the console", y la consola del navegador mostraba `RangeError: Maximum call stack size exceeded` dentro de su resaltador de sintaxis (`SyntaxHighlighter`).

**Diagnóstico**: la API funcionaba correctamente; el fallo era enteramente del lado del navegador. La causa raíz, sin embargo, sí era un problema real de diseño: la consulta a InfluxDB devolvía **cada lectura individual** del ESP32 (una cada 4 segundos) sin agregar, lo que para una ventana de 24 horas son del orden de 21.600 puntos por campo numérico — unos 2,2 MB de JSON. El resaltador de sintaxis de Swagger UI no soporta respuestas de ese tamaño y su función recursiva de procesado agota la pila de llamadas del navegador.

**Solución**: añadir `aggregateWindow()` a la consulta Flux, con una resolución que depende del rango pedido (1 minuto hasta 6h, 10 minutos hasta 48h, 1 hora por encima). La misma respuesta pasó de 2.212.266 a 16.430 bytes, y Swagger la renderiza sin problema.

**Aprendizaje**: un `200 OK` en el log del servidor no significa que el endpoint esté bien diseñado — nadie necesita, ni ningún cliente (app, web, gráfico) debería recibir, una lectura suelta cada 4 segundos para pintar 24 horas de histórico. El error de Swagger UI fue, en la práctica, una señal útil (aunque indirecta) de un problema real de la API que convenía arreglar de todas formas.

---

## 18. `git push` desde la Pi falla: identidad sin configurar y token de solo lectura

**Síntoma**: al intentar subir un commit generado en la propia Pi (una migración de Alembic), dos fallos sucesivos: primero `git commit` se negaba con "Identidad del autor desconocida"; después de arreglarlo, `git push` fallaba con `403: Write access to repository not granted`.

**Diagnóstico**: la Pi se había clonado con un token de acceso personal (fine-grained) creado a propósito con permiso de **Contents: Read-only**, suficiente en su momento porque solo se necesitaba `git pull`. Además, nunca se había configurado `user.name`/`user.email` en esa máquina, porque hasta entonces nunca se había hecho un commit ahí.

**Solución**: `git config --global user.name "..."` y `user.email "..."` para lo primero; para lo segundo, editar el token en GitHub (Settings → Developer settings → Fine-grained tokens) y subir el permiso de **Contents** a **Read and write**.

**Aprendizaje**: dar el mínimo permiso necesario en cada momento (aquí, solo lectura para clonar) es la práctica correcta, pero implica recordar ampliarlo explícitamente cuando el uso de esa credencial cambia — no es un fallo de configuración, es el sistema de permisos haciendo justo lo que se le pidió.

---

## 19. Caddy no arranca tras un reinicio de la Pi: condición de carrera con la red

**Síntoma**: con el dominio fijo (`api.ecoplantplatform.com`) ya configurado sobre el túnel con nombre de Cloudflare, las peticiones daban `502` de forma persistente. `curl` a la API funcionaba perfectamente por LAN un rato antes, así que no era un problema del túnel ni de DNS.

**Diagnóstico**: `sudo systemctl status caddy` mostraba el servicio como `failed`, caído desde hacía **12 horas** — coincidiendo casi al segundo con la hora en la que `cloudflared` se había conectado por última vez, señal clara de que la Pi se había reiniciado (corte de luz o similar) sin que nadie se diera cuenta. El motivo exacto, en el log: `listen tcp 192.168.1.140:8080: bind: cannot assign requested address`. Caddy había arrancado **antes de que la interfaz de red tuviera ya asignada la IP** `192.168.1.140` — el `Caddyfile` pide escuchar en esa IP explícita (para la LAN, además de loopback), y en el instante exacto del arranque esa dirección todavía no existía en el sistema. Caddy no reintenta ni se recupera solo de un fallo así: el proceso simplemente terminó con error y se quedó muerto, sin que el servicio volviera a intentarlo.

**Solución**: un *override* de systemd para el servicio de Caddy (paquete del sistema, no se edita el `.service` original directamente):

```bash
sudo mkdir -p /etc/systemd/system/caddy.service.d
sudo tee /etc/systemd/system/caddy.service.d/override.conf > /dev/null << 'EOF'
[Unit]
After=network-online.target
Wants=network-online.target

[Service]
Restart=on-failure
RestartSec=5
EOF
sudo systemctl daemon-reload
sudo systemctl restart caddy
```

`network-online.target` (a diferencia del `network.target` que trae el `.service` de fábrica) obliga a esperar a que la red esté *de verdad* operativa, no solo a que el subsistema de red exista. `Restart=on-failure` es la red de seguridad para cualquier otro fallo transitorio parecido: que el servicio se recupere solo, en vez de quedarse caído en silencio hasta que alguien lo note.

**Aprendizaje**: este fallo llevaba **12 horas activo sin que nada avisara** — Caddy no manda ninguna notificación al morir, `systemctl status` solo lo cuenta si alguien pregunta. Los servicios propios de este proyecto (`ecoplant-backend`, `cloudflared-demo`) ya se crearon desde el principio con `After=network-online.target` y `Restart=on-failure` — este fallo apareció justo en el único servicio de la pila que se instaló por `apt` con su configuración de fábrica sin revisar esa parte. Vale la pena repasar el resto de servicios del sistema (Mosquitto, Node-RED, InfluxDB, Grafana) para confirmar que ninguno tiene el mismo punto ciego.

**Seguimiento (2026-09-04)**: revisados los cuatro. InfluxDB y Grafana ya traían `network-online.target` de fábrica, sin tocar. Mosquitto tenía `network.target` y Node-RED no tenía ninguna dependencia de red — corregidos los dos con el mismo *override* que aquí (ver `platform/README.md`, secciones 1 y 2, "Arranque tras un reinicio"). En ninguno de los dos el riesgo real era tan alto como el de Caddy: ambos escuchan en todas las interfaces (`0.0.0.0`), no en la IP fija de la LAN que causó el fallo original — pero se corrigió igualmente, sin coste, por consistencia.

## 20. `alembic upgrade head` falla con "Multiple head revisions": una migración se generó y aplicó en la Pi pero nunca se comiteó

**Síntoma**: al desplegar una migración nueva (`cd15063a2c75`, catálogo de tipos de planta), `alembic upgrade head` falló con `Multiple head revisions are present for given argument 'head'`.

**Diagnóstico**: `alembic heads` mostró dos cabezas — la nueva (`cd15063a2c75`) y otra, `8afb2f1757a7` ("añadir push_token a users"), que **no existía en el repositorio** (no salió en el `git pull` ni aparecía en `alembic/versions/` del checkout local). Sí existía, en cambio, en el `alembic/versions/` de la propia Pi, y la tabla `alembic_version` de Postgres ya la tenía marcada como aplicada. Conclusión: en algún momento de una sesión anterior (implementando notificaciones push) alguien ejecutó `alembic revision --autogenerate` y `alembic upgrade head` directamente en la Pi, pero el archivo `.py` generado nunca se añadió a git ni se subió — el modelo `User.push_token` sí quedó comiteado (vive en `app/models/user.py`), pero la migración que crea esa columna no. Mismo tipo de fallo que el #15 (`versions/` sin trackear), con una variante distinta: aquí el archivo sí se creó, solo que no se comiteó nunca.

**Solución**: recuperar el contenido exacto del archivo desde la Pi (`cat alembic/versions/8afb2f1757a7_...py`), añadirlo al repositorio tal cual, y reencadenar la migración nueva para que apunte a esta (`down_revision = '8afb2f1757a7'` en vez de `'32dd032060ba'`), devolviendo la cadena a una sola cabeza lineal.

**Aprendizaje**: `alembic revision --autogenerate` genera un archivo que hay que comitear explícitamente, igual que cualquier otro cambio de código — no es un artefacto de build que se pueda regenerar solo. La regla ya estaba escrita en `backend/README.md` ("los archivos de migración se generan localmente y hay que comitearlos"), pero "localmente" en la práctica había significado "en la Pi" para esa migración concreta, no en el checkout de desarrollo desde el que se hacen los commits — vale la pena, tras cualquier `alembic revision --autogenerate` ejecutado directamente en la Pi (en vez de en local), copiar el archivo resultante de vuelta al checkout de desarrollo y comitearlo ahí antes de darlo por terminado.

## 21. Aviso push de "desconectado" con el dispositivo funcionando perfectamente al mirar

**Síntoma**: llega una notificación "macetero01 se ha desconectado inesperadamente", pero al abrir la app o el dashboard segundos después todo está normal — el dispositivo online, datos llegando.

**Diagnóstico**: el firmware nunca fija un `setKeepAlive()` en el cliente MQTT (`PubSubClient`), así que usa el valor por defecto de la librería, 15 segundos. Por especificación MQTT, el broker (Mosquitto) da por muerta una conexión y dispara su LWT (`{"online":false}`, retenido) a partir de 1.5× ese keepalive, es decir, ~22 segundos de silencio. Un simple parpadeo de wifi doméstico (cambio de canal del router, renovación de la concesión DHCP, una interferencia puntual) es más que suficiente para superar esa ventana sin que el ESP32 llegue a darse cuenta — su `loop()` solo reacciona a que `client.connected()` se vuelva falso, y `reconnectMQTT()` ya lo resuelve solo en unos segundos en cuanto el wifi vuelve. El problema real no era el wifi, sino que **ni Node-RED ni el backend esperaban nada antes de reaccionar**: el backend (`backend/app/services/mqtt_client.py`, `_on_message`) enviaba el push en el mismísimo mensaje `online:false`, sin comprobar si seguía así unos segundos después, y tampoco había ninguna notificación de "ha vuelto" que pudiera servir de contraste.

**Solución**: antes de enviar el aviso, el backend espera ahora `DISCONNECT_GRACE_SECONDS` (30s, vía `threading.Timer`) y solo notifica si el dispositivo *sigue* marcado como desconectado en ese momento — si llega un `online:true` durante la espera (la reconexión real, casi siempre en pocos segundos), el aviso se descarta sin más. No hace falta compartir estado con Node-RED: el backend tiene su propia suscripción MQTT independiente (identidad `backend-api`) y lleva su propio `_last_online_state` en memoria.

**Aprendizaje**: un LWT con un keepalive corto es normal y esperable que se dispare de vez en cuando por ruido de red transitorio — no es un fallo a perseguir en el firmware. El sitio correcto para absorber ese ruido es donde se decide molestar al usuario (el envío del push), no intentar que la red casera nunca tenga un hipo. Complementario para una futura revisión de firmware (junto con el aprovisionamiento WiFi y el DS18B20 ya pendientes): subir el keepalive del propio ESP32 (p. ej. a 45-60s, con `client.setKeepAlive()`) reduciría aún más la frecuencia de estos parpadeos, aunque ya no sea estrictamente necesario para evitar el aviso falso.

---

## 22. El estado de la planta no coincidía con el tipo de planta configurado

**Síntoma**: Luis reportó (2026-09-11) que una Suculenta/cactus mostraba "NECESITA_RIEGO" al 36% de humedad de suelo — un umbral que solo tenía sentido para el valor por defecto original de la planta "Personalizado", no para un cactus, que a ese nivel está sobradamente húmedo.

**Diagnóstico**: `soilStatus()` en firmware clasificaba el estado con umbrales fijos (25/36/65/80%), sin tener en cuenta que cada dispositivo podía tener un tipo de planta distinto configurado desde la app.

**Solución**: se generalizó la fórmula a un margen proporcional al rango configurado por dispositivo (`humedad_min`/`humedad_max`, con `humedad_max` como columna nueva), aplicada de forma idéntica en Node-RED ("Formatear para InfluxDB") y en firmware, más un topic MQTT retenido (`maceteros/{id}/config`) para que el ESP32 reciba sus propios umbrales sin reflashear — igual que ya recibe el comando de riego sin decidir nada por su cuenta.

**Bug real durante el despliegue**: tras aplicar el cambio, el `PATCH` desde la app respondía `200 OK` pero el ESP32 nunca recibía la configuración nueva por MQTT. Se descartó primero la app (un `PATCH` directo por `curl` dio el mismo resultado) y después el backend (sin errores en el log). La causa real: `/etc/mosquitto/acl` no tenía permiso de escritura para `backend-api` ni de lectura para el propio dispositivo sobre el topic `config`, recién creado — **Mosquitto descarta en silencio un publish/subscribe denegado por ACL, sin avisar al publicador**, así que no había ningún error visible en ningún sitio. Confirmado leyendo el ACL directamente en la Pi y añadiendo las dos líneas que faltaban.

**Aprendizaje**: un mensaje MQTT "publicado con éxito" (sin excepción del lado del cliente) no significa que haya llegado a ningún sitio si el broker lo deniega por ACL — ese fallo es completamente silencioso por diseño. Al añadir un topic nuevo, dar de alta el permiso en el ACL es tan parte del cambio como el propio código; se detecta antes comprobando la entrega real (`mosquitto_sub` o el log del propio dispositivo) que confiando en la ausencia de errores en el backend.

---

## 23. `pct_saturado` en el resumen de salud usaba un umbral fijo del 85%, no el máximo del tipo de planta

**Síntoma**: el mismo cactus (`humedad_max=32%`) llevaba días con la humedad al 41-42% — muy por encima de lo que tolera ese tipo de planta — pero "Salud de la planta" mostraba "Tiempo saturado: 0%".

**Diagnóstico**: `pct_saturado`, en `health_analysis.py`, comparaba contra una constante fija (`SATURATION_THRESHOLD = 85.0`) heredada de antes de que existiera `humedad_max` por dispositivo — la métrica de salud se construyó unos días antes que ese campo. Mismo tipo de bug que la entrada #22, colado en un cálculo distinto por haberse implementado en momentos diferentes del proyecto.

**Solución**: usar `device.humedad_max` en vez del umbral fijo.

**Aprendizaje**: cuando la misma idea (un umbral relativo al tipo de planta) se aplica en varios sitios del código a lo largo del tiempo, conviene revisar los sitios más antiguos al introducir el campo que los habría corregido a todos desde el principio — un campo nuevo no se propaga solo a los cálculos que ya existían antes de que él existiera.

---

## 24. El veredicto de salud podía salir "Sana" con la planta encharcada varios días seguidos

**Síntoma**: con `pct_saturado` ya corregido (#23) y mostrando 99%, el veredicto seguía siendo "✅ Sana".

**Diagnóstico**: la lógica de veredicto solo contemplaba dos condiciones — humedad por debajo del mínimo con demasiada frecuencia, o recuperación lenta *tras un riego*. Sin ningún riego en la ventana (el caso real: la planta llevaba días sin necesitarlo, precisamente por estar encharcada), la segunda condición ni siquiera se evaluaba, porque `tiempo_recuperacion_medio_h` se mide desde un evento de riego que no existía.

**Solución**: nueva condición en la cadena de veredicto — más de la mitad del tiempo de la ventana por encima de `humedad_max` también dispara "revisar_drenaje", con su propio mensaje, sin depender de que haya habido ningún riego.

**Aprendizaje**: una métrica puede estar bien calculada y aun así no influir en la conclusión final si nada aguas abajo la conecta — `pct_saturado` ya existía y ya era correcto en ese momento, pero el veredicto nunca la miraba. Vale la pena revisar, tras corregir un dato, si algo debería estar usándolo y no lo está.

---

## 25. La tasa de secado confundía ruido del sensor con secado real

**Síntoma**: para esa misma planta encharcada y prácticamente estable (41-42%, sin apenas variación), el resumen de salud mostraba "0.22-0.25%/h" de ritmo de secado y el mensaje decía "se seca más rápido de lo habitual" — contradictorio con llevar días sin bajar de verdad.

**Diagnóstico**: la fórmula original promediaba la pendiente de **cada** bajada puntual entre dos lecturas consecutivas, sin restar las subidas que las compensan. En una señal prácticamente plana con el ruido normal de un sensor capacitivo (42, 41, 42, 41...), siempre hay bajadas puntuales que contar, pero nunca se contabilizan las subidas que las anulan — el resultado sale sistemáticamente sesgado al alza incluso sin secado real de fondo.

**Solución**: en vez de paso a paso, medir tramos reales de bajada sostenida (de un máximo local a un mínimo local, de al menos 3 horas), descartando los tramos más cortos como ruido. Verificado con casos sintéticos antes de desplegar: una señal plana con ruido pasó de dar una tasa positiva falsa a dar `None` (sin dato, correctamente), y un secado real de 70% a 30% en 40 horas siguió dando exactamente 1%/h.

**Aprendizaje**: un estimador que solo acumula eventos en una dirección (aquí, "cualquier bajada") sobre una señal con ruido simétrico sale sesgado por construcción, aunque cada bajada individual sea un dato real — hay que medir la tendencia neta (pico a valle), no una única cara del ruido. El fallo lo detectó una observación de sentido común de Luis ("¿cómo va a secarse rápido si lleva días igual?"), no una revisión de código — la señal más fiable de un cálculo mal planteado suele ser que el resultado no cuadra con lo que se ve a simple vista, no un error de sintaxis.

---

## 26. `humedad_suelo_raw` nunca llegaba a InfluxDB pese a que el firmware ya lo publicaba

**Síntoma**: ninguno visible todavía — detectado antes del primer uso real, al revisar de pasada cómo crecía el almacenamiento de InfluxDB.

**Diagnóstico**: el firmware llevaba desde la semana anterior publicando `humedad_suelo_raw` por MQTT (pensado para el endpoint de calibración del sensor), pero el nodo de Node-RED "Formatear para InfluxDB" reconstruye el objeto que se escribe en la base de datos con una lista fija de campos, y ese campo nunca se había añadido a esa lista — se quedaba en el mensaje MQTT sin llegar nunca a InfluxDB. El endpoint de calibración habría fallado siempre, con un mensaje de "sin lectura reciente", el primer día que alguien lo hubiera usado de verdad.

**Solución**: añadir `humedad_suelo_raw` al objeto que construye el nodo de Node-RED.

**Aprendizaje**: en un pipeline con una transformación intermedia explícita (aquí, un nodo que reconstruye el mensaje campo a campo en vez de reenviarlo tal cual), añadir un campo en el origen no basta por sí solo — hay que revisar cada punto del camino que filtra o reconstruye el payload. Un campo nuevo en el firmware no llega solo a la base de datos.

---

## 27. El nivel "gratuito" de Gemini no era gratuito de verdad para la cuenta usada

**Síntoma**: al integrar el diagnóstico visual con la API de Gemini (elegida sobre Claude precisamente por tener nivel gratuito), las peticiones fallaban de forma consistente con `503 UNAVAILABLE`, mensaje `"This model is currently experiencing high demand"` — cinco intentos repartidos en 15 minutos, todos con el mismo error, contra dos modelos distintos (`gemini-flash-latest` y después `gemini-3.5-flash-lite`, probado como alternativa menos cargada).

**Diagnóstico**: que el mismo error apareciera de forma idéntica en dos modelos diferentes, de forma sostenida durante 15 minutos, hacía poco creíble que fuera solo un pico de demanda puntual del servicio — un pico real suele ser intermitente, no un fallo del 100% de las peticiones. Para aislar si era un problema del servicio de Google en general o algo específico de la cuenta, se probó exactamente la misma foto directamente en Google AI Studio (mismo login, sin pasar por la API ni por nuestro código) — y ahí apareció un diálogo `"Upgrade to unlock more"` pidiendo activar facturación. Eso confirmó que el nivel gratuito estaba topado de verdad para esa cuenta concreta (reutilizada, con uso previo a este proyecto), no que Google estuviera caído.

**Solución**: cambio a Groq (`app/services/plant_vision.py`), que sí tiene un plan gratuito real y publicado (límites de peticiones por día/minuto documentados, no un trial que caduca ni una cuota ya agotada por otro uso), en una cuenta nueva y distinta de Google.

**Aprendizaje**: un error 503 "alta demanda" que se repite de forma idéntica en el 100% de los intentos, durante minutos y contra más de un modelo, es una señal de que probablemente no es demanda — es un límite de cuenta disfrazado de mensaje de capacidad. La forma más rápida de distinguir "el servicio está saturado" de "mi cuenta ha tocado un límite" es reproducir la misma petición fuera del propio código, directamente en la consola oficial del proveedor con la misma cuenta — si falla igual ahí, no es el código. Y en general: un "nivel gratuito" solo se puede dar por bueno probándolo de verdad con la cuenta real que se va a usar, nunca solo confiando en lo que promete la documentación — "gratis" puede significar cosas muy distintas según el proveedor y el historial previo de esa cuenta concreta.

---

## 28. El diagnóstico visual nunca recibía los datos de los sensores, solo la foto

**Síntoma**: ninguno visible a nivel de error — la primera petición real contra Groq devolvió `200 OK` con un veredicto y un mensaje coherentes ("bien", hablando de flores y hojas), así que a primera vista parecía funcionar. Luis preguntó explícitamente si el modelo tenía en cuenta algo más aparte de la foto, porque el mensaje no mencionaba nada de humedad pese a que ese mismo dispositivo llevaba días en exceso de agua según los sensores (confirmado en varias entradas anteriores de este mismo documento).

**Diagnóstico**: al reescribir `plant_vision.py` para pasar de Gemini a Groq (entrada #27), la función `_resumen_sensores()` se seguía llamando y su resultado se guardaba en la variable `contexto` — pero la línea que añadía ese texto al mensaje enviado al modelo (`instrucciones += f"\nDatos de los sensores:\n{contexto}"`) se perdió en la reescritura. El modelo nunca vio ni una sola cifra de humedad o temperatura; solo la foto. La API respondía con éxito y un texto plausible, lo que ocultaba por completo que faltaba la mitad de la información prometida.

**Solución**: recuperar la línea que faltaba, y reforzar además el propio texto de instrucciones para pedir explícitamente que compare la foto con los datos de los sensores y señale cualquier contradicción entre ambos (antes solo se le pasaba el contexto sin pedirle que lo usara de forma activa).

**Aprendizaje**: un `200 OK` con una respuesta que "suena bien" no prueba que la petición llevara todo lo que debía llevar — aquí, a diferencia de un fallo con traceback, no había ningún error que mirar; el propio caso de prueba (probarlo con un dispositivo cuyo estado real ya se conocía de sobra) fue lo que permitió notar que faltaba algo, comparando lo que decía la IA con lo que ya se sabía por otra vía. Al reescribir una función para cambiar de proveedor, comparar línea a línea con la versión anterior (o, mejor, escribir antes un caso de prueba que confirme qué contiene realmente la petición enviada) habría detectado esto antes de desplegarlo.

---

## 29. `created_at` del diagnóstico visual se quedaba congelado en la primera foto

**Síntoma**: tras subir una segunda foto (con veredicto y mensaje nuevos, correctos), la respuesta seguía mostrando la fecha de la primera captura, minutos antes.

**Diagnóstico**: `created_at` tiene `server_default=func.now()` en el modelo — eso solo lo rellena Postgres en un `INSERT`, nunca en un `UPDATE`. Como `plant_photo_diagnoses` guarda una sola fila por dispositivo que se sobreescribe (a propósito, ver la entrada de diseño en `docs/architecture.md`), la segunda captura y las siguientes son siempre un `UPDATE` sobre la misma fila — así que el campo nunca se volvía a tocar tras la primera vez.

**Solución**: fijar `existente.created_at = datetime.now(timezone.utc)` explícitamente en la rama de actualización del endpoint, ya que `server_default` no cubre ese camino.

**Aprendizaje**: `server_default` resuelve el valor inicial de una columna, no su ciclo de vida completo — en cualquier tabla donde una fila se actualiza en vez de crearse de nuevo cada vez (patrón "una fila por entidad, se sobreescribe", distinto del habitual "una fila nueva por evento" que ya usan `health_summaries` o `watering_events`), hay que decidir explícitamente qué columnas de fecha deben actualizarse a mano en el `UPDATE` y cuáles no.

---

## 30. El análisis del veredicto fallaba cuando el modelo no respetaba el formato pedido

**Síntoma**: una petición a `POST /photo-diagnosis` dio `502` con `ValueError: Respuesta del modelo sin veredicto reconocible`, pese a que la respuesta de Groq (visible en el log) era perfectamente válida y coherente: `"Bien. Aunque las fotos de la planta... la muestran esponjadamente sana..."`.

**Diagnóstico**: el prompt le pide al modelo que ponga el veredicto solo en la primera línea (`"Bien\nResto del mensaje"`), pero el análisis de la respuesta (`_parse_respuesta`) exigía ese salto de línea de forma estricta (`texto.partition("\n")`). El modelo, en la práctica, no siempre lo respeta — esta vez escribió `"Bien."` seguido del resto del mensaje en la misma línea, sin salto. Como la "primera línea" resultante era todo el párrafo entero, ninguna de las tres palabras de veredicto coincidía y la petición se rechazaba entera, aunque el contenido fuera perfectamente usable.

**Solución**: sustituir el `partition` estricto por una expresión regular que busca la palabra de veredicto al principio del texto tolerando puntuación, guiones o saltos de línea indistintamente entre la palabra y el resto del mensaje (`^(bien|revisar|preocupante)\b[\s.:,;\-—–]*`). Verificado contra los formatos reales vistos en producción antes de desplegar.

**Aprendizaje**: un LLM sigue instrucciones de formato de forma probabilística, no como un contrato — pedirle "responde así exactamente" reduce la probabilidad de que se salte el formato, pero no la elimina. El código que interpreta su respuesta tiene que ser tan tolerante como haga falta para aceptar cualquier variación razonable del formato pedido, no solo la más esperable; un analizador que solo acepta la forma exacta del ejemplo del prompt es, en la práctica, un analizador frágil.

---

## 31. La duración del riego nunca variaba por tipo de planta, pese a que el catálogo sí tenía un valor por tipo

**Síntoma**: Luis observó un riego real "largo" en un cactus — contradictorio, ya que el catálogo de tipos de planta existe precisamente para evitar que todos los dispositivos rieguen igual.

**Diagnóstico**: la columna `plant_types.default_duracion_riego_ms` existe desde el catálogo original (`suculenta-cactus` = 4000ms, frente a 9000ms del resto), y `devices.duracion_riego_ms` también — pero nada en la cadena end-to-end llegaba a aplicarla nunca. `DeviceConfigScreen.tsx`'s `selectPlantType()` copiaba humedad/horario al elegir un tipo, pero no la duración; y `PATCH /api/devices/{id}` ni siquiera aceptaba ese campo en su schema (`DeviceUpdate`) — así que, aunque la app lo hubiera mandado, el backend lo habría ignorado en silencio. Resultado: todo dispositivo quedaba fijo para siempre en el `server_default` de 9000ms de la migración original, sin importar qué tipo de planta se le asignara.

**Solución**: añadir `duracion_riego_ms` a `DeviceUpdate` y a la rama de actualización de `PATCH /api/devices/{id}`, copiar el valor del tipo al elegirlo en el selector (igual que ya se hacía con humedad/horario), y exponer un campo editable en `DeviceConfigScreen.tsx`. No hizo falta migración — la columna ya existía, solo le faltaba un camino para llegar a ella.

**Aprendizaje**: que una columna exista y tenga un valor por tipo sembrado en el catálogo no significa que el dato llegue a usarse — hay que trazar la cadena completa (UI → schema de entrada → router → modelo) para cada campo nuevo, no asumir que "está en la base de datos" implica "está conectado". Mismo tipo de gap que #22/#23 (umbral fijo que debía ser relativo al tipo de planta), pero esta vez en el extremo de escritura en vez del de lectura.

---

## 32. Subir una foto fallaba con "Unsupported FormDataPart implementation" — nunca se había probado en un dispositivo real

**Síntoma**: al pulsar "Actualizar foto" en la primera instalación real de la build (el código llevaba semanas escrito pero nunca ejecutado en un móvil, solo compilado), saltaba un error genérico ("No se pudo analizar la foto") y en el log del backend no aparecía ni rastro de la petición — ni siquiera un intento fallido. Tras mejorar el mensaje de error para que mostrase la excepción real (`err.message` en vez de un texto fijo) y probar otra vez con la app ya conectada al servidor de desarrollo (sin necesitar una build nueva para cada intento), el mensaje real fue: `Unsupported FormDataPart implementation`.

**Diagnóstico**: Expo SDK 57 instala `expo/fetch` como el `fetch` global de la app, sustituyendo al `fetch` "clásico" de React Native. Su codificador de `FormData` es más estricto: solo acepta como parte un `string`, un `Blob` real, o un objeto con un método `bytes()` — y el código construía la parte del fichero con el patrón "legacy" de React Native, `{uri, name, type}` forzado a `Blob` con un cast de TypeScript (`as unknown as Blob`), que nunca fue un `Blob` de verdad. Ese patrón llevaba años siendo el estándar en RN y dejó de funcionar sin más aviso que este error al cambiar de runtime de `fetch`.

**Solución**: convertir el fichero local a un `Blob` real antes de añadirlo al `FormData`, sin depender de ningún módulo nativo nuevo (lo que habría exigido una build de EAS solo para esto): `const blob = new Blob([await (await fetch(photoUri)).blob()], {type: "image/jpeg"})`, fijando el tipo explícitamente porque un `fetch` a un `file://` local no siempre trae el content-type correcto. `formData.append("photo", blob, "planta.jpg")` en vez del objeto `{uri,name,type}`.

**Aprendizaje**: un cambio de versión del SDK (aquí, qué implementación de `fetch` usa `globalThis.fetch` por defecto) puede romper un patrón que llevaba años siendo "el estándar", sin que lo señale ningún aviso de compilación — el error solo aparece en tiempo de ejecución, en un dispositivo real. Mejorar el mensaje de error para mostrar la excepción real (en vez de un texto genérico fijo) fue lo que permitió diagnosticarlo en segundos en vez de adivinar a ciegas; vale la pena hacerlo también en el resto de `catch` genéricos de la app, no solo aquí.

---

## 33. La miniatura de la foto no cargaba — cabeceras personalizadas en `<Image>`, poco fiables en Android

**Síntoma**: en el mismo log del backend que reveló el problema #32 aparecían peticiones repetidas a `GET .../photo-diagnosis/image` devolviendo `401 Unauthorized` — y en la app, la miniatura de la foto se quedaba como un hueco gris vacío en vez de mostrar la imagen.

**Diagnóstico**: `getPhotoDiagnosisImageSource()` construía `{uri, headers: {Authorization: "Bearer ..."}}`  y se lo pasaba directamente a `<Image source={...}>`, confiando en que el componente nativo usara esas cabeceras en su petición de red interna. Ese mecanismo es conocido por ser poco fiable en Android, y además no tenía ningún reintento si el access token había caducado mientras tanto (a diferencia de `apiRequest`, que sí refresca el token y reintenta una vez ante un 401) — un fallo silencioso sin ningún mensaje de error visible, solo la imagen que nunca llega a aparecer.

**Solución**: dejar de pasarle cabeceras a `<Image>` del todo. En su lugar, `getPhotoDiagnosisImageSource()` descarga la imagen ya autenticada con `fetch` (con el mismo patrón de reintento-tras-401 que `apiRequest`, usando el `refreshAccessToken` ya existente, ahora exportado para reutilizarlo), la convierte a un `Blob` y de ahí a un data URI con `FileReader.readAsDataURL()`, y se la pasa a `<Image source={{uri: dataUri}}>` ya embebida — sin cabeceras que puedan fallar en silencio. Si la descarga falla por cualquier motivo, devuelve `null` y la app no muestra ningún hueco vacío en su lugar (en vez de intentar y fallar silenciosamente).

**Aprendizaje**: las cabeceras personalizadas en `<Image>` de React Native son una ruta de red completamente aparte del resto de la app (no pasa por `apiRequest`, no hereda su lógica de refresco de sesión) — cualquier pantalla que las use hereda silenciosamente el mismo punto ciego de autenticación que ya se evitó en todos los demás sitios. Más robusto descargar con el mismo mecanismo autenticado que ya existe y pasarle a `<Image>` el resultado ya resuelto, que confiarle a un componente nativo una cabecera que puede caducar sin que nadie se entere.

---

## 34. La fila-resumen de la app parecía congelada mientras el OLED del dispositivo sí cambiaba

**Síntoma**: probando en vivo el banner de pausa del sensor, Luis movía la sonda y veía el porcentaje cambiar en el OLED del macetero, pero la app se quedaba con el mismo valor durante varios minutos, pese a estar refrescándose cada pocos segundos.

**Diagnóstico**: la fila-resumen leía el último punto de `GET /readings`, que agrega con `aggregateWindow()` a una resolución que depende del rango pedido (`1m` para ≤6h, `10m` para ≤48h, `1h` en adelante — ver `influx_client._aggregate_window()`). Con el rango por defecto de 24h, eso es una media cada 10 minutos: "el último punto" de esa serie podía tardar hasta 10 minutos en reflejar un cambio real, por mucho que la app lo pidiera cada 3-15 segundos. El arreglo anterior de esa misma sesión (acelerar el `refetchInterval` mientras el sensor está pausado) pedía datos frescos con más frecuencia, pero seguía pidiendo el mismo dato agregado y obsoleto — no resolvía nada por sí solo.

**Solución**: nuevo endpoint de solo lectura `GET /devices/{id}/latest-readings`, que devuelve el último valor real de cada campo sin agregar (reutilizando `influx_client.get_latest_value()`, el mismo helper que ya usaba `/calibrate` para "qué marca el sensor ahora mismo"). La fila-resumen y el banner de pausa pasan a leer de ahí; las gráficas siguen usando el endpoint agregado, que para dibujar un histórico sí es lo correcto.

**Aprendizaje**: "refrescar más a menudo" no arregla un dato que tarda en cambiar por diseño — hay que distinguir entre la fuente de datos (¿con qué resolución se agregó?) y la frecuencia de sondeo (¿cada cuánto se pide?); acelerar la segunda sin tocar la primera da la ilusión de estar arreglando algo sin cambiar nada real. El mismo endpoint agregado puede ser exactamente correcto para una gráfica histórica e incorrecto para un valor "en vivo" — no son el mismo caso de uso aunque parezcan pedir "lo mismo".

---

## 35. La duración de riego configurada en la app nunca llegaba al ESP32 — el fix de #31 cerró el extremo equivocado

**Síntoma**: tras varios días de uso real con `macetero02`, Luis notó que a la bomba "le costaba" dar suficiente agua — sospechaba que faltaban uno o dos segundos de margen por la distancia de manguera hasta la planta.

**Diagnóstico**: #31 (arriba) cerró la cadena desde la app hasta Postgres — pero nunca verificó que el valor llegara al dispositivo físico, y de hecho no llegaba. El firmware de **ambos** dispositivos (`macetero_produccion_6.ino` y `macetero02_dht22.ino`) tiene el riego implementado con una constante fija, `#define TIEMPO_RIEGO 9000`, con un comentario literal "redefinible luego por tipo de planta" que nunca se llegó a cumplir. El parser del topic de configuración retenido (`mqttCallback`, rama `mqtt_topic_config`) solo leía `humedadMin`/`humedadMax`/`soilDry`/`soilWet` — nunca `duracionRiegoMs`. Y en el backend, `publish_device_config()` tampoco lo incluía en el JSON publicado. Resultado: el riego real de los dos dispositivos ha durado siempre 9 segundos fijos desde el primer despliegue, sin que ningún cambio de tipo de planta o ajuste manual en `DeviceConfigScreen` tuviera jamás efecto físico — pese a que la UI, la API y la base de datos reflejaban el valor "correctamente" en todo momento.

**Solución**: tres puntos, igual que el resto de configuración retenida (humedad/calibración). (1) `publish_device_config()` gana un parámetro `duracion_riego_ms`, incluido en el payload como `"duracionRiegoMs"`; se republica también cuando solo cambia la duración, no solo cuando cambia humedad (`config_changed`, antes `humedad_changed`). (2) Ambos firmwares ganan `unsigned long duracionRiegoCfg = TIEMPO_RIEGO;` (arranca con la constante como valor de seguridad hasta que llega la primera config) y una rama más en el parser: `if (cfgDoc.containsKey("duracionRiegoMs")) duracionRiegoCfg = cfgDoc["duracionRiegoMs"];`. (3) El cálculo del límite de riego pasa de `min((unsigned long)TIEMPO_RIEGO, (unsigned long)TIEMPO_RIEGO_MAX)` a `min(duracionRiegoCfg, (unsigned long)TIEMPO_RIEGO_MAX)` — `TIEMPO_RIEGO_MAX` se mantiene intacto como tope de seguridad absoluto, independiente de lo que llegue por config. Requiere reflashear los dos dispositivos; tras el despliegue del backend, cualquier dispositivo ya configurado necesita un guardado más en `DeviceConfigScreen` (aunque sea el mismo valor) para que se dispare la primera publicación retenida con el campo nuevo.

**Aprendizaje, reforzando el de #31**: verificar una cadena "end-to-end" en un sistema con un actuador físico en el extremo exige comprobar el extremo físico de verdad (cronometrar el riego real, no solo leer lo que dice la API) — "funciona end-to-end" se puede confirmar sin querer solo hasta el penúltimo eslabón (la base de datos) y dar por cerrado un bug que seguía vivo en el firmware. Encontrado únicamente porque Luis cronometró el riego real contra lo configurado, no por ninguna revisión de código previa — ni siquiera la de esta misma sesión, que llegó a leer este firmware por el motivo #1 (sensor DHT) sin reparar en este punto hasta que se buscó específicamente.

---

## 36. El DHT22 podía publicar valores disparatados (p.ej. 121°C) que contaminaban el diagnóstico

**Síntoma**: tras varios días reales, el diagnóstico de salud (sensores + IA) de `macetero02` empezó a recomendar "revisar el sensor" — el motivo real era que el rango de temperatura de los últimos días incluía picos físicamente imposibles (~121°C).

**Diagnóstico**: `t = dht.readTemperature()`/`h = dht.readHumidity()` se publicaban sin ningún filtro de plausibilidad — a diferencia de `temp_suelo` (DS18B20), que ya comprobaba `DEVICE_DISCONNECTED_C`. Un fallo de lectura ocasional del DHT22 (bus I2C/timing, no necesariamente un fallo de hardware) decodifica basura en vez de fallar limpiamente, y esa basura se publicaba y guardaba como si fuera un dato real — contaminando cualquier `min()`/`max()`/`mean()` calculado sobre la ventana de varios días, incluido el contexto que recibe la IA del diagnóstico visual.

**Solución**: dos capas. (1) Firmware: tras leer, si el valor no es `NaN` pero cae fuera de un rango físicamente plausible (`t < -20 || t > 60`, `h < 0 || h > 100`), se fuerza a `NaN` antes de publicarse — mismo tratamiento que ya recibía un DS18B20 desconectado, el campo se omite/null en vez de mandarse como si fuera válido. (2) Backend: `influx_client.PLAUSIBLE_RANGES` (un rango por campo de `NUMERIC_FIELDS`) se aplica como filtro Flux adicional (`|> filter(fn: (r) => r._value >= min and r._value <= max)`) tanto en `get_readings()` como en `get_latest_value()` — así un valor disparatado que ya estuviera guardado en InfluxDB (de antes del fix de firmware) tampoco contamina el resumen de salud ni el diagnóstico con IA mientras siga dentro de la ventana activa. `humedad_suelo_raw` se excluye a propósito: ahí los valores "extremos" son precisamente el dato que la calibración necesita capturar.

**Aprendizaje**: un sensor que "casi siempre funciona bien" sigue necesitando un filtro de plausibilidad en los dos extremos de la cadena (donde se mide y donde se agrega) — arreglar solo el firmware deja contaminados los días ya guardados; arreglar solo el backend no evita que seguir publicando basura ensucie el histórico futuro hasta que alguien vuelva a mirar.

---

## 37. Los campos de `DeviceConfigScreen` a veces se veían en blanco al entrar, aunque tuvieran valor

**Síntoma**: Luis reportó que, de forma intermitente, al abrir "Configuración" los campos de hora de inicio/fin de riego y duración parecían vacíos — pero el valor SÍ estaba guardado (`handleSave` funcionaba con normalidad, y saliendo y volviendo a entrar a la pantalla ya se veían bien).

**Diagnóstico**: el patrón de inicialización (`useEffect` que rellena los `useState` de cada campo en cuanto `deviceQuery.data` llega, guardado por `isInitialized` para no repetirse) es correcto en cuanto a datos — el problema es puramente de repintado. Un `TextInput` controlado de React Native en Android tiene un bug conocido y antiguo: si el componente ya se montó una vez con `value=""` (mientras la query todavía cargaba) y luego el `value` cambia de golpe al dato real, la vista nativa (`EditText`) a veces no refleja la actualización en la primera pasada — el valor interno de React es correcto, pero no llega a pintarse hasta el siguiente remontaje o repintado forzado.

**Solución**: añadir `key={`campo-${isInitialized}`}` a cada `TextInput` que depende de datos cargados de forma asíncrona (nombre, humedad mínima, horas, duración). Al cambiar la `key` justo cuando `isInitialized` pasa de `false` a `true`, React desmonta el `TextInput` "vacío" y monta uno nuevo ya con el valor real desde el primer render — nunca intenta una actualización en caliente que pueda perderse.

**Aprendizaje**: cuando un valor controlado "parece" no estar aplicándose en Android pese a que el estado de React es correcto (confirmable con un `console.log` o con las dev tools), sospechar primero del propio `TextInput` nativo antes de rehacer la lógica de carga de datos — forzar un remontaje con `key` es la vía estándar y más simple para este bug concreto, sin tocar nada del flujo de datos que ya funcionaba bien.

---

## 38. El teclado tapaba el campo que se estaba rellenando, sin forma de ver lo que se escribía

**Síntoma**: en `LoginScreen` (contraseña) y `DeviceConfigScreen` (horas/duración de riego), el teclado podía solaparse con el campo activo, dejando al usuario escribiendo "a ciegas" sin ver el valor.

**Diagnóstico**: ninguna de las dos pantallas envolvía su contenido en `KeyboardAvoidingView`. `DeviceConfigScreen` ya usaba `ScrollView` (así que técnicamente podía desplazarse), pero nada hacía scroll automático hasta el campo activo al abrirse el teclado; `LoginScreen` ni siquiera era desplazable (`View` con `justifyContent:"center"`), así que en pantallas pequeñas el teclado simplemente dejaba contenido fuera de la vista sin ninguna vía para verlo.

**Solución**: envolver ambas pantallas en `KeyboardAvoidingView` (`behavior="padding"` en iOS, `"height"` en Android — el patrón estándar de React Native, sin librerías nuevas) y, en `LoginScreen`, convertir el contenedor fijo en un `ScrollView` con `keyboardShouldPersistTaps="handled"` para que sea desplazable de verdad.

**Aprendizaje**: cualquier pantalla con campos de texto necesita `KeyboardAvoidingView` desde el principio en React Native — no es un comportamiento que el sistema operativo resuelva solo por defecto en todos los casos, y es fácil no notarlo en desarrollo si se prueba siempre con pantallas grandes o con el emulador en vertical sin teclado físico.

---

## 39. Los riegos registrados salían con 1-2 horas de adelanto

**Síntoma**: al preparar el historial de riegos en la app, el primer riego de prueba aparecía en el futuro (una o dos horas por delante de la hora real).

**Diagnóstico**: el ESP32 sincroniza el RTC por NTP con la zona horaria de Madrid (`Validez temporal` en `docs/architecture.md`), así que el RTC guarda la hora **local**, no UTC. Pero `rtc.now().unixtime()` solo cuenta segundos desde 1970 sobre lo que contenga el RTC: devuelve un número que es "hora de Madrid etiquetada como si fuera UTC". El backend guardaba ese número tal cual en `watering_events.timestamp` (UTC), por lo que cada riego salía 1 h adelantado en invierno (CET) y 2 h en verano (CEST). No se había notado porque hasta ahora ninguna pantalla mostraba esa hora. No afecta a las lecturas de sensores (Node-RED les pone la hora de recepción en InfluxDB) ni al bloqueo de 24 h entre riegos (Node-RED usa `recibidoEn = Date.now()`, no el timestamp del dispositivo).

**Solución**: sin tocar firmware. `time_utils.device_unix_to_utc()` reinterpreta el valor recibido como hora local de `Europe/Madrid` y lo convierte a UTC (respeta el cambio de hora, requiere la dependencia `tzdata` en la Pi), y se usa al guardar cada `riego_completado` en `mqtt_client.py`. Una migración de datos (`a8f2d6b41c93`) aplica la misma conversión a los riegos ya guardados (`UPDATE watering_events SET timestamp = (timestamp AT TIME ZONE 'UTC') AT TIME ZONE 'Europe/Madrid'`); su `downgrade` la deshace. Detalle borde: una hora del cambio de otoño es ambigua (se repite 02:00-03:00) y se resuelve a la primera ocurrencia — un riego en esa franja puede quedar desfasado 1 h, asumible.

**Aprendizaje**: un timestamp Unix de un microcontrolador solo es "UTC" si el RTC realmente guarda UTC; con NTP + zona horaria local, el RTC guarda hora local y `unixtime()` miente. Al integrar un dispositivo nuevo, comprobar con un evento real a qué hora dice el dispositivo que ocurrió algo, no asumirlo.
