luistorrerodri/EcoPlant-Platform/(commit log)

2026-08-31 Añadir documentación de hardware y troubleshooting
2026-08-31 Exportar configuración de Node-RED y Grafana
2026-08-31 Migrar a topics escalables por device_id y actualizar documentación
2026-08-31 Añadir confirmación de riego y detección de desconexión (LWT)
2026-08-31 Actualizamos flujo JSON de Node-red
2026-08-31 Riego no bloqueante con maquina de estados y tope de seguridad, añadidos firmware/README y platform/README
2026-09-01 Renombrar READMEs de carpeta
2026-09-01 Implementar autenticacion mutua (mTLS) con certificado por dispositivo
    Sustituye usuario/contrasena por certificados de cliente firmados por
    la CA propia (CN = device_id), validados por Mosquitto via
    require_certificate + use_identity_as_username. Firmware actualizado
    para cargar CLIENT_CERT/CLIENT_KEY y conectar sin credenciales.
    Documentado el procedimiento completo de generacion y despliegue, y
    un bug real encontrado en el proceso (CA_CERT desactualizado en el
    firmware, entrada 13 de troubleshooting).
    [macetero_produccion_6.ino]
2026-09-01 Acceso remoto al dashboard: Caddy + Cloudflare Tunnel
    Expone solo /ui de Node-RED (dashboard) a internet bajo demanda, sin
    abrir puertos en el router: Caddy filtra por ruta localmente y un
    Quick Tunnel de Cloudflare da la URL publica, arrancado a mano solo
    para hacer demos. Documentados dos bugs reales de configuracion de
    Caddy encontrados en el proceso (entrada 14 de troubleshooting).
2026-09-02 Iniciar backend API (FastAPI): esqueleto y config
    Primer paso del backend multiusuario: estructura de carpetas,
    requirements.txt, plantilla de variables de entorno y una app minima
    con /api/health, sin logica de negocio todavia.
2026-09-02 Modelos de datos y configuracion de Alembic
    Anade User, Location, Device y RefreshToken (SQLAlchemy) y deja
    Alembic listo para generar la primera migracion. La URL de conexion
    se toma de app/config.py (unica fuente de verdad), no de alembic.ini.
2026-09-02 Anadir carpeta alembic/versions (Git no versiona directorios vacios)
    La carpeta no llegaba al repo, asi que alembic revision --autogenerate
    fallaba en la Pi al no poder escribir el archivo de migracion.
2026-09-02 Autenticacion: registro, login, refresh, logout, perfil
    JWT de acceso de corta duracion + refresh tokens con rotacion,
    guardados hasheados en BD para poder revocarlos (logout, cambio de
    contraseña). Fija bcrypt<4.1 por incompatibilidad conocida con
    passlib 1.7.4.
2026-09-02 CRUD de ubicaciones (usuario -> ubicacion)
    Aislamiento por owner_id: siempre 404 (no 403) cuando el recurso es
    de otro usuario, para no filtrar si existe. Borrar una ubicacion con
    dispositivos enganchados devuelve 409 en vez de desengancharlos en
    silencio (Device.location_id es ON DELETE RESTRICT).
2026-09-02 Flujo de reclamacion de dispositivos (sin MQTT/InfluxDB todavia)
    Alta de dispositivos y rotacion de codigo de reclamacion (solo admin,
    sin endpoint de autopromocion a admin por diseno), reclamar/listar/
    gestionar/desenganchar dispositivos propios. El codigo de reclamacion
    es de un solo uso, hasheado, y solo se muestra en claro al sembrarlo.
2026-09-02 Cliente MQTT (mTLS) y endpoint de riego manual
    Conexion asincrona (connect_async + loop_start) para que un Mosquitto
    no disponible al arrancar no tumbe el API. POST /devices/{id}/water
    comprueba propiedad y publica REGAR en maceteros/{id}/comando con la
    identidad backend-api verificada en el paso anterior.
2026-09-02 Endpoint de lecturas historicas (InfluxDB, token de solo lectura)
    Mismo patron de filtros Flux que ya usa el resto del repo
    (_measurement -> _field -> device_id). El campo estado se consulta
    aparte con last() por ser texto, siguiendo la leccion aprendida ya
    documentada en troubleshooting #8. Arregla ademas el logging: los
    INFO no se veian por falta de basicConfig.
2026-09-02 Agregar (downsample) las lecturas historicas por ventana de tiempo
    Sin agregar, 24h de datos del ESP32 (una lectura cada 4s) son unos
    21.600 puntos por campo - demasiado para una respuesta de API o un
    grafico. La resolucion se reduce segun el rango pedido.
2026-09-02 Anadir migracion inicial de Alembic (users, locations, devices, refresh_tokens)
2026-09-02 Documentar el backend multiusuario
    Seccion nueva en docs/architecture.md (por que Postgres, tokens
    revocables, codigo de reclamacion), guia de despliegue en
    platform/README.md, backend/README.md nuevo, checklist del README
    actualizado, y cuatro entradas reales de troubleshooting (carpeta
    alembic/versions no versionada, incompatibilidad passlib/bcrypt,
    Swagger UI con respuestas grandes, permisos de git en la Pi). De
    paso, corrige la afirmacion imprecisa sobre donde vive ca.key.
2026-09-03 Notificaciones push: token del usuario + suscripcion MQTT a estado
    Nueva columna push_token en User y POST /api/auth/push-token. El
    cliente MQTT del backend pasa de solo publicar a tambien suscribirse
    a maceteros/+/estado; al detectar una desconexion o un riego
    completado, resuelve el propietario del dispositivo y le envia una
    notificacion via la API publica de push de Expo.
2026-09-03 App movil (React Native + Expo): auth, ubicaciones, dispositivos, riego
    Primera version funcional, probada en dispositivo Android real contra
    el backend en produccion: login/registro con JWT (access + refresh,
    guardados en SecureStore, con reintento automatico tras 401), listar
    y crear ubicaciones, reclamar dispositivos, ver historico agregado en
    graficos y regar manualmente - confirmado activando la bomba real.
2026-09-03 Configurar EAS Build (proyecto y perfil de desarrollo)
2026-09-03 Notificaciones push en la app: permiso, token, registro tras login
    Pide permiso al usuario, obtiene el token de push de Expo (necesita
    el projectId de EAS, ya configurado) y lo registra en el backend via
    POST /api/auth/push-token justo despues de iniciar sesion o
    registrarse. Requiere la build de desarrollo (no funciona en Expo Go
    en Android desde el SDK 53).
2026-09-03 Firebase (FCM) para notificaciones push + perfil completo
    google-services.json vinculado en app.json (contenido publico, solo
    identifica el proyecto - la clave de administrador de Firebase para
    FCM V1 se subio directamente a EAS, nunca al repositorio). Perfil de
    usuario completo: cambiar contrasena y URL del servidor configurable.
2026-09-03 Documentar la app movil: arquitectura, despliegue y checklist
    Nueva seccion "App movil" en docs/architecture.md (React Native +
    Expo, SecureStore, interceptor de refresh, URL configurable,
    notificaciones push via FCM), mobile/README.md nuevo, Caddyfile
    documentado con el bind a la LAN, y checklist/stack del README raiz
    actualizados.
2026-09-04 Dominio fijo (ecoplantplatform.com) + tunel con nombre para la app
    api.ecoplantplatform.com, siempre activo, sustituye a la IP de la LAN
    como URL por defecto de la app movil - funciona igual en casa o
    fuera, sin cambiar nada a mano. Documentado el bug real encontrado
    al verificarlo: Caddy no arrancaba tras un reinicio de la Pi por una
    condicion de carrera con la red (entrada 19 de troubleshooting),
    arreglado con un override de systemd (network-online.target +
    Restart=on-failure).
2026-09-04 Icono propio de la app (brote/sprout en verde)
    Reemplaza los assets por defecto de Expo por un icono a medida
    (icon, adaptive icon de Android con capas foreground/background/
    monochrome, favicon y splash) generado con sharp a partir de SVG.
    Requiere una build nueva para verse - no se actualiza en la que ya
    esta corriendo.
2026-09-04 Reemplaza el icono por el diseño definitivo de la hoja/brote
    Basado en el logo original del usuario (vector EPS), con los colores
    invertidos: fondo verde de marca, hoja blanca y venas/tallo en verde.
    Sustituye el icono provisional de la primera iteración.
2026-09-04 Corrige el margen de las graficas y las agrupa por suelo/ambiente
    El ancho del grafico no coincidia con el padding real del contenedor
    (restaba 32px en vez de los 40px reales), lo que lo desbordaba por la
    derecha y cortaba la ultima etiqueta de hora del eje X.
    De paso, el selector de campo pasa de tres botones sueltos a dos
    categorias (Suelo / Ambiente) que agrupan sus graficas, mas visual que
    alternar entre humedad, temperatura y presion por separado.
    Tambien documenta en docs/architecture.md el roadmap acordado para la
    siguiente iteracion: catalogo de tipos de planta con valores por
    defecto, interior/exterior por dispositivo, integracion meteorologica
    para riego exterior y aprendizaje au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
2026-09-04 Catalogo de tipos de planta: config de riego migrada a Postgres
    Roadmap paso 1 (docs/architecture.md). La configuracion de riego
    (humedad minima, franja horaria, duracion del pulso), hasta ahora solo
    en el contexto de Node-RED, pasa a vivir en devices.* en Postgres -
    editable desde la app via PATCH /api/devices/{id}. Node-RED deja de
    ser la fuente de verdad: pasa a sondear GET /api/internal/device-configs
    (backend en 127.0.0.1, nunca sale de loopback) cada 60s y vuelca la
    respuesta en su global context con la misma forma de siempre, para que
    el nodo de decision de riego -logica en produccion controlando una
    bomba real- no se toque en absoluto.
    Catalogo inicial de 12 tipos de planta (plant_t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
2026-09-04 Recupera la migracion push_token que se aplico en la Pi sin comitear
    alembic upgrade head fallaba en la Pi con "Multiple head revisions":
    8afb2f1757a7 (anadir push_token a users) se genero y se aplico ahi
    directamente en una sesion anterior, pero el archivo nunca llego al
    repositorio. Se recupera tal cual desde la Pi y se reencadena la
    migracion del catalogo de plantas detras de ella en vez de detras de
    32dd032060ba. Documentado como troubleshooting #20.
2026-09-04 Anade interior/exterior como atributo del dispositivo
    Roadmap paso 2 (docs/architecture.md). Columna environment en devices
    ("interior"/"exterior"/sin especificar), editable desde la misma
    pantalla de configuracion del catalogo de plantas. Puramente aditiva:
    no toca Node-RED ni el ciclo de riego, es solo la bandera que el paso
    3 (meteorologia) todavia no consulta.
2026-09-04 Integracion meteorologica (Open-Meteo) para riego exterior
    Roadmap paso 3. Location gana latitude/longitude opcionales, editables
    desde la app (LocationsScreen al crear, LocationDetailScreen para
    editar una ya existente). Nuevo weather_client.py (Open-Meteo, sin API
    key, cache en memoria de 45 min) calcula lluviaPrevista por dispositivo
    -solo true si environment=="exterior" y su ubicacion tiene coordenadas-
    y se anade al mismo objeto que ya sirve GET /api/internal/device-configs,
    reutilizando el sondeo de Node-RED del paso 1 sin infraestructura nueva.
    Diseñado a prueba de fallos: cualquier error de red/timeout/respuesta
    inesperada de Open-Meteo se trata igual que "sin lluvia prevista" -
    nu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
2026-09-04 Sincroniza flows.json con el estado real del editor en la Pi
    El snapshot del repo llevaba desde el roadmap paso 1 sin reflejar los
    cambios hechos a mano en el editor en vivo: el sondeo a
    /api/internal/device-configs (inject + http request + "Aplicar config
    recibida"), los sliders del dashboard desconectados de su escritura
    directa, "Init config maceteros" deshabilitado, y ahora las dos lineas
    de "Decision riego" para el paso 3 (meteorologia).
    El token real de X-Internal-Token del nodo http request se sustituye
    por un placeholder antes de comitear - nunca se versiona, igual que
    las credenciales de MQTT/InfluxDB que ya requerian rellenarse a mano
    tras importar este archivo.
2026-09-04 Rediseña graficas y la seccion GPS a partir de lo visto en pantalla
    Graficas: cambia de react-native-chart-kit a react-native-gifted-charts
    (curva suave, area con degradado, sin puntos individuales) y corrige de
    raiz el corte por la derecha - el ancho ya no se calcula a ciegas desde
    Dimensions.get("window") sino que se mide con onLayout el espacio real
    disponible. Las etiquetas de hora del eje X se dibujan aparte (la
    libreria las trunca con "..." en cuanto hay mas de un puñado de puntos,
    por reservar el ancho de cada etiqueta al espaciado entre puntos). El
    eje Y ya no empieza siempre en 0 - se ajusta al rango real de cada
    campo, para que presion (valores siempre cerca de 1013) no salga
    apl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
2026-09-04 Selector de rango de tiempo en graficas e iconos en la barra inferior
    DeviceDetailScreen: pastillas 6h/24h/2d/7d sobre las graficas - el
    backend ya soportaba el parametro hours en /readings, no hacia falta
    tocar nada del lado del servidor. ReadingsChart pasa a mostrar fecha
    ademas de hora en las etiquetas del eje X cuando el rango pedido supera
    36h (7 dias solo con "HH:MM" habria sido ambiguo).
    AppTabs: iconos (emoji, coherente con el resto de la app) en vez del
    recuadro vacio por defecto de React Navigation.
    Verificado visualmente con el mismo arnes de previsualizacion en web
    antes de comitear.
2026-09-04 Anade rango de 2h al selector de graficas
    Para detectar cambios bruscos en poco tiempo. El backend ya soporta
    cualquier hours en /readings (umbral <=6h para la agregacion mas
    detallada), asi que no hace falta tocar nada del lado del servidor.
2026-09-04 Cierra el pendiente de troubleshooting #19: Mosquitto y Node-RED
    Revisados los cuatro servicios que quedaron señalados como no
    comprobados tras el fallo real de Caddy. InfluxDB y Grafana ya traian
    network-online.target de fabrica. Mosquitto (network.target) y
    Node-RED (sin ninguna dependencia de red) se corrigen con el mismo
    override ya aplicado en la Pi - el riesgo real era menor que el de
    Caddy porque ninguno de los dos fija una IP concreta de la LAN, pero
    se corrige igual por consistencia y sin coste.
2026-09-06 Margen antes de avisar de desconexion + titulos en formularios
    El backend enviaba el push "se ha desconectado inesperadamente" en el
    mismo mensaje LWT (online:false), sin esperar nada. Con el keepalive
    por defecto del firmware (15s, PubSubClient sin setKeepAlive), un
    parpadeo de wifi domestico de un par de segundos ya dispara el LWT del
    broker y el ESP32 se reconecta solo casi al instante - resultado: avisos
    falsos por ruido de red transitorio. Ahora se espera 30s antes de
    comprobar si sigue desconectado de verdad; si llega online:true antes,
    el aviso se descarta. Documentado como troubleshooting #21.
    RegisterScreen y el modal de nueva ubicacion (LocationsScreen) ganan
    un titulo fijo encima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
2026-09-06 Titulos en el resto de campos editables de la app
    Login, reclamar dispositivo, ubicacion GPS y perfil (contrasenas +
    URL del servidor) ganan el mismo titulo fijo encima de cada campo que
    ya se aplico a registro y nueva ubicacion - antes solo tenian texto de
    placeholder, y en la seccion GPS ni eso tenia ejemplo de formato.
    Con esto quedan cubiertos todos los campos editables de la app.
2026-09-06 Conecta el nombre bonito del dispositivo, que ya existia sin usar
    Device.name ya existia en el backend y DeviceCard ya lo mostraba en
    las listas, pero no habia ningun sitio en la app para escribirlo, y
    DeviceDetailScreen mostraba el device_id tecnico como titulo en vez
    del nombre.
    - ClaimDeviceScreen: campo opcional "Nombre de la planta" al reclamar
    un dispositivo nuevo (macetero02 -> "Amapola" desde el primer momento).
    - DeviceConfigScreen: mismo campo para renombrar uno ya reclamado.
    - DeviceDetailScreen: el titulo grande pasa a ser el nombre (con el
    device_id tecnico como subtitulo pequeño, solo cuando son distintos).
    - DeviceCard: mismo ajuste para no duplicar el device_id como sub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
2026-09-07 Añade DS18B20 y aprovisionamiento WiFi por portal cautivo
    Sustituye las credenciales WiFi fijas por WiFiManager: un macetero sin
    red configurada monta su propio AP y sirve un portal de configuración,
    así que puede darse a alguien sin acceso al router sin reflashear nada.
    Añade también el DS18B20 para temperatura de sustrato (junto a la sonda
    de humedad de suelo) como nuevo campo temp_suelo en el JSON publicado.
    De paso se sube platformio.ini al repo por primera vez (vivía solo en
    la carpeta PlatformIO local, nunca se había versionado).
2026-09-07 Expone temp_suelo (DS18B20) en la API de lecturas
    Node-RED ya escribe el campo en InfluxDB; sin añadirlo a NUMERIC_FIELDS
    la API nunca lo devolvía aunque el dato ya estuviera guardado.
2026-09-07 Muestra temp_suelo en la app y corrige icono de login y modales
    - DeviceDetailScreen: nueva fila de resumen (humedad % + temp. de
    suelo) bajo el estado, y gráfica de temp_suelo junto a la de
    humedad en la categoría "Suelo".
    - LoginScreen: usa el icono real de la app (assets/icon.png) en vez
    del texto con emoji.
    - LocationsScreen, LocationDetailScreen, DeviceConfigScreen: los
    modales inferiores respetan ahora el safe-area del sistema
    (useSafeAreaInsets) para que Crear/Guardar/Cancelar no queden
    pegados a la barra de navegación de Android.
2026-09-07 Eje X de gráficas ligado al filtro elegido, resumen de ambiente y edición de nombre/descripción de ubicación
    - ReadingsChart: el formato del eje X (fecha vs hora) ahora depende
    del rango de filtro seleccionado (hours), no del rango real de los
    puntos devueltos. Antes, un campo con poco histórico (p.ej.
    temp_suelo recién añadido) mostraba un eje distinto al resto de
    gráficas solo por tener menos datos todavía. En rangos largos
    (2d/7d) el eje ahora muestra solo la fecha (dd/mm), más legible
    que fecha+hora apretujadas en 4 marcas.
    - DeviceDetailScreen: el resumen rápido bajo "Estado" ahora depende
    de la categoría seleccionada (humedad+temp. de suelo en "Suelo",
    tempe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
2026-09-07 Añade resumen periódico de salud de la planta (v1 basada en reglas, no ML)
    Cruza humedad de suelo, temperatura de suelo/aire e histórico de
    riegos para dar un veredicto simple (sana / revisar riego / revisar
    drenaje / datos insuficientes) cada pocos días, con push notification
    y consulta bajo demanda desde la app.
    - Nueva tabla watering_events: los eventos "riego_completado" del
    firmware no se guardaban en ningún sitio hasta ahora (solo
    disparaban una push y se descartaban) - sin persistirlos no hay
    forma de medir cuánto tarda el suelo en recuperarse tras regar.
    - Nueva tabla health_summaries: histórico de veredictos, no solo el
    último.
    - health_analysis.py: cálculo en Pyth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
2026-09-07 Corrige down_revision de la migración watering_events/health_summaries
    Apuntaba a cd15063a2c75 (catálogo de tipos de planta), que ya no era
    el head real - 8f25444aa69f (interior/exterior) y 7c32955724a5
    (lat/long en locations) se habían añadido después. Esto creaba dos
    heads en vez de encadenarse al final real de la historia.
2026-09-07 Aisla el fallo de un dispositivo en el job de salud del resto del lote
    Se vio en real en el primer despliegue: la tabla health_summaries no
    existía todavía cuando el cron disparó en el proceso antiguo, y ese
    error dejaba la sesión de BD abortada para el resto del bucle - con
    más de un dispositivo, habría cortado la evaluación de todos los
    siguientes por el fallo de uno solo. Ahora cada dispositivo va en su
    propio try/except con rollback, y un fallo puntual no afecta al resto.
2026-09-07 Quita "reclamar" de la pantalla de añadir dispositivo
    "Reclamar" suena más a variante latinoamericana del castellano - se
    sustituye por "Añadir"/"código de dispositivo" en el botón, el
    título de pantalla, las etiquetas y el mensaje de error.
2026-09-07 Cambia el texto del botón a "+ Añadir dispositivo"
    Más claro para el usuario que el "+ Dispositivo" anterior.
2026-09-07 Añade LICENSE con todos los derechos reservados
    El repo es un proyecto de portfolio, no software abierto. La ausencia
    de licencia ya implicaba copyright por defecto, pero se deja
    explícito para quien lo visite (reclutadores, procesos de selección):
    se puede consultar libremente, no reutilizar ni redistribuir sin
    autorización.
2026-09-11 Estado de la planta relativo al tipo de planta configurado
    El "estado" (SECO/NECESITA_RIEGO/OK/HUMEDO/EXCESO_AGUA) se calculaba
    en firmware con umbrales fijos (25/36/65/80%), sin conocer el tipo de
    planta de cada dispositivo - un cactus (humedad_min=15%) al 36% salía
    como "NECESITA_RIEGO", umbral que solo tenía sentido para el valor
    original por defecto. Viola el principio de que el ESP32 nunca decide,
    solo mide y publica.
    - Nueva columna plant_types.default_humedad_max / devices.humedad_max
    (migración + reseed de los 12 tipos de planta con un máximo real
    cada uno, no derivado con un margen fijo sobre el mínimo).
    - GET /api/internal/device-configs expone humedadMax para que Node-RE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
2026-09-11 Sincroniza flows.json con el calculo de estado relativo aplicado en la Pi
    El nodo "Formatear para InfluxDB" ya no copia el estado que manda el
    firmware tal cual: lo recalcula usando humedadMin/humedadMax del tipo
    de planta configurado en cada dispositivo (config_maceteros), en vez
    de los umbrales fijos que traia el ESP32 antes de esta sesion.
2026-09-11 Añade ritmo de secado del suelo al resumen de salud de la planta
    Nueva metrica tasa_secado_pct_h (pendiente media de bajada de humedad
    entre riegos) en health_analysis.py, comparada contra un ritmo
    "normal" estimado por tipo de planta (investigado a partir de guias
    de cuidado/horticultura reales, no inventado - ver el plan de esta
    iteracion para las fuentes). Solo enriquece el mensaje del resumen,
    no cambia el veredicto: es un valor estimado, no datos reales, y no
    deberia poder disparar una alarma por si solo.
2026-09-11 Corrige tiempo_saturado en el resumen de salud para usar humedad_max por tipo de planta
    pct_saturado comparaba contra un 85% fijo (SATURATION_THRESHOLD),
    heredado de antes de que existiera humedad_max por tipo de planta
    (anadido hoy). Mismo problema que el estado del firmware arreglado
    antes en esta sesion: para un cactus (humedad_max=32) nunca se
    disparaba aunque la humedad llevase dias muy por encima de lo que
    tolera ese tipo. No afecta al veredicto, que no usa esta metrica.
2026-09-11 Cierra el hueco del veredicto de salud: exceso de agua cronico sin riegos salia "Sana"
    El veredicto solo miraba humedad por debajo del minimo o recuperacion
    lenta TRAS un riego - sin ningun riego en la ventana esa segunda
    comprobacion nunca se evaluaba, asi que una planta empapada durante
    dias (ej. un cactus al 99% de tiempo_saturado) seguia saliendo "Sana".
    Nueva condicion: mas de la mitad del tiempo por encima de humedad_max
    tambien pasa a "revisar_drenaje", con su propio mensaje.
2026-09-11 Corrige tasa_secado_pct_h para no confundir ruido del sensor con secado real
    La formula original contaba cualquier bajada puntual entre lecturas
    consecutivas sin restar las subidas que la compensan - en una señal
    plana con ruido (42-41-42-41...) eso da una tasa positiva aunque el
    suelo no se este secando de verdad. Ejemplo real detectado por Luis:
    macetero01 llevaba dias estancado en exceso de agua (99% tiempo
    saturado) y aun asi salia "se seca mas rapido de lo habitual".
    Ahora mide tramos reales de bajada sostenida (maximo local -> minimo
    local, minimo 3h) en vez de paso a paso. Verificado con casos
    sinteticos: señal plana con ruido -> None (antes daba positivo),
    secado real 70->30% en 4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
2026-09-11 Calibracion del sensor de humedad de suelo desde la app, sin reflashear
    Hasta ahora recalibrar el sensor de humedad de suelo (SOIL_DRY/SOIL_WET
    en firmware) exigia reflashear. Se reutiliza el mecanismo de config por
    MQTT (retained) construido hoy mismo para humedadMin/humedadMax:
    - Firmware: SOIL_DRY/SOIL_WET pasan de constantes a variables
    (soilDryCfg/soilWetCfg), actualizables via mqtt_topic_config. El
    valor crudo del ADC (humedad_suelo_raw) se publica ahora en cada
    ciclo, no solo el porcentaje ya convertido.
    - Backend: nuevas columnas devices.soil_dry_raw/soil_wet_raw (por
    dispositivo, no por tipo de planta - es calibracion fisica del
    sensor/sustrato). Nuevo POST /devices/{id}/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
2026-09-11 Aclara el mensaje de salud cuando exceso de agua y secado rapido coinciden, y justifica el texto
    Antes "El suelo ha estado por encima del maximo... 99%..." y "Se seca
    mas rapido de lo habitual" en el mismo mensaje sonaban contradictorios.
    Cuando el secado rapido coincide con saturacion cronica, ahora se
    enlaza como buena noticia ("de todas formas... hara que vuelva a
    niveles normales en breve") en vez de una alarma aparte.
    De paso, texto del resumen de salud justificado (antes centrado).
2026-09-11 Revierte el texto de salud a centrado: justify no se aplica de verdad en Android
    textAlign: "justify" se quedaba en la practica como texto alineado a
    la izquierda con el margen derecho irregular en el Android real de
    Luis (soporte incompleto/inconsistente de RN en Android, a diferencia
    de iOS). Sin justificacion de verdad, centrado es mejor que la mitad
    del efecto.
2026-09-11 Quita el logo de fabrica del OLED congelado durante la conexion WiFi/MQTT
    display.begin() deja dibujado el logo de fabrica de Adafruit_SSD1306,
    y nada lo vuelve a tocar hasta el primer ciclo del loop() - que no
    llega hasta que WiFi (a veces lento o con reintentos, sobre todo con
    alimentacion de pared en vez de USB del ordenador), NTP y MQTT
    terminan. Daba la sensacion de que el dispositivo se quedaba colgado.
    Ahora se limpia la pantalla y se muestra "Conectando..." justo despues
    de inicializar el OLED.
    Pendiente de reflashear macetero01 - requiere conectarlo por USB.
2026-09-18 Sincroniza flows.json: humedad_suelo_raw ahora llega a InfluxDB
    Bug real detectado antes de usarse por primera vez: el nodo
    "Formatear para InfluxDB" reconstruye el payload con una lista fija de
    campos, y humedad_suelo_raw (publicado por el firmware desde la
    semana pasada, para el endpoint de calibracion) no estaba en esa
    lista - nunca llegaba a InfluxDB, así que get_latest_value() habria
    devuelto siempre None y POST /calibrate habria fallado siempre.
2026-09-18 Actualiza la documentacion al estado real del proyecto
    Los docs se habian quedado atras de varias semanas de trabajo real:
    - architecture.md/hardware.md: la calibracion del sensor de humedad
    ya no esta fija en firmware, se hace desde la app (documentado el
    mecanismo). Modelo de datos de InfluxDB actualizado con temp_suelo
    y humedad_suelo_raw, que faltaban.
    - platform/README.md: corregida una afirmacion que llevaba tiempo
    siendo inconsistente con el resto del propio documento - ca.key SI
    vive en la Raspberry Pi (cifrada), no en una maquina separada.
    - troubleshooting.md: 5 entradas nuevas (22-26) con los problemas
    reales encontrados y diagnosticados esta semana (ACL de Mosquitto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
2026-09-22 Diagnostico visual de la planta con IA (foto + contexto de sensores)
    Complementario al resumen de salud estadistico, no un reemplazo: hay
    sintomas (hojas amarillas, plaga, marchitez) que ningun sensor de
    suelo puede ver. El usuario sube una foto desde la app; el backend la
    junta con un resumen de los ultimos 5 dias de sensores y se la manda
    a Claude (vision) para una valoracion cualitativa, con su propio
    veredicto de tres niveles (bien/revisar/preocupante) distinto del
    HealthVerdict estadistico.
    - Backend: tabla nueva plant_photo_diagnoses (una fila por
    dispositivo, se sobreescribe - la foto vive como bytea en Postgres,
    no en el filesystem). Antes de sobreescribir, la foto anterior se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
2026-09-22 Cambia el diagnostico visual de Claude a Gemini (nivel gratuito)
    Luis prefirio coste cero sobre la API de pago de Claude para este uso
    a demanda (unas pocas fotos por semana) - la contrapartida consciente
    es que en el nivel gratuito de Gemini, Google puede usar el contenido
    enviado para mejorar sus productos (en el de pago, no), aceptable
    para una foto de planta. Documentado el porque en
    docs/architecture.md.
    SDK google-genai en vez de anthropic - verificado el uso real de
    types.Part.from_bytes() y client.models.generate_content() contra el
    paquete instalado antes de escribir el codigo final, no adivinado.
2026-09-22 Registra el error real cuando falla el diagnostico visual
    El 502 solo devolvia un mensaje generico al cliente sin dejar nada en
    el log - HTTPException no imprime traceback como una excepcion sin
    capturar. Necesario para diagnosticar el primer fallo real en
    produccion.
2026-09-22 Reintentos ante 503 de Gemini y evita bloquear el event loop
    Confirmado en produccion: el nivel gratuito de Gemini devolvio 503
    "high demand" dos veces seguidas para macetero01, sin ningun error de
    nuestro lado (clave, formato de peticion, todo correcto). Se reintenta
    hasta 3 veces con 5s de espera - solo ante ServerError (5xx), un
    ClientError (clave invalida, peticion mal formada) sube sin reintentar
    porque reintentar no lo arregla.
    De paso, el endpoint paso de async def a def: con los reintentos
    podia bloquear hasta ~10-15s el unico worker de Uvicorn (sin
    --workers en el systemd), dejando sin atender cualquier otra
    peticion mientras tanto (incluido el sondeo de Node-RED cada 60s).
    FastAPI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
2026-09-22 Cambia el modelo a gemini-3.5-flash-lite: el alias "latest" estaba saturado de verdad
    Confirmado en produccion, no un pico puntual: 5 intentos repartidos en
    15 minutos contra gemini-flash-latest, todos 503 "high demand" -
    esperable, es el modelo insignia mas nuevo y todo el mundo en el nivel
    gratuito apunta ahi por defecto. gemini-3.5-flash-lite es un modelo
    concreto (no un alias que cambia solo), explicitamente el recomendado
    por Google para cuentas nuevas, con imagen soportada, y mucha menos
    contencion al ser mas barato de servir - de sobra para valorar una
    foto de una planta.
2026-09-22 Cambia el diagnostico visual de Gemini a Groq: el "gratis" de Google no lo era
    Confirmado en produccion (troubleshooting #27): el nivel gratuito de
    Gemini devolvia 503 "high demand" de forma sostenida contra dos
    modelos distintos durante 15 minutos - no un pico puntual. Reproducir
    la misma foto directamente en Google AI Studio (misma cuenta, sin
    pasar por nuestro codigo) confirmo la causa real: un dialogo "Upgrade
    to unlock more" pidiendo facturacion. La cuenta reutilizada ya tenia
    uso previo y el nivel gratuito estaba topado de verdad, no era un
    problema de capacidad del servicio.
    Groq si tiene un plan gratuito real y publicado (limites por dia y
    minuto documentados, no un trial), sin tarj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
2026-09-22 Corrige bug real: el diagnostico visual nunca mandaba los datos de sensores al modelo
    Detectado por una pregunta de Luis, no por un error - la peticion daba
    200 OK con una respuesta plausible, pero al reescribir plant_vision.py
    para Groq (commit d6829d2) se perdio la linea que anadia el contexto
    de sensores ya construido al mensaje real enviado al modelo. Se
    calculaba, se guardaba en una variable, y nunca se usaba. El modelo
    solo veia la foto.
    De paso, reforzadas las instrucciones para pedir explicitamente que
    compare la foto con los datos de sensores y señale contradicciones
    entre ambos, y anadido un log del contexto enviado para poder
    verificarlo en el futuro sin depender de adivinar por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
2026-09-22 Corrige created_at congelado tras la primera foto de diagnostico visual
    server_default=func.now() solo aplica en INSERT, no en UPDATE - como
    plant_photo_diagnoses guarda una sola fila por dispositivo que se
    sobreescribe, la segunda captura y siguientes nunca tocaban created_at.
    Se fija a mano en la rama de actualizacion del endpoint.
2026-09-22 Analiza el veredicto de forma tolerante al formato real del modelo
    Confirmado en produccion: el modelo no siempre respeta el salto de
    linea pedido en el prompt ("Bien\nResto...") - a veces escribe
    "Bien. Resto..." todo seguido, lo que hacia fallar el analizador
    estricto (partition en "\n") con un 502 aunque la respuesta fuera
    perfectamente valida.
    Ahora se busca la palabra clave al principio del texto con una
    expresion regular que tolera puntuacion, guiones y saltos de linea
    indistintamente antes del resto del mensaje - verificado con los
    casos reales vistos en el log de produccion.
2026-09-22 Pone al dia toda la documentacion con el diagnostico visual y su despliegue
    README.md raiz: nueva funcionalidad en "Que hace", checklist de
    estado, y el hallazgo del "nivel gratuito" en problemas reales.
    backend/README.md: GROQ_API_KEY en la tabla de variables, requisito
    nuevo, estructura del proyecto actualizada (arrastraba desde antes de
    hoy - le faltaban WateringEvent/HealthSummary), paso 7 de verificacion.
    mobile/README.md: expo-image-picker y como sube fotos client.ts.
    platform/README.md: seccion de despliegue completa para la Pi, con el
    aviso real sobre acumular variables *_API_KEY en el .env al cambiar de
    proveedor (el fallo de arranque que tuvimos hoy mismo).
    docs/troubleshooting.md: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
2026-09-22 Detalla proveedor, modelo y limites de Groq en el diagnostico visual
    Anade el nombre exacto del modelo (qwen/qwen3.8-27b), que es Groq
    como proveedor de inferencia y los limites reales del plan gratuito,
    para tener la referencia completa de cara a explicar la funcionalidad.
2026-09-29 Anade el diseno CAD del macetero de riego automatico (structure/)
    Modelo parametrico en Python/numpy (SDF + surface nets, sin CAD
    externo) de las 7 piezas imprimibles: cubeta con deposito y bahia
    electronica, tapa, maceta, cesta de drenaje, tapon, tapa de bahia y
    rejilla. Incluye verificacion numerica (41 puntos de control, 0
    interferencias entre piezas) y renders reales generados con el propio
    render.py como documentacion visual.
    No se versionan los STL ni el cache de malla: se regeneran localmente
    con build.py y pesan varios cientos de MB, no aportan nada en git que
    el codigo fuente no de ya. build.py tambien deja de escribir un cache
    en /tmp que no usaba ningun otro script y rompia en Wi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
2026-09-29 Adapta el BOM del macetero a la electronica actual (ESP32 DevKit + bomba sumergible)
    En vez de migrar a ESP32-C3 + bomba peristaltica como asumia el
    documento original, se reutiliza la electronica que ya corre en
    produccion en macetero01. Documenta el cambio de geometria que todavia
    falta aplicar en design.py/params.py: la bomba sumergible vive dentro
    del deposito, no en la bahia seca, asi que su cable necesita un camino
    de salida por arriba en vez del tubo de aspiracion que asumia la
    peristaltica.
2026-09-29 Mueve la bomba del macetero al deposito (sumergible, no peristaltica)
    El canal de la tapa superior que antes llevaba el tubo de aspiracion
    de una bomba peristaltica ahora lleva el cable de alimentacion de una
    bomba sumergible que vive suelta en el suelo del deposito, junto a la
    electronica actual (ESP32 DevKit) en vez de un ESP32-C3 nuevo. Se
    ensancha 2 mm el canal para dar margen a un conector pequeno. Sigue
    sin haber ningun agujero por debajo del nivel maximo de agua.
    Reverificado con test.py: 41/41 puntos de control, 0 interferencias.
    reporte.json regenerado con build.py (solo cambia tapa_superior, la
    unica pieza tocada). Montaje y lista de materiales del README puestos
    al dia para el pr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
2026-09-29 Regenera los renders afectados por el cambio de bomba sumergible
    01_cubeta_base, 03_maceta, 04_cesta, 05/06/07 y las vistas de conjunto
    salen bit a bit identicas (el cambio es un canal interno oculto bajo
    la tapa). Solo difieren 02_tapa_superior y las dos vistas
    explosionadas, que si incluyen esa pieza.
2026-09-29 Anade una ficha tecnica autocontenida del macetero (structure/ficha_tecnica.html)
    Un unico archivo HTML con las imagenes incrustadas en base64 (sin
    dependencias externas ni conexion a internet salvo la tipografia) -
    se abre haciendo doble clic, sin necesitar el enlace privado de
    claude.ai. Mismo contenido que la ficha publicada como Artifact:
    renders reales, cotas con lineas de medida calculadas contra la
    camara real, y el aviso de la pantalla pendiente.
2026-09-30 Anade una visualizacion conceptual del macetero (concepto_visual.jpg)
    Imagen generada con IA (no una foto real ni un render del CAD) para
    transmitir de un vistazo como quedaria el producto acabado en un
    entorno domestico. Documentada en el README como tal, distinta de los
    renders reales en preview/ y ficha_tecnica.html, para no confundirla
    con una representacion fiel de la geometria (p.ej. no muestra el
    saliente de la torre de llenado, y la pantalla que aparece sigue
    siendo aspiracional, no confirmada en el CAD).
2026-09-30 Anade structure/ al listado de carpetas del README raiz
    Se habia quedado fuera desde que se creo la carpeta - el listado de
    "Estructura del repositorio" no se actualizo en su momento.
2026-10-01 Duracion de riego editable por tipo, pausa temporal del sensor, y arboles en el catalogo
    Tres piezas relacionadas, pedidas juntas en la misma sesion:
    - La duracion del riego (duracion_riego_ms) existia por tipo de planta
    en el catalogo desde el principio, pero nada en la cadena end-to-end
    la aplicaba nunca (ni el selector de la app la copiaba, ni el PATCH
    del backend la aceptaba) - por eso un cactus regaba igual que
    cualquier otra planta. Ahora es editable y se copia al elegir tipo.
    Ver troubleshooting #31.
    - Pausa temporal del sensor de humedad (10 min, autoexpira por
    timestamp): un boton en la app para mover la planta/el sensor sin
    que una lectura de transicion "seco" dispa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
2026-10-01 Fusiona el diagnostico de salud en una sola tarjeta, y acelera el % en vivo durante la pausa del sensor
    Diagnostico: la pantalla de salud mostraba dos tarjetas de veredicto
    independientes (sensores + foto). El prompt de la IA ya mezcla foto y
    sensores en un unico mensaje (ver plant_vision.py), asi que la app
    ahora muestra solo uno: el de la ultima foto analizada con exito si
    existe, si no el del resumen por sensores. Cambio puramente de
    presentacion en el movil - ningun endpoint ni esquema del backend
    cambia. Un intento fallido de analizar una foto nueva no pierde la
    ultima foto valida (photoQuery no cambia si el POST falla).
    Pausa del sensor: la rotacion del OLED (~20s por pantalla) result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
2026-10-01 Arregla la subida de fotos (Expo SDK 57) y la miniatura con 401, encontrados probando en movil real
    Dos bugs reales, encontrados y verificados en vivo en el dispositivo de
    Luis (la primera vez que este codigo se ejecutaba fuera de Swagger):
    - Subir foto fallaba con "Unsupported FormDataPart implementation".
    Expo SDK 57 instala expo/fetch como fetch global, cuyo codificador de
    FormData ya no acepta el objeto legacy de RN {uri, name, type} - solo
    string, Blob real, u objeto con bytes(). Arreglado leyendo el fichero
    local como Blob real via fetch(uri).blob(), sin depender de ningun
    modulo nativo nuevo (evita una build de EAS solo para esto). Ver
    troubleshooting #32.
    - La miniatura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
2026-10-01 Amplia el catalogo con 27 plantas/arboles comunes de interior, en 6 categorias
    A peticion de Luis (lista curada por el mismo de plantas que se
    suelen tener en casa, incluida la planta del dinero). El catalogo
    pasa de 15 a 42 tipos - "planta"/"arbol" se quedaba corto para un
    selector usable, asi que se reclasifica en 6 categorias: planta
    (general/huerto), hoja_grande, colgante, crasa, palmera, arbol. La
    suculenta-cactus original se reclasifica de "planta" a "crasa" de
    paso.
    Mismo metodo que el resto del catalogo para cada entrada nueva:
    default_tasa_secado_max_pct_h = (humedad_max - humedad_min) / horas
    tipicas entre riegos segun guias de cultivo en maceta reales -
    heuristicas de arranque, n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
2026-10-01 Quita los nombres cientificos del catalogo, solo nombre comun
    Luis lo señalo revisando el selector en la app: "Ficus lyrata",
    "Beaucarnea recurvata" etc. son impronunciables y no dicen nada al
    usuario sin leer el resto entre parentesis - mala UX. Se deja solo el
    nombre por el que se conoce la planta en la calle (25 entradas del
    catalogo de hoy + "Potos", que arrastraba "(Epipremnum)" desde el
    catalogo original).
2026-10-01 Anade Planta del dinero (Plectranthus verticillatus) al catalogo, distinta del Arbol del dinero
    Mismo apodo popular que Pachira aquatica (ya en el catalogo como
    "Arbol del dinero"), pero es otra planta: familia de la menta,
    habito colgante/rastrero, nada de tronco ni porte de arbol. Se
    distingue por el nombre ("Planta" vs "Arbol") y la categoria
    (colgante vs arbol) para que no se confundan en el selector.
2026-10-01 Anade GET /devices/{id}/latest-readings para la fila-resumen y el banner de pausa en vivo
    Luis lo detecto probando el sensor en vivo: el OLED cambiaba pero la
    app se quedaba igual. Causa real: /readings agrega a 1m/10m/1h segun
    el rango pedido (10m para las 24h por defecto) - el "ultimo punto" de
    ahi puede tardar hasta 10 minutos en reflejar un cambio real, aunque
    la app sí estuviera preguntando cada pocos segundos.
    Nuevo endpoint de solo lectura, sin agregar (mismo patron que ya usa
    influx_client.get_latest_value() para /calibrate), devuelve el ultimo
    valor real de cada campo numerico. La fila-resumen de
    DeviceDetailScreen y el banner de pausa del sensor lo usan ahora en
    vez del ultimo pu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
2026-10-01 Pone al dia toda la documentacion con el resto de la sesion de hoy
    Los ultimos 4 commits del dia (catalogo ampliado a 43 tipos en 6
    categorias, nombres sin latin, planta del dinero distinta del arbol
    del dinero, y el endpoint /latest-readings) se habian desplegado y
    verificado pero nunca quedaron documentados en el repo - solo se le
    dieron los comandos a Luis por chat. Arreglado:
    - README.md: cuenta del catalogo actualizada (12 -> 43), nuevas
    funcionalidades (diagnostico fusionado, pausa de sensor, duracion
    por tipo) en "Que hace" y el checklist, nuevo problema real resuelto
    (el regression de FormData en Expo SDK 57).
    - platform/README.md: seccion de despliegue para los 4 commits que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
2026-10-01 Corrige inconsistencias reales encontradas al releer la documentacion de principio a fin
    Tres parrafos describian el estado anterior a los arreglos de hoy:
    - backend/README.md: la nota sobre aggregateWindow() no distinguia
    /readings (agregado) de /latest-readings, /calibrate y la config de
    Node-RED (sin agregar, a proposito) - podia leerse como una
    contradiccion con el paso de verificacion 9 justo encima.
    - docs/architecture.md § "Pausa temporal del sensor": seguia diciendo
    que el banner en vivo leia /readings a 30s/3s - el arreglo real
    (troubleshooting #34) lo cambio a /latest-readings a 15s/3s, nunca
    se actualizo este parrafo.
    - docs/architecture.md § "Catalogo de tipos de p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
2026-10-02 Soporte para macetero02 (DHT22, sin presion, con humedad ambiente)
    Firmware nuevo (firmware/macetero02_dht22.ino): mismo esqueleto real
    de produccion que macetero_produccion_6.ino (WiFiManager, mTLS, riego
    no bloqueante, config por servidor via MQTT retained) - se ha quitado
    por completo la decision de riego local que traia el sketch de
    pruebas original, que violaba el principio central del proyecto ("el
    ESP32 nunca decide"). Solo cambia la parte de sensores: DHT22 en vez
    de BMP280 (pines reales de esta placa: DHTPIN=4, DS18B20 movido a
    GPIO18, bomba en GPIO26). Publica humedad_ambiente, no publica
    presion - ni con un 0 falso ni con el campo forzado, simplemente
    ausente, igual que temp_suelo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
2026-10-02 Formatear para InfluxDB: escribe presion/humedad_ambiente solo si el dispositivo los publica
    Ultima pieza para macetero02. Se construye el objeto de fields
    incrementalmente en vez de listarlo todo de golpe - presion y
    humedad_ambiente solo se anaden si msg.payload los trae de verdad
    (!== undefined), nunca con un valor por defecto. Para macetero01 el
    comportamiento es identico al de antes (sigue mandando presion, nunca
    humedad_ambiente); para macetero02 es al reves.
2026-10-02 Humedad ambiente integrada en el diagnostico (health_analysis + IA de foto)
    health_analysis.py: nueva rama de veredicto - ambiente humedo (>70%
    de media) junto con saturacion de suelo moderada (>30%, mas baja que
    el 50% que ya dispara la alarma por si solo) adelanta revisar_drenaje.
    Fundamento: la evapotranspiracion la rige el deficit de presion de
    vapor del aire (base de ET0/Penman-Monteith, estandar agronomico para
    riego) - a mas humedad relativa, el agua sobrante tarda mas en
    evaporarse sola, mismo dato de suelo es mas grave en aire humedo.
    Deliberadamente unidireccional: aire seco nunca silencia una alarma
    existente, solo se usa como texto explicativo (sequedad de suelo o
    secado rapido p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
2026-10-02 Documenta limpieza de Node-RED (config muerta + dashboard Monstera) y Grafana escalable
    Node-RED ya no tiene UI propia: se retiraron en vivo (no hay diff de
    flows.json pendiente de sincronizar, ver nota abajo) 13 nodos de
    configuracion muerta (slider/desplegables hardcodeados a macetero01
    que el poller real sobreescribia cada 60s, uno de ellos sin ni
    siquiera cable de salida) y el dashboard "Monstera" completo
    (redundante frente a la app y Grafana). El reparto final queda: app =
    control, Grafana = historico, Node-RED = orquestacion pura.
    Grafana: documentada la variable ${device} (v1.tagValues, autoalimentada)
    que sustituye el device_id fijo en cada panel, y los 2 paneles nuevos
    (Temperatur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
2026-10-02 Resincroniza flows.json y dashboard.json con el estado real en la Pi
    Reexportados desde los editores en vivo tras la limpieza de hoy
    (commit 1da61d9): flows.json ya no tiene los 13 nodos de config
    muerta ni el dashboard "Monstera"; dashboard.json tiene la variable
    ${device} y los 5 paneles (los 3 originales + Temperatura de suelo +
    Humedad ambiente), confirmado que ninguno lleva ya "macetero01" fijo.
    Token real de X-Internal-Token encontrado en texto plano en el nodo
    "solicitud http" del export y redactado antes de commitear (mismo
    placeholder que ya se usaba: "<INTERNAL_API_TOKEN - rellenar a mano
    tras importar, no se versiona>") - no llego a subirse al remoto en
    ningun momento, se detecto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
2026-10-02 Marca flows.json/dashboard.json como ya resincronizados
    Las dos notas de "pendiente de reexportar" quedaron resueltas con el
    commit ba545fc.
2026-10-02 Lectura completa de toda la documentacion: corrige staleness real no detectada antes
    Pedido explicito de Luis: que todo este al dia "por si lo ven o lo
    muestra", no solo que el diff de hoy sea correcto. Lectura de
    principio a fin de README.md, docs/architecture.md, backend/README.md,
    mobile/README.md, firmware/README.md y docs/hardware.md (no solo
    grep/diff) encontro varias referencias reales al dashboard de Node-RED
    que nunca se habian tocado al documentar su retirada:
    - README.md: el diagrama de arquitectura todavia mostraba una caja
    "Dashboard web" (el dashboard de Node-RED borrado hoy) y ni siquiera
    incluia el backend ni la app, pese a ser el flujo de control real
    desde hace meses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
2026-10-13 Duracion de riego real por dispositivo, y filtro de lecturas implausibles del DHT22
    Dos bugs reales encontrados tras varios dias de uso con macetero02,
    ambos cronometrando/observando el dispositivo fisico, no por lectura
    de codigo previa - ver docs/troubleshooting.md #35 y #36 para el
    diagnostico completo.
    1) La duracion de riego configurada por tipo de planta (DeviceConfigScreen,
    PATCH /api/devices/{id}) nunca llegaba al ESP32. El troubleshooting
    #31 cerro la cadena app->Postgres pero nadie verifico el extremo
    fisico: el firmware de los dos dispositivos tenia TIEMPO_RIEGO como
    constante fija (9000ms) y el parser de mqtt_topic_config nunca leia
    duracionRiegoMs. Fix end-to-end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
2026-10-13 Salud de la planta pasa a ser la pantalla principal del dispositivo
    Pedido de Luis tras el uso real: el usuario no profano no entiende
    las graficas de DeviceDetailScreen, pero si entiende un veredicto de
    salud. Swap de pantallas, sin duplicar controles por ahora (riego/
    pausa/configuracion se quedan solo en la pantalla secundaria, a ver
    como va la experiencia de uso antes de decidir si hace falta mas):
    - LocationDetailScreen navega a DeviceHealth al tocar un dispositivo
    (antes iba a DeviceDetail).
    - DeviceHealthScreen gana cabecera (nombre del dispositivo + estado,
    mismo patron que ya tenia DeviceDetailScreen) y un boton "Mas
    informacion" que navega a DeviceDetail.
    - DeviceDetailScree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
2026-10-24 Reestructura la pantalla de Salud: veredicto -> foto -> mensaje, un solo boton de actualizar
    Tres cambios de experiencia de usuario pedidos por Luis tras el uso
    real:
    1) La foto pasa a estar dentro de la tarjeta de veredicto, entre la
    etiqueta (Sana/Preocupante/...) y el mensaje de texto de la IA +
    sensores - antes vivia muy por debajo, en su propia seccion aparte.
    2) "Actualizar foto" y "Recalcular por sensores" se funden en un solo
    boton ("Actualizar diagnostico"): el dialogo ahora ofrece hacer
    foto, elegir de galeria, o "Solo sensores (sin foto)" para cuando
    no se puede hacer una foto en ese momento (fuera de casa). Subir
    una foto nueva tambien refresca el resumen por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
2026-10-24 Teclado tapando campos, TextInput en blanco, y confirmacion al cambiar tipo de planta
    Tres fallos/mejoras reales encontrados por Luis usando la app, ver
    docs/troubleshooting.md #37 y #38 para el diagnostico completo:
    1) LoginScreen y DeviceConfigScreen ganan KeyboardAvoidingView (mas
    ScrollView real en LoginScreen, que antes era un View fijo no
    desplazable) - el teclado podia tapar el campo activo sin forma de
    verlo mientras se escribia.
    2) Los TextInput de DeviceConfigScreen que dependen de datos cargados
    de forma asincrona (nombre, humedad minima, horas, duracion) ganan
    un key={`campo-${isInitialized}`} - bug conocido de Android donde
    un TextInput controlado a veces no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
2026-10-24 Nombre amigable en notificaciones, recordatorio de foto, y ajuste automatico de la duracion de riego
    Tres mejoras de backend pedidas por Luis:
    1) notify_owner() resuelve device.name (o device_id de respaldo) y lo
    sustituye en cualquier body que traiga el marcador "{device_name}"
    - "Riego completado"/"Dispositivo desconectado" ya no muestran el
    device_id en crudo.
    2) El aviso periodico de salud (cada ~4-5 dias) deja de mandar el
    mensaje de solo-sensores cuando la ultima foto analizada tiene mas
    de 10 dias (o no existe ninguna) - en su lugar recuerda subir una
    foto nueva, porque sin ella el mensaje "dice cosas a medias" (ver
    plant_vision.py). result.message no se toca, s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
2026-10-24 Documenta el pase de UX/backend de hoy: reestructura de Salud, formularios, ajuste automatico de riego
    docs/architecture.md: razonamiento completo del ajuste automatico de
    duracion (por que se basa en el veredicto de humedad y no en contar
    riegos, por que tiene tope relativo y notificacion siempre) y su
    conexion con el punto 4 del roadmap. docs/troubleshooting.md: #37
    (TextInput en blanco en Android, fix con key) y #38 (teclado tapando
    campos, fix con KeyboardAvoidingView). README.md: nuevo bullet en
    "Que hace", dos entradas en el checklist de "Estado actual", y un
    ejemplo mas en "Problemas reales resueltos". platform/README.md:
    pasos de despliegue (migracion c4e8a2f91b7d + restart, sin refl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
2026-10-26 Backend: limite de intentos de login, estado de conexion, historial de riegos con origen, varios moviles por cuenta y aviso semanal
    - Login/registro con bloqueo temporal por email e IP (429 + Retry-After)
    - GET /devices/status (ultimo dato en InfluxDB) y GET /devices/{id}/watering-events
    - watering_events.origen (manual/automatico) y correccion de la hora local de Madrid
    etiquetada como UTC, con migracion de datos (a8f2d6b41c93)
    - push_tokens: varios tokens por usuario, baja al cerrar sesion (e5b9c3a72d18)
    - Resumen de salud sin notificacion; aviso semanal por macetero los domingos 11:00 Madrid
2026-10-26 App: historial de riegos, estado conectado/sin conexion y baja del token al cerrar sesion
2026-10-26 Copia de seguridad cifrada hacia el PC y documentacion del bloque del 2026-10-26
